Matthew-Marsicano/BEACON_PhoneModule/docs/DESIGN_NOTES.md

# BEACON Phone Module: KiCad translation and completion notes

- **Schematic source:** `C:\Users\marsi\Downloads\BeaconPhoneModule.pdf` (Altium, 9 sheets, 11/2/2026).
- **Enclosure:** `beacon_phone_magsafe_2p5mm_Latest.scad`, a MagSafe puck on the back of the phone.

Everything in the KiCad project is generated by the scripts in `scripts/`. Edit `design.py`, `parts.py` or `build_pcb.py` and regenerate; don't hand-edit the schematics or the board.

```
D:\KiCAD\bin\python.exe -I scripts\design.py      # schematics, BEACON.kicad_sym, BEACON.pretty
D:\KiCAD\bin\python.exe -I scripts\build_pcb.py   # outline, holes, footprints, RF chains, placement
D:\KiCAD\bin\python.exe -I scripts\route.py       # fanout, planes, rules, Freerouting, stitching, pours
D:\KiCAD\bin\python.exe -I scripts\finish.py      # silkscreen clean-up, labels, zone refill
D:\KiCAD\bin\python.exe -I scripts\export_fab.py  # Gerbers/drill zip, JLC BOM + CPL, PDFs, STEP
```

## Inferred specifications (no spec document was supplied)
| Item | Value |
|---|---|
| Form factor | MagSafe puck: 59.2 × 82.65 × 14.3 mm PETG, N52 ring and clocking magnet in the floor |
| Board | 55 × 78.45 × 1.6 mm, 4-layer JLC04161H-7628, r = 3 mm corners, 1.5 × 7.1 mm notch for the TX jack, 4× M2 into heat-set inserts |
| Host link | USB-C receptacle (GCT USB4105) at the bottom edge; short C-to-C cable to the phone; USB 2.0 FS; 5 V at about 0.33 A |
| TX | LMX2582 2.4 GHz CW → 3 dB pad → CC2595 (about +20 dBm) → LPF → Cinch 142-0711-821 end-launch SMA → Taoglas GW.26.0111 monopole |
| RX | Taoglas WDP.2458.25.4 25 × 25 mm ceramic patch at the board centre (pin-fed, fed from B.Cu) → BPF → QPL9547 LNA → nRF52840 |
| Control | nRF52840 (LDO mode): SPI to the synth, PA_EN, LNA shutdown, 2× INA219, LED, button, UART and SWD test pads |
| Power | 5V_BUS → 50 mΩ / INA219 0x40 → 5V0 → LT80602 (FCM, 506 kHz) → 3V3_OUT → 50 mΩ / INA219 0x41 → 3V3 |

## Changes from the Altium drawing
**Fixes (the original would not have worked):**
1. **The CC2595 RF_OUT had no DC feed.** Added 12 nH from VDD_PA, non-magnetic (LQW15AN12NJ00D).
2. **The CC2595 RBIAS resistors went to GND.** They now go through 20k to VDD_PA, per the TI EM.
3. **The LT80602 exposed pad is VIN,** so it connects to 5V0. The FB divider was 681k/220k but RFB-BOT can be at most 205k; it is now 634k/200k. FCM mode with a 0.1 µF BST cap.
4. **The 5 V INA219 measured nothing,** because the buck tapped 5V_BUS ahead of the shunt. The buck now runs from 5V0.
5. **The wearable-only MCU nets were removed:** CTRL_SPDT, Mod_Sel, PMIC_Status, Sensor_*, QSPI_CLK.
6. **The CW synth sheet is complete:**
   - TCXO, decoupling, OUTA/OUTAM.
   - Loop filter designed for a 52 MHz PFD and 7.27 mA charge pump: about 59 kHz bandwidth, 62° phase margin.
7. **Top-sheet TODOs:**
   - TX/RX antenna connections: the patch and the edge SMA, per the enclosure.
   - PA GND connected.
   - MCU and synth completed.

**Enclosure-driven changes:**
- **USB-C plug → receptacle,** with CC1 and CC2 Rd. The puck connects by cable.
- **Ferrite parts out of the magnet field** (`docs/magnetics_thermal.md`):
  - The nRF DC/DC inductors are DNP, and REG1 runs in LDO mode (firmware DCDCEN = 0).
  - The three ferrite beads became 1 Ω (PA), 10 Ω (LNA) and 0 Ω (synth) with the existing caps.
  - The buck inductor, crystal and TCXO are kept out of the clocking-bar zone.
- **Patch feed:** runs on B.Cu over a GND island on L3, then through one RF via to L1. Pi-match footprints sit at the patch.
- **SMA launch:** has an L3 GND island under it (L2 is voided in the footprint).

**Other improvements:**
- 50 mΩ shunts.
- LNA on 5V0 and off at reset.
- PA and synth off at reset.
- RX overload pi pad (DNP shunts).
- DNP ESD chokes at both antennas.
- 33 Ω series resistors on the SPI lines.
- USB pair renamed `USB_D+`/`USB_D-`.

## Supporting documents
- `enclosure_constraints.md/.json`: board outline, holes, keepouts and height limits, extracted with OpenSCAD.
- `antenna_connectors.md`, plus the reviewed footprints in `proposed_footprints/` (copied into `BEACON.pretty`).
- `magnetics_thermal.md`: field map, part sensitivities, thermal budget (about 1.6 W, board 53–55 °C) and firmware limits.
- `footprint_review.md`, `schematic_review.md`, `lmx2582_loop_filter.md`, `stackup_and_rules.md`.

## Open items before ordering
- **Patch tuning:**
  - Tune the patch match with a VNA, in the closed enclosure, on a phone. The patch is narrow (about 20–25 MHz at −10 dB), so keep the RX channels at 2430–2455 MHz.
  - Confirm the patch polarisation axis against the TX monopole.
- **Regulatory and exposure:** +20 dBm CW needs frequency hopping (FCC 15.247) and an RF-exposure evaluation at 5 mm.
- **Firmware thermal limits:** throttle TX at 60 °C, turn off at 68 °C, and default to a 25–50 % TX duty cycle.
- **Magnet field check:** measure the field over the board area with a Hall probe. If the ring band reads above 20 mT, keep all ferrites away from it.
- **JLC options:** POFV via-in-pad for the nRF52840 inner balls; ENIG finish; impedance control (0.30/0.20 mm CPWG); confirm the 0.45 mm plated slot.
- **Enclosure:** apply the USB and SMA dimension corrections (`enclosure/CHANGES.md`).
