Matthew-Marsicano/BEACON_PhoneModule/docs/layout_review/power_after.png

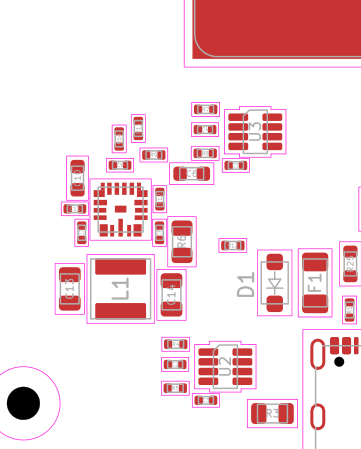
docs/layout_review/power_after.png
