Matthew-Marsicano/BEACON_PhoneModule/docs/layout_review/power_before.png

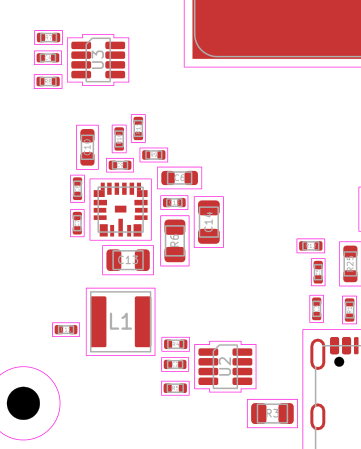
docs/layout_review/power_before.png
