Matthew-Marsicano/BEACON_PhoneModule/docs/layout_review/ref_lt80602_fig73.png

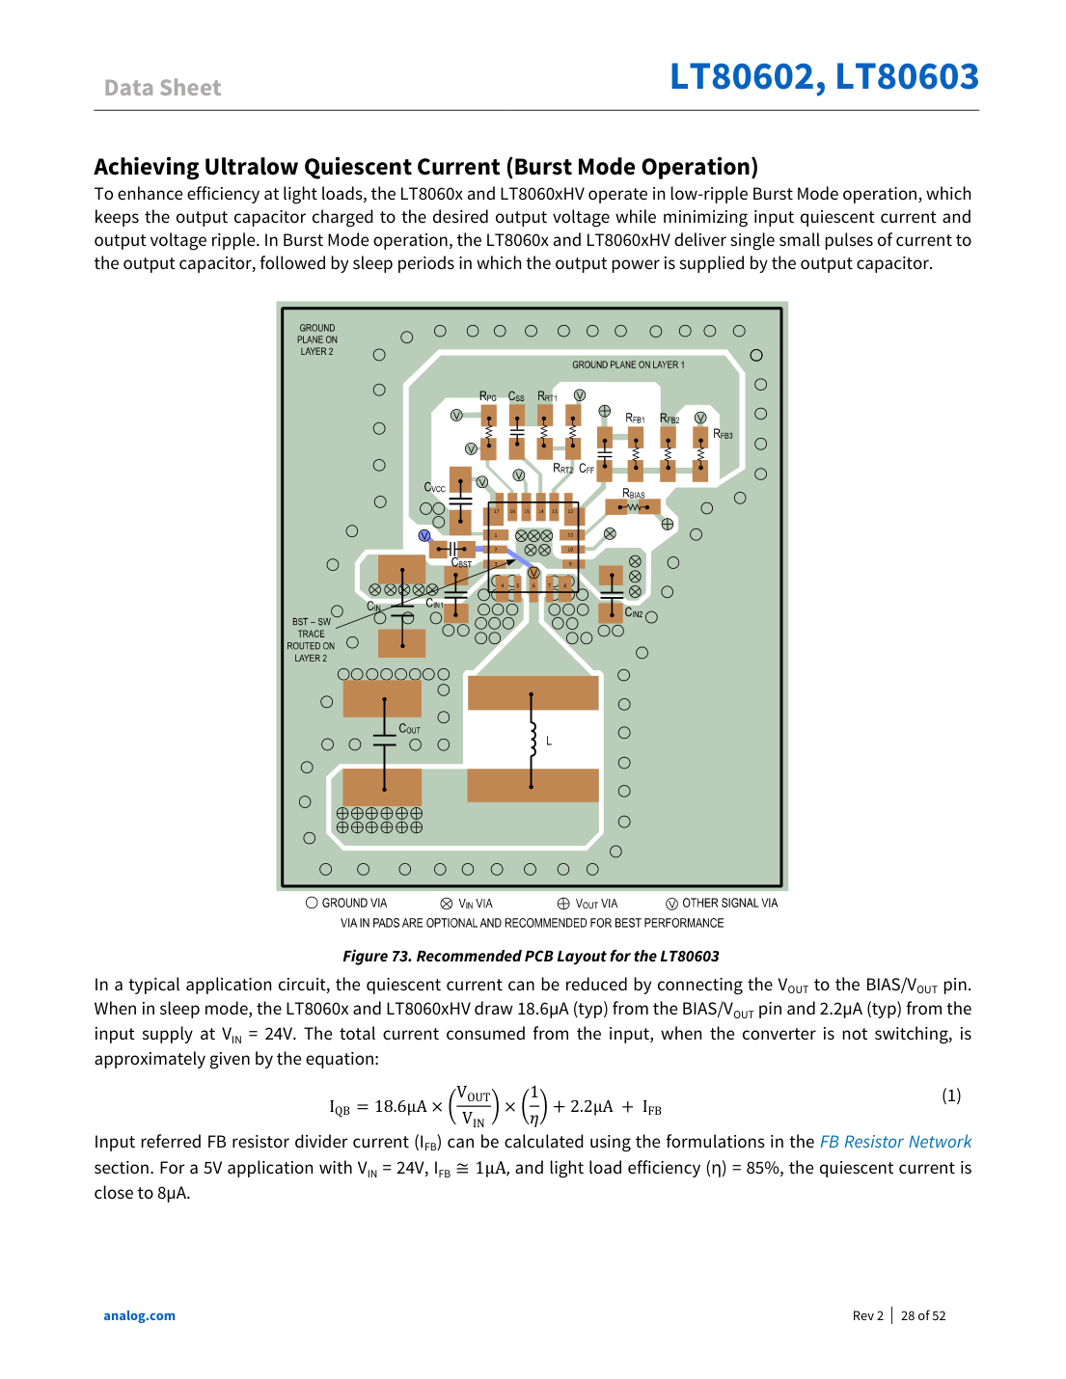
docs/layout_review/ref_lt80602_fig73.png
