Matthew-Marsicano/BEACON_PhoneModule/docs/layout_review/u4_after.png

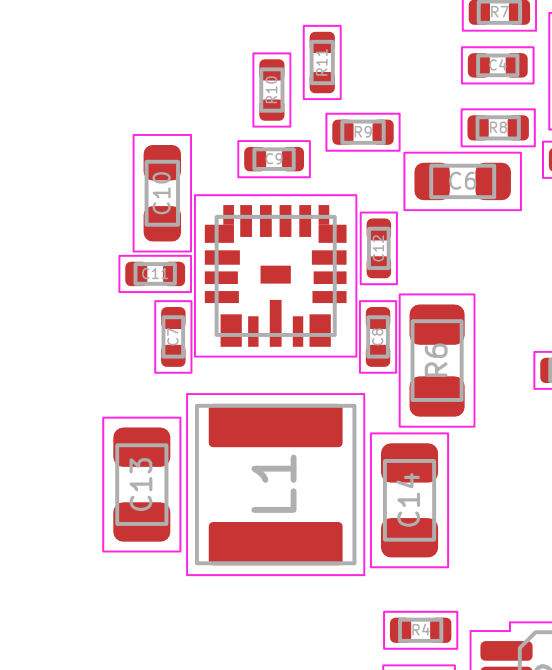
docs/layout_review/u4_after.png
