Matthew-Marsicano/BEACON_PhoneModule/docs/layout_review/u4_before.png

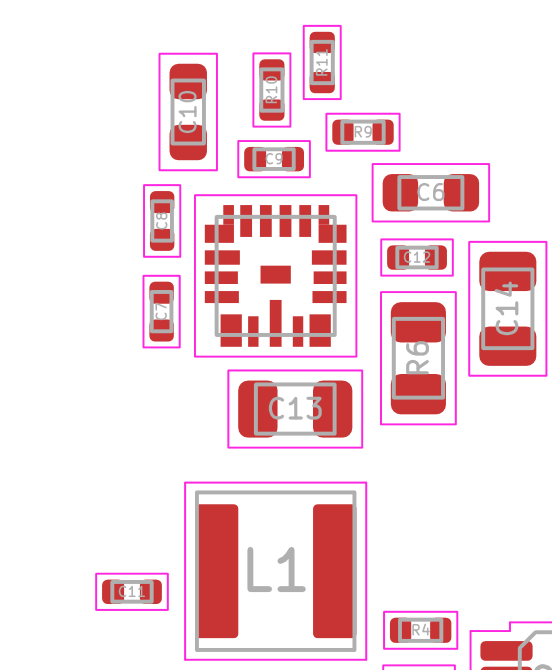
docs/layout_review/u4_before.png
