Matthew-Marsicano/BEACON_PhoneModule/docs/layout_review/u5_after.png

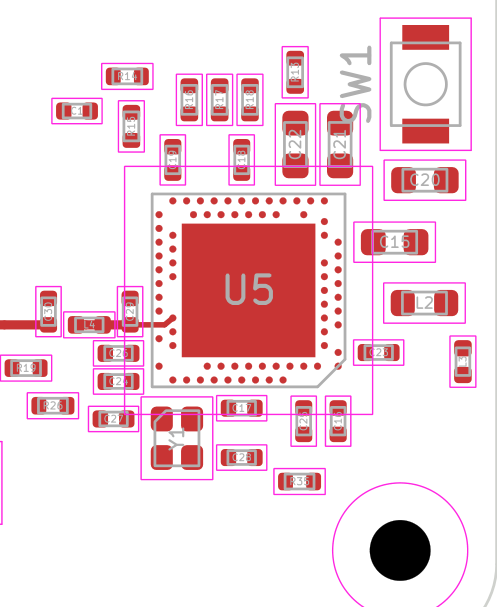
docs/layout_review/u5_after.png
