Matthew-Marsicano/BEACON_PhoneModule/docs/layout_review/u5_before.png

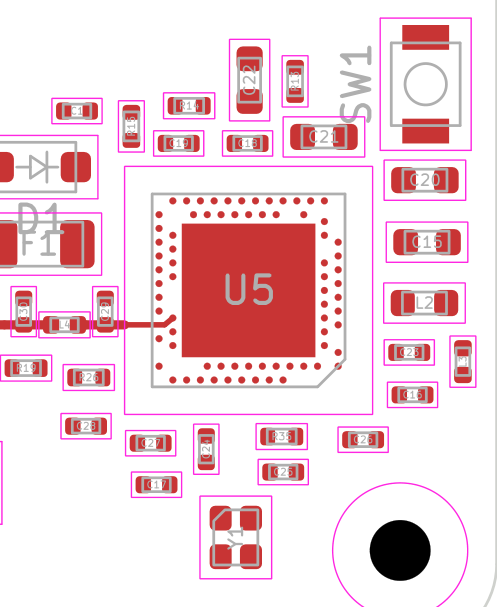
docs/layout_review/u5_before.png
