Matthew-Marsicano/BEACON_PhoneModule/docs/layout_review/u7_after.png

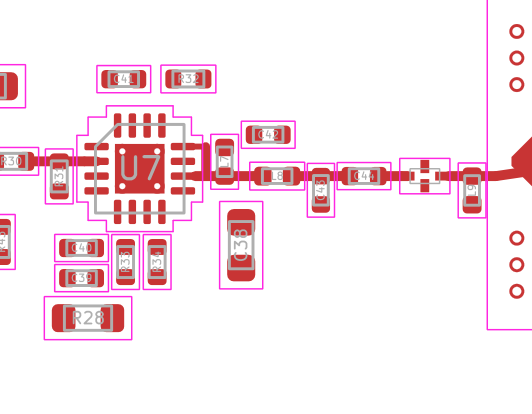
docs/layout_review/u7_after.png
