Matthew-Marsicano/BEACON_PhoneModule/docs/layout_review/u7_before.png

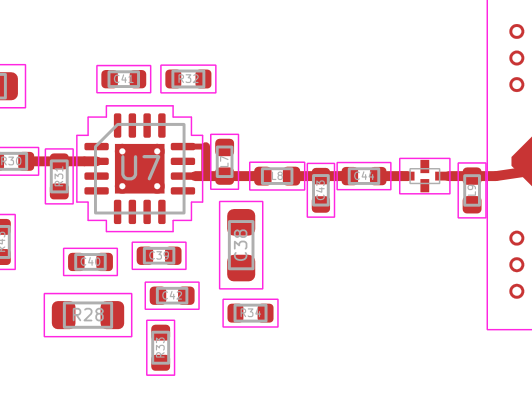
docs/layout_review/u7_before.png
