Matthew-Marsicano/BEACON_PhoneModule/docs/layout_review/u8_after.png

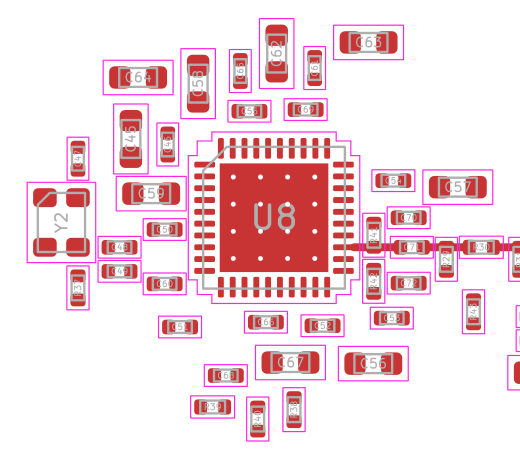
docs/layout_review/u8_after.png
