Matthew-Marsicano/BEACON_PhoneModule/docs/layout_review/u8_before.png

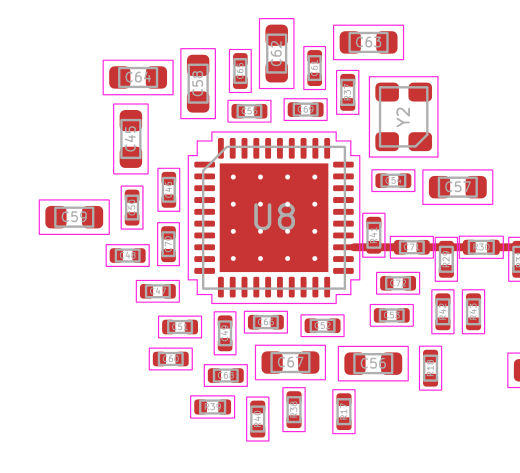
docs/layout_review/u8_before.png
