Matthew-Marsicano/BEACON_PhoneModule/docs/layout_review/usb_after.png

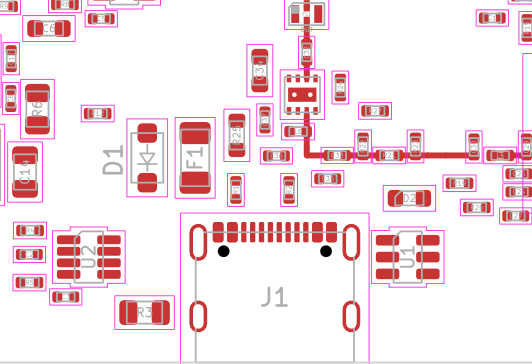
docs/layout_review/usb_after.png
