Matthew-Marsicano/BEACON_PhoneModule/docs/layout_review/usb_before.png

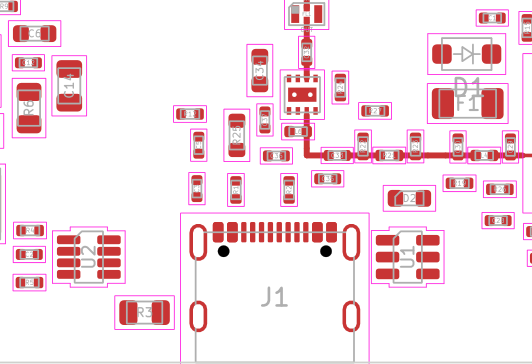
docs/layout_review/usb_before.png
