Matthew-Marsicano/BEACON_PhoneModule/enclosure/fxp70_routing_top.png

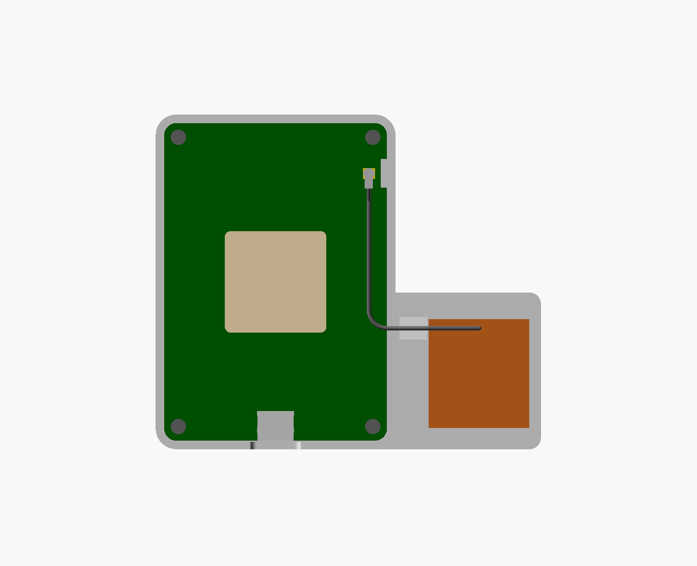
enclosure/fxp70_routing_top.png
