Matthew-Marsicano/BEACON_PhoneModule/enclosure/fxp70_section_cable.png

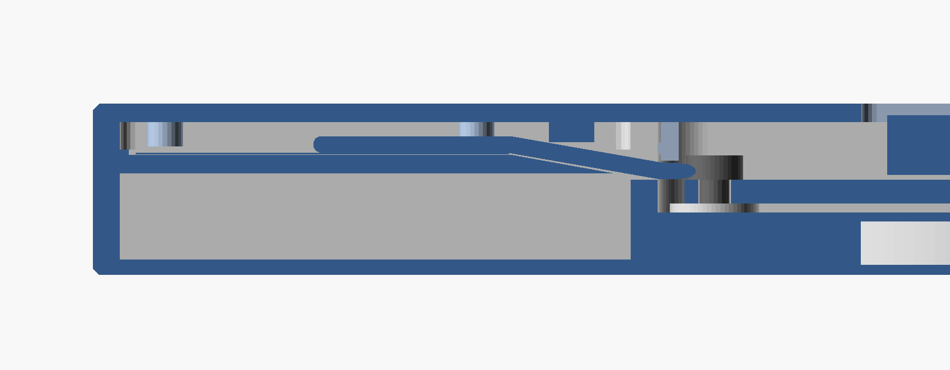
enclosure/fxp70_section_cable.png
