Matthew-Marsicano/BEACON_PhoneModule/enclosure/fxp70_section_flex.png

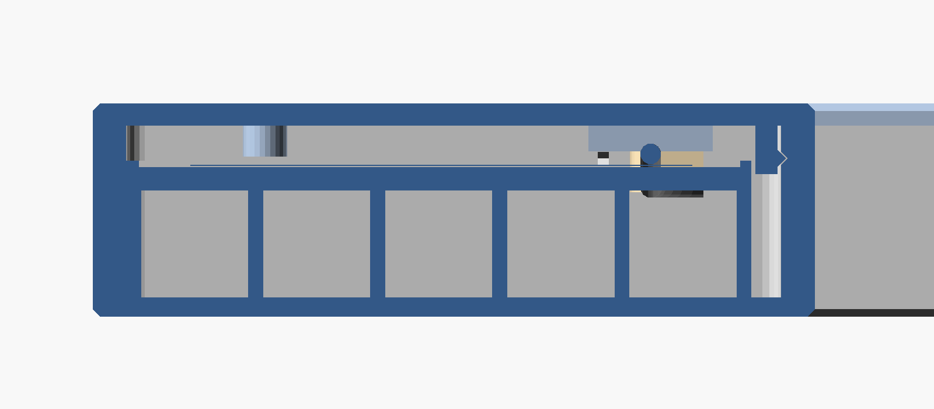
enclosure/fxp70_section_flex.png
