Matthew-Marsicano/BEACON_PhoneModule/enclosure/inlid_lid_underside.png

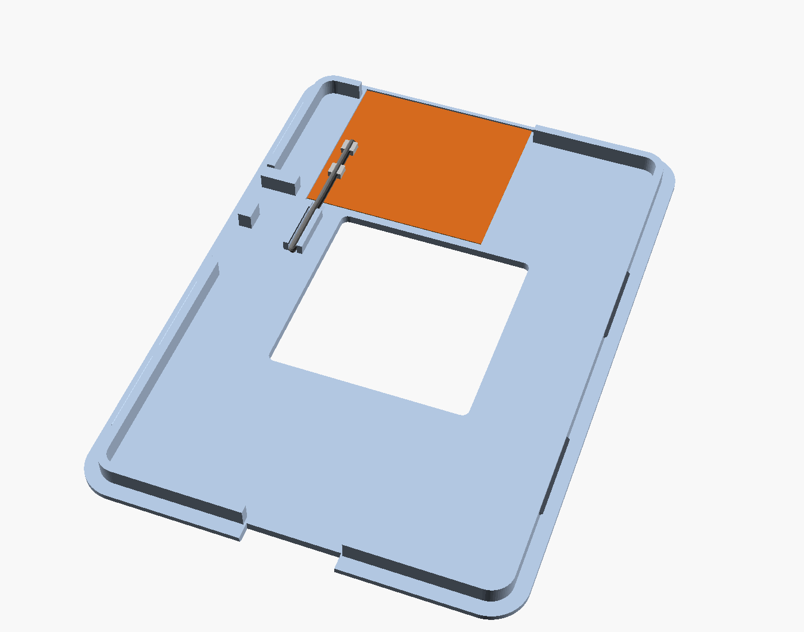
enclosure/inlid_lid_underside.png
