Matthew-Marsicano/BEACON_PhoneModule/enclosure/inlid_routing_top.png

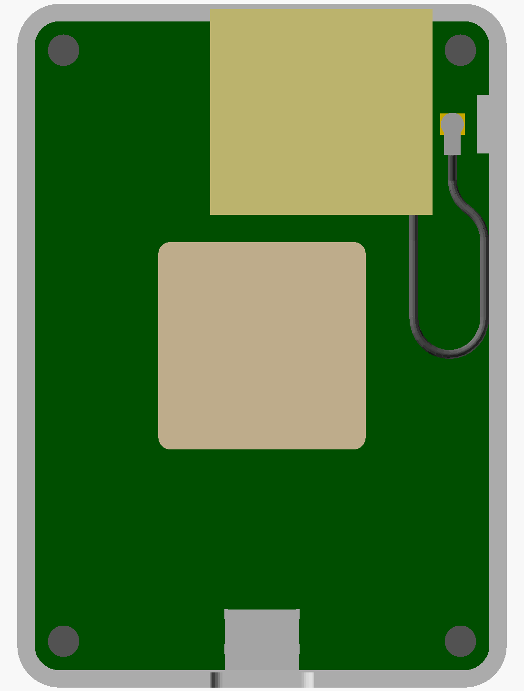
enclosure/inlid_routing_top.png
