Matthew-Marsicano/BEACON_PhoneModule/enclosure/inlid_section_exit.png

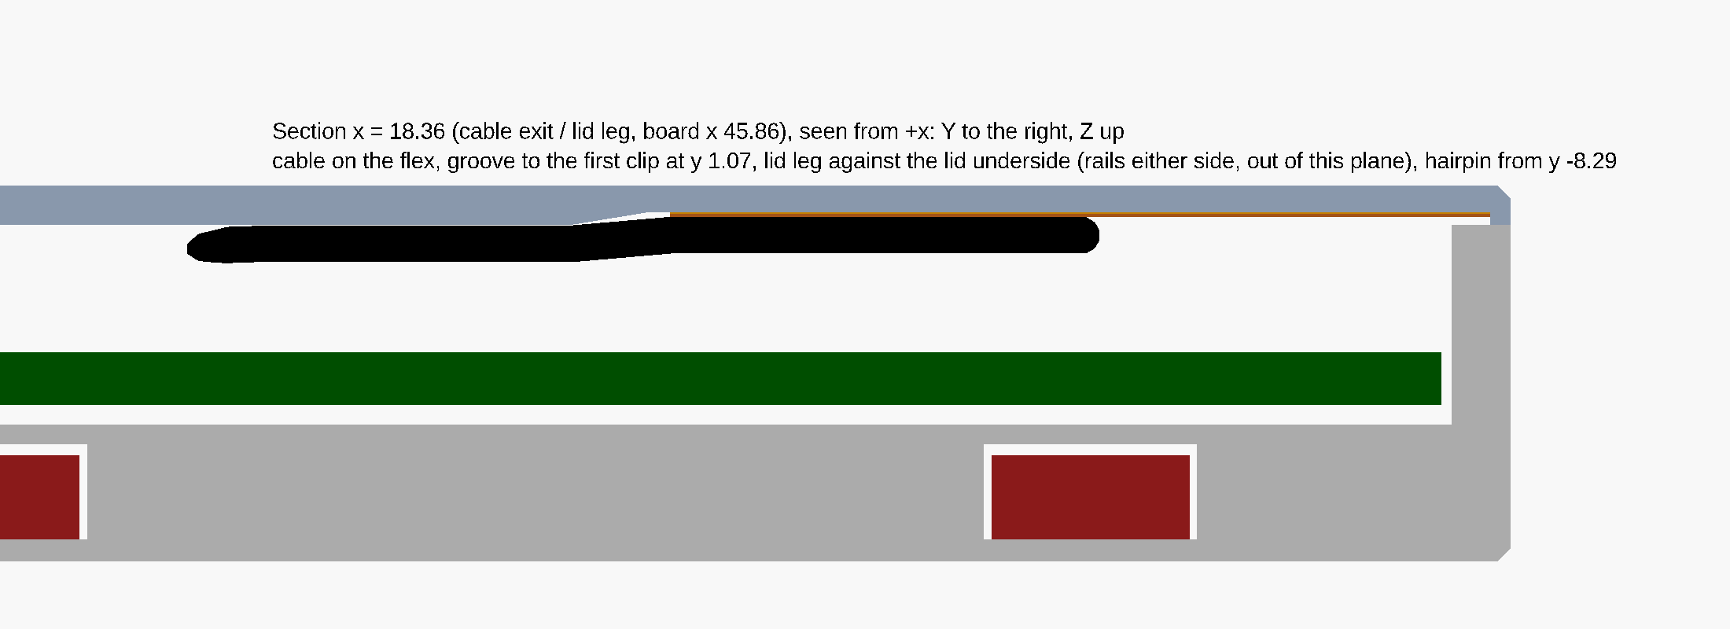
enclosure/inlid_section_exit.png
