Matthew-Marsicano/BEACON_PhoneModule/enclosure/inlid_section_flex.png

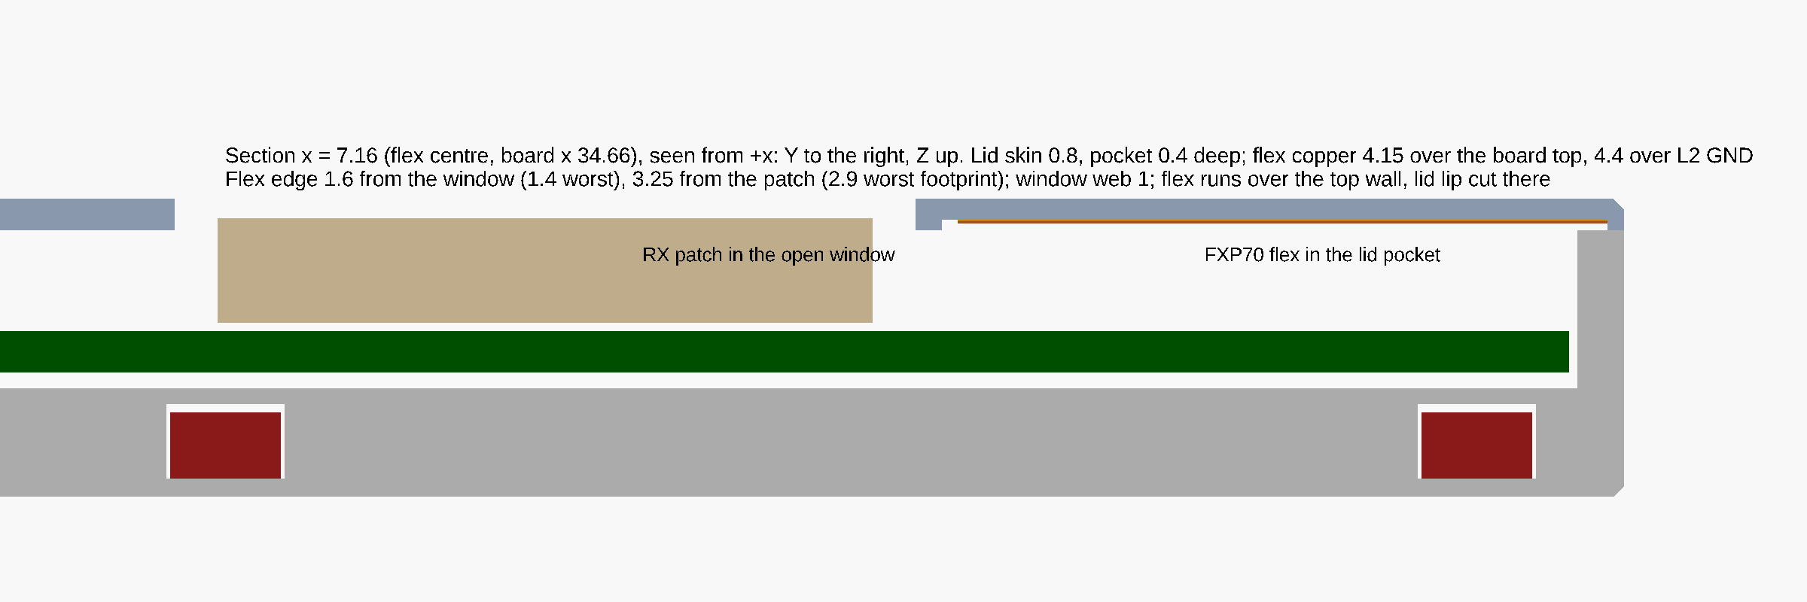
enclosure/inlid_section_flex.png
