Matthew-Marsicano/BEACON_PhoneModule/enclosure/inlid_section_hairpin.png

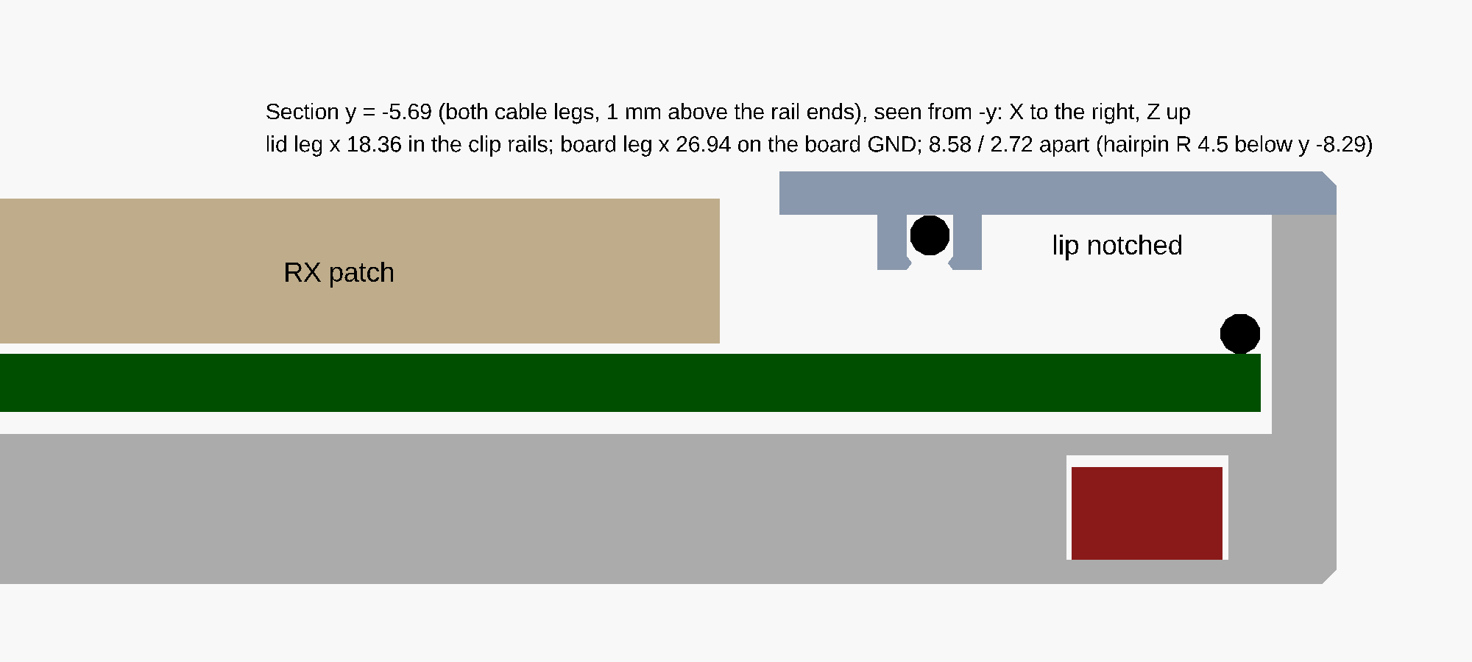
enclosure/inlid_section_hairpin.png
