Matthew-Marsicano/BEACON_PhoneModule/enclosure/lowprofile_section_patch.png

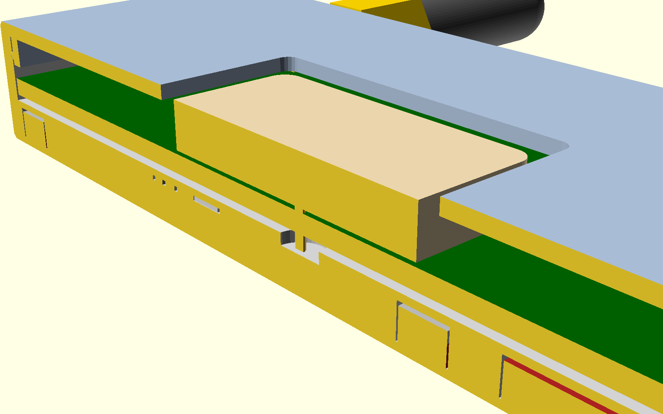
enclosure/lowprofile_section_patch.png
