Matthew-Marsicano/BEACON_PhoneModule/enclosure/lowprofile_section_sma.png

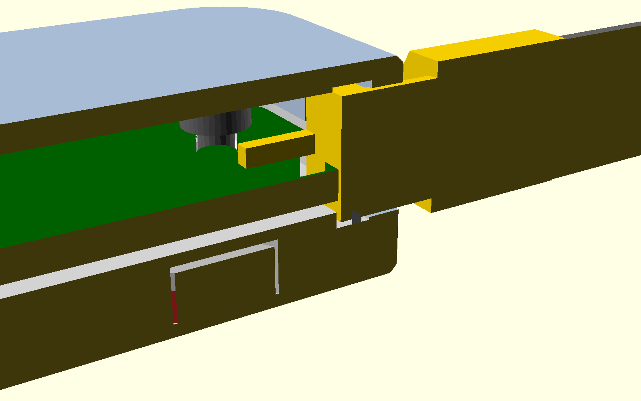
enclosure/lowprofile_section_sma.png
