Matthew-Marsicano/BEACON_PhoneModule/enclosure/lowprofile_section_sma_leg.png

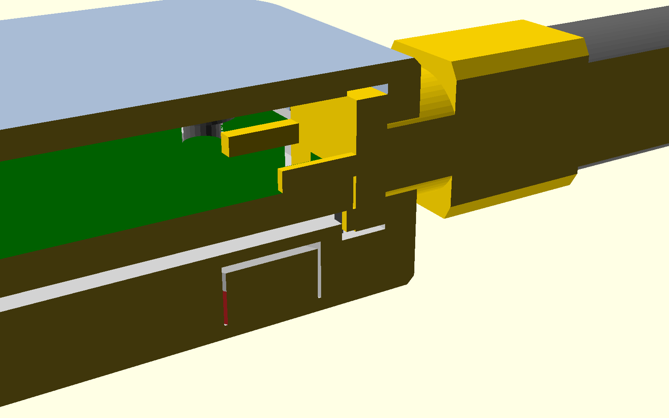
enclosure/lowprofile_section_sma_leg.png
