Matthew-Marsicano/BEACON_PhoneModule/enclosure/rev_pcb_lid_vents_on.png

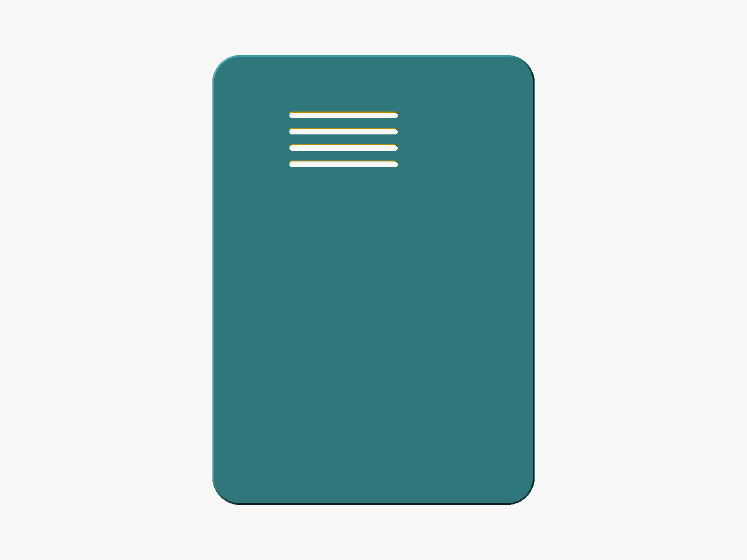
enclosure/rev_pcb_lid_vents_on.png
