Matthew-Marsicano/BEACON_PhoneModule/enclosure/rev_pcb_section.png

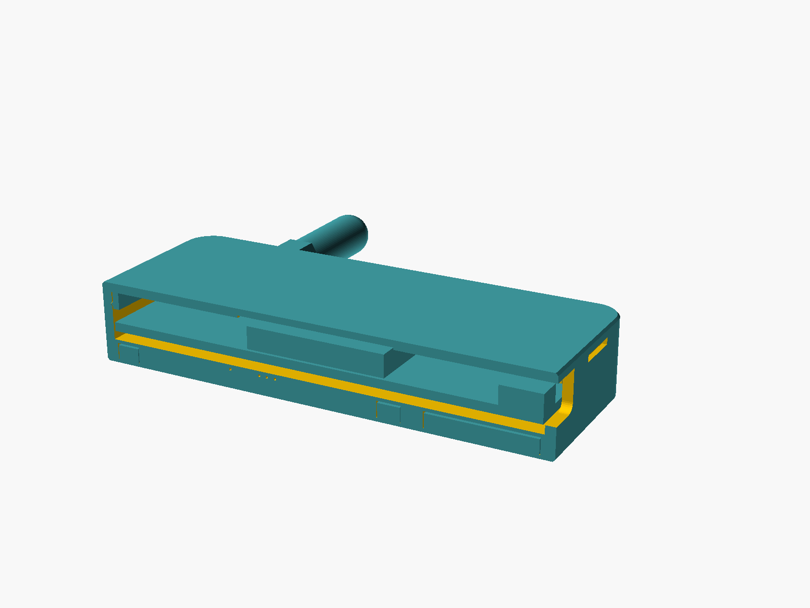
enclosure/rev_pcb_section.png
