Matthew-Marsicano/BEACON_PhoneModule/enclosure/rev_pcb_section_preview.png

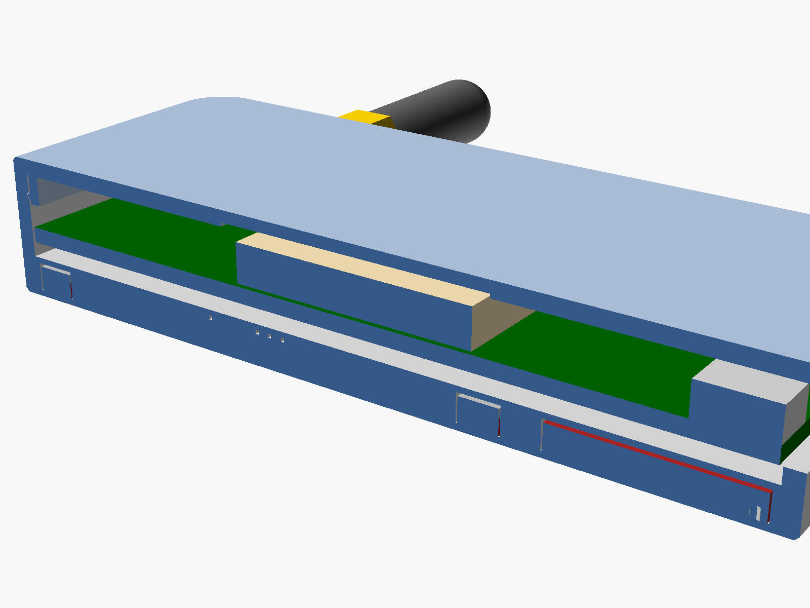
enclosure/rev_pcb_section_preview.png
