Matthew-Marsicano/BEACON_PhoneModule/enclosure/rev_pcb_tx_jack_section.png

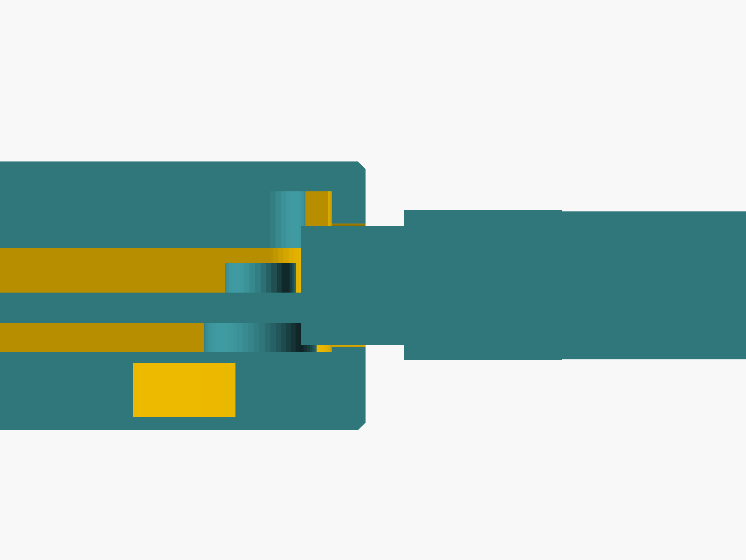
enclosure/rev_pcb_tx_jack_section.png
