Matthew-Marsicano/BEACON_PhoneModule/enclosure/round_bottom_iso.png

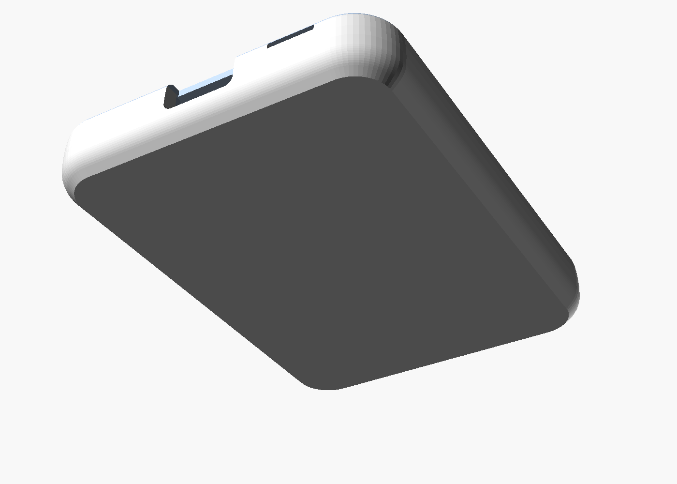
enclosure/round_bottom_iso.png
