Matthew-Marsicano/BEACON_PhoneModule/enclosure/round_closed_iso.png

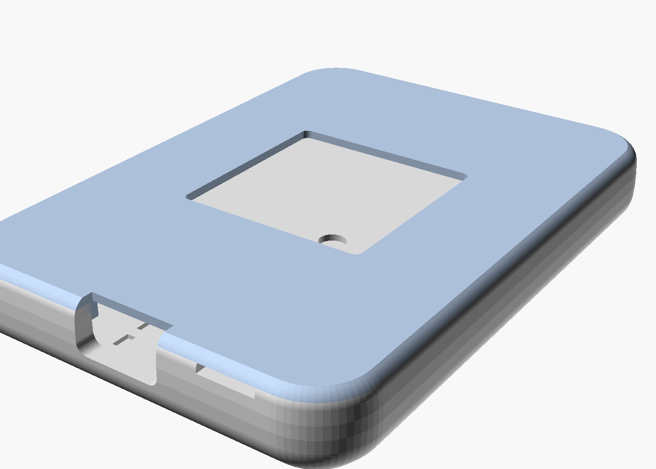
enclosure/round_closed_iso.png
