Matthew-Marsicano/BEACON_PhoneModule/enclosure/round_end.png

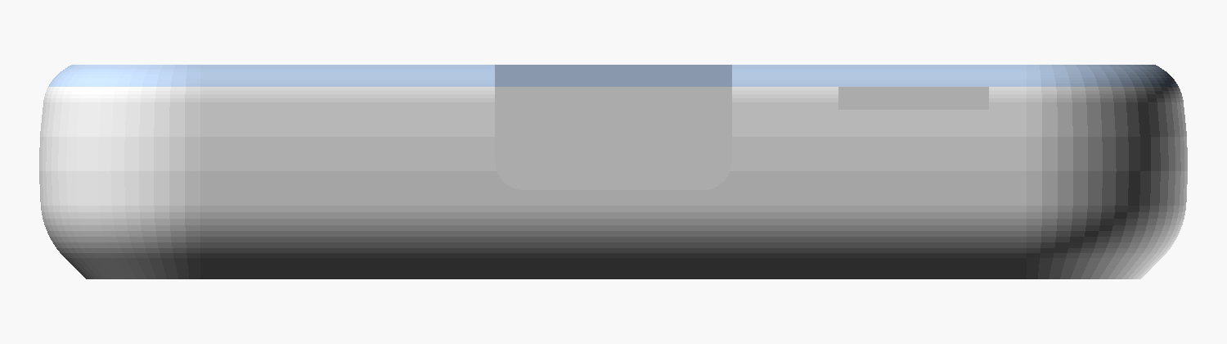
enclosure/round_end.png
