Matthew-Marsicano/BEACON_PhoneModule/enclosure/round_profile.png

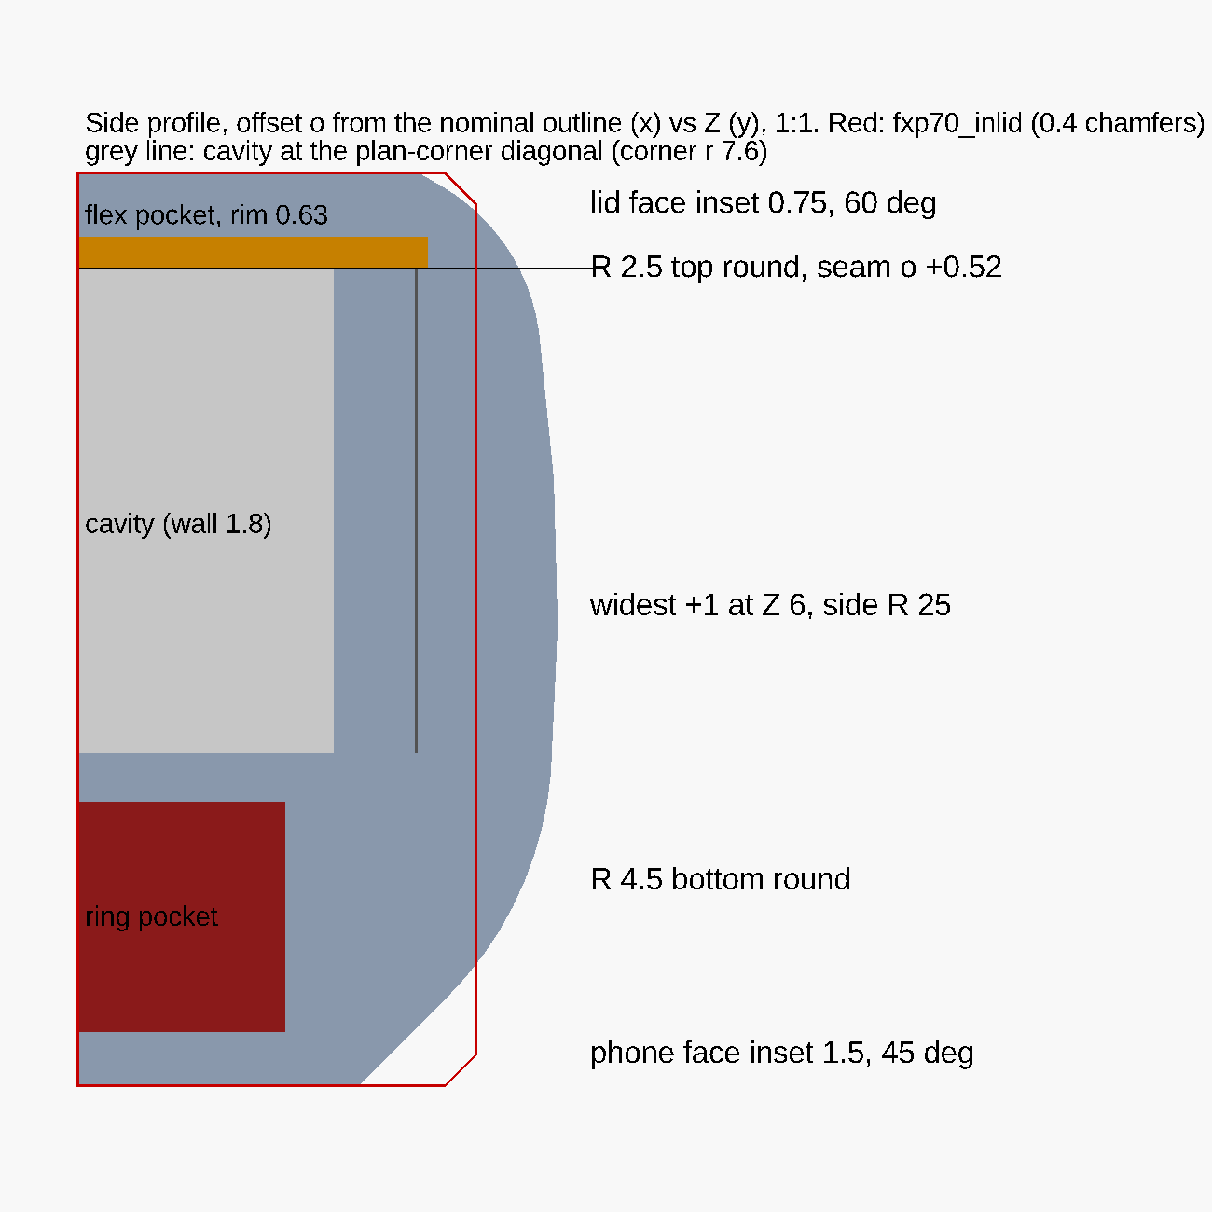
enclosure/round_profile.png
