Matthew-Marsicano/BEACON_PhoneModule/enclosure/round_section_edge.png

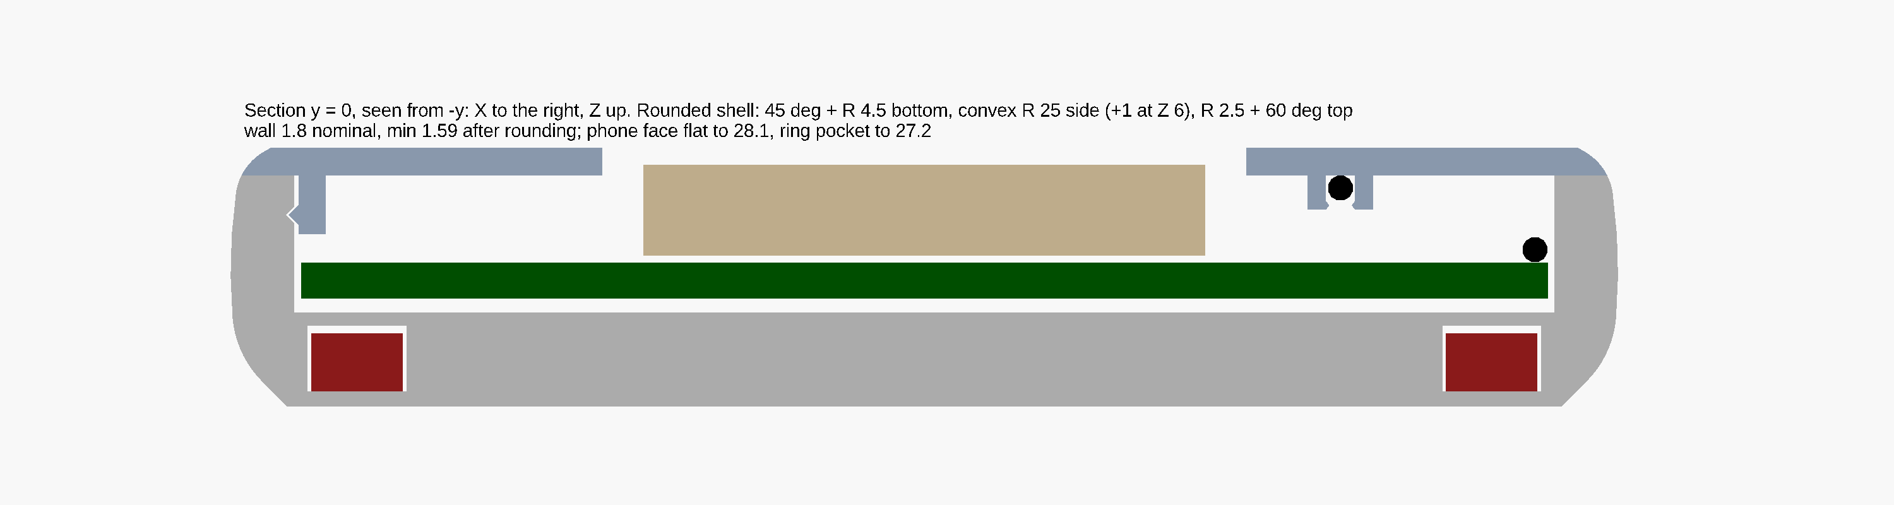
enclosure/round_section_edge.png
