Matthew-Marsicano/BEACON_PhoneModule/enclosure/round_section_flex.png

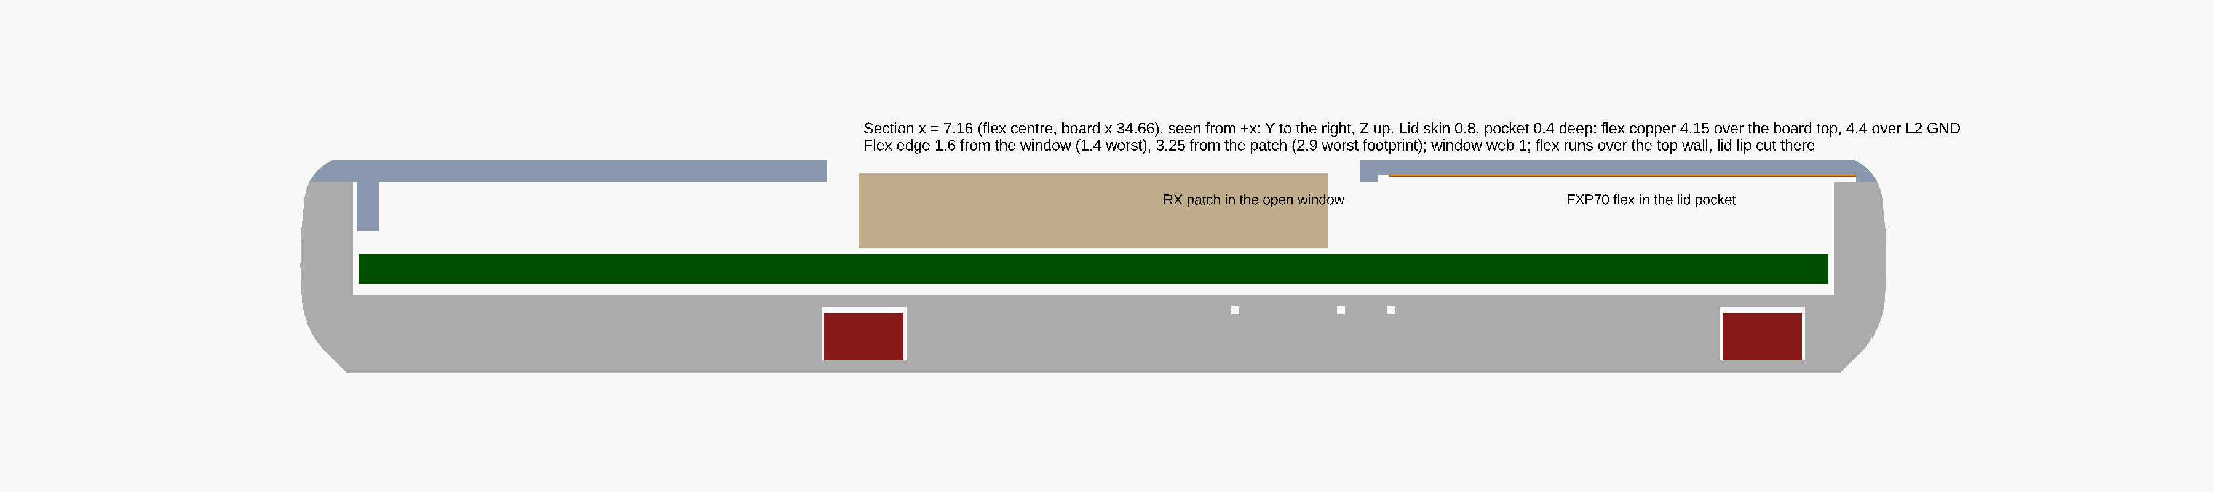
enclosure/round_section_flex.png
