Matthew-Marsicano/BEACON_PhoneModule/enclosure/round_section_flex_detail.png

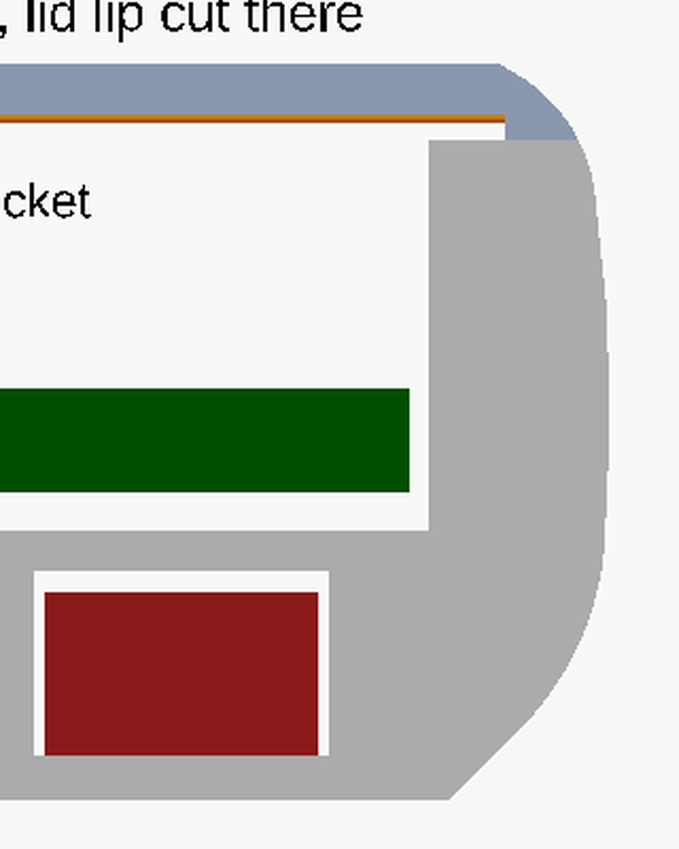
enclosure/round_section_flex_detail.png
