Matthew-Marsicano/BEACON_PhoneModule/enclosure/round_side.png

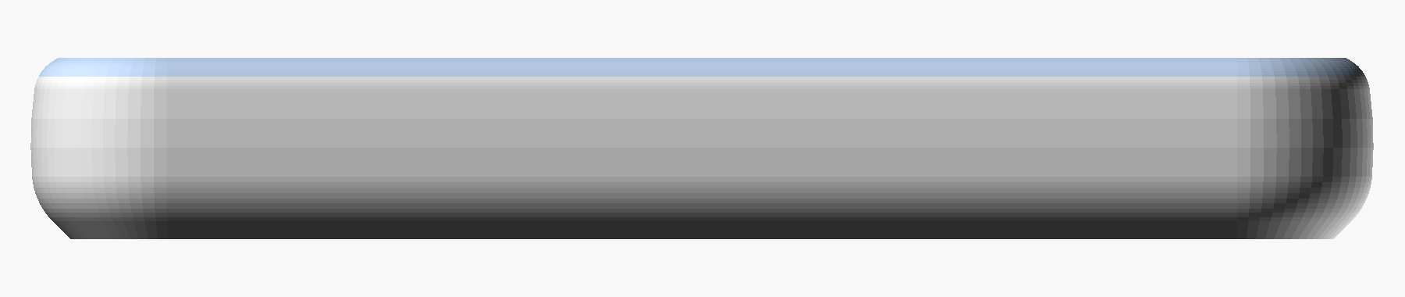
enclosure/round_side.png
