Matthew-Marsicano/BEACON_PhoneModule/fab/panel/preview_bottom.png

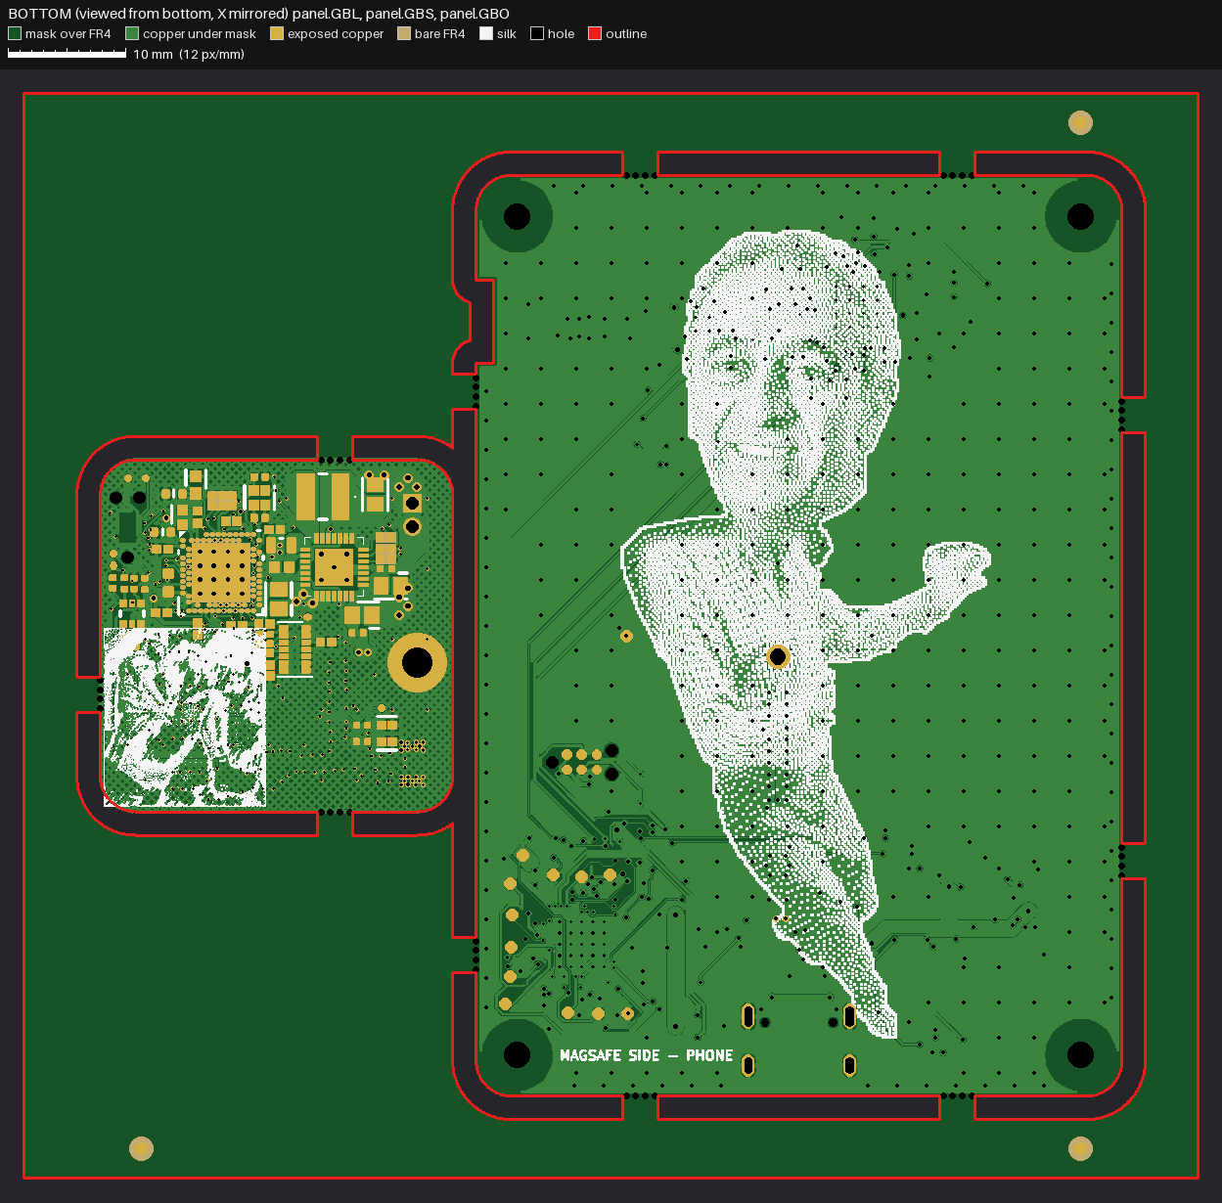
fab/panel/preview_bottom.png
