Matthew-Marsicano/BEACON_PhoneModule/fab/panel/preview_outline_drill.png

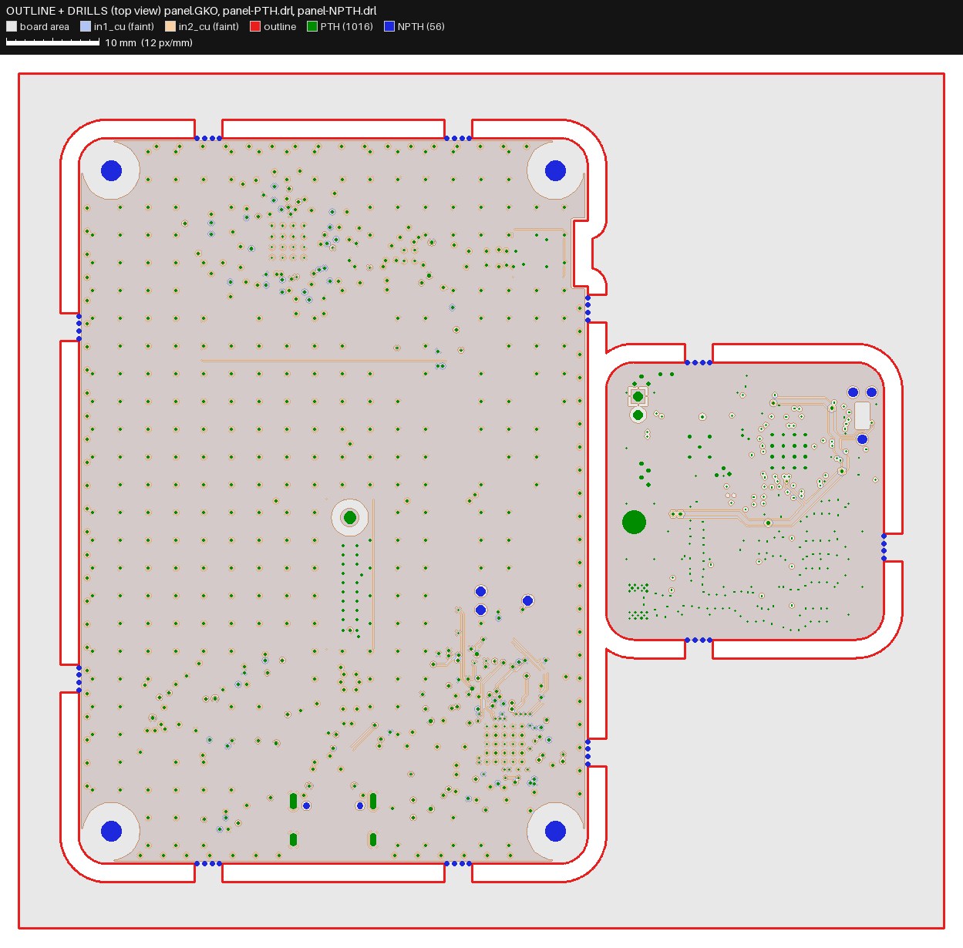
fab/panel/preview_outline_drill.png
