Matthew-Marsicano/BEACON_PhoneModule/fab/panel/preview_top.png

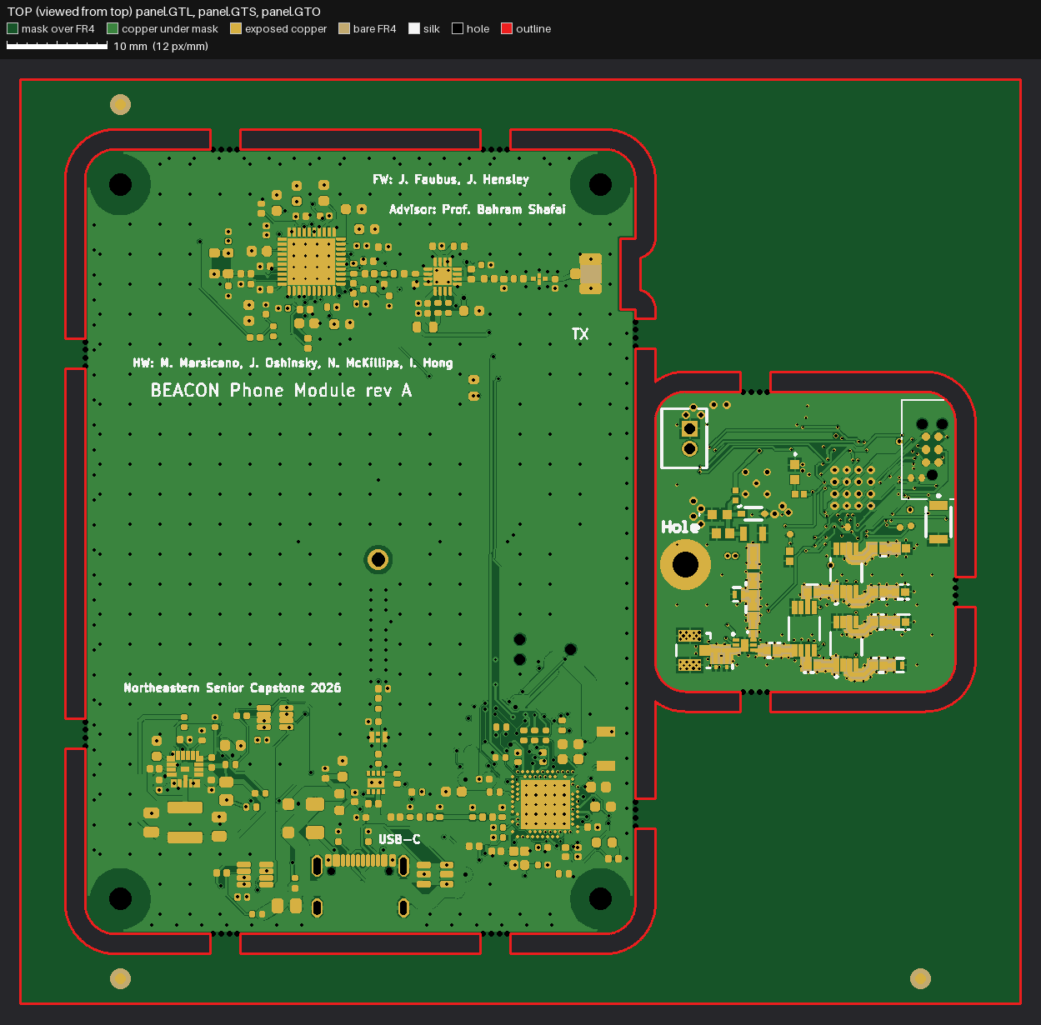
fab/panel/preview_top.png
