Matthew-Marsicano/BEACON_PhoneModule/fab/JLCPCB_ORDER.md

# BEACON Phone Module: JLCPCB order sheet

## Files to upload

Use the three files below, either from `fab/` in the repository or from `BEACON_PhoneModule_JLCPCB.zip`
(unzip it first; inside it they are numbered 1-3).

**Don't upload `BEACON_PhoneModule_JLCPCB.zip` itself as the Gerber file.** The Gerbers sit in a zip inside
it, and JLC doesn't look inside nested zips, so it reports "0 layers detected".

| Step on jlcpcb.com | File in `fab/` | Name inside the package zip |
|---|---|---|
| 1. Add Gerber file | `BEACON_PhoneModule_gerbers.zip` (upload as is, don't unzip) | `1_UPLOAD_AS_GERBER_...` |
| 2. PCB Assembly: BOM | `BEACON_PhoneModule_BOM_JLC.csv` | `2_UPLOAD_AS_BOM_...` |
| 3. PCB Assembly: CPL | `BEACON_PhoneModule_CPL_JLC.csv` | `3_UPLOAD_AS_CPL_...` |

After step 1, JLC should show **4 layers, 55 x 78.45 mm**.

## PCB options

| Option | Setting |
|---|---|
| Base material | FR-4 |
| Layers | 4 |
| Dimensions | 55 x 78.45 mm (detected from the Gerbers) |
| Thickness | 1.6 mm |
| Impedance control | Yes, stackup **JLC04161H-7628** (the 50 ohm RF CPWG is sized for it) |
| Via covering | **Epoxy filled & capped (via-in-pad, POFV): required**, the nRF52840 has vias in its pads |
| Min via hole / diameter | 0.15 mm / 0.3 mm |
| Surface finish | **ENIG** |
| Outer copper | 1 oz |
| Inner copper | 0.5 oz |
| Mark on PCB | Remove mark, or specify a location, so the order number doesn't land on the silkscreen or logo |
| Everything else | Default |

## Assembly

| Item | What to do |
|---|---|
| Type | Standard PCBA, top side, JLC-added tooling holes |
| J3 (U.FL) | The BOM has no LCSC number: search `U.FL-R-SMT-1(10)` (Hirose) and select it |
| AE1 (patch antenna) | Taoglas WDP.2458.25.4, not stocked at LCSC. Set "do not place" and solder it yourself, or supply it as a consigned part |
| Placement preview | Check pin 1 of every IC against the board marking (U4-U8, filters FL1/FL2, USB-C J1). QFN/SOT rotations are often off by 90 or 180 degrees; rotate them in the viewer if needed |

Then review the DFM report and the price, and place the order.

## Not on the board

The Taoglas FXP70.07.0053A flex antenna (TX) is ordered separately. It plugs into J3 at final assembly.

---
Generated by `scripts/jlc_bundle.py`; edit the text there, not here.
