Matthew-Marsicano/BEACON_PhoneModule/fab/panel/BEACON_Panel_BOM_JLC_wearable_only.csv

Comment | Designator | Footprint | LCSC Part # | MPN | Manufacturer | Board | Notes
1uF | C37_W,C38_W | 0402 | C52923 | CL05A105KA5NQNC | Samsung Electro-Mechanics | W
100nF | C10_W,C24_W,C26_W,C29_W,C30_W,C36_W | 0402 | C1525 | CL05B104KO5NNNC | Samsung Electro-Mechanics | W
4.7uF | C28_W | 0603 | C19666 | CL10A475KO8NNNC | Samsung Electro-Mechanics | W
22uF | C1_W | 0805 | C45783 | CL21A226MAQNNNE | Samsung Electro-Mechanics | W | The schematic part is generic (22uF 16V 0805). This one is 25V X5R.
100pF | C27_W,C33_W,C34_W | 0402 | C1546 | 0402CG101J500NT | FH | W | SUB for CL05C101JB5NNNC (C26409, extended). Same 100pF 50V C0G 5% 0402.
12pF | C22_W,C25_W | 0402 | C1547 | 0402CG120J500NT | FH | W
0.5pF | C19_W | 0402 | C76911 | GJM1555C1HR50BB01D | Murata | W | The schematic part is generic (0.5pF +/-0.1pF 0402). This is the Murata GJM high-Q C0G part, the same one the phone module uses.
Red | D3_W | LED_0603 | C2286 | KT-0603R | Hubei KENTO | W
10k | R23_W | 0402 | C25744 | 0402WGF1002TCE | UNI-ROYAL | W | SUB for Panasonic ERJ-U02F1002X (anti-sulfur). Same 10k 1% 0402, but not sulfur-resistant.
4.7k | R21_W,R22_W | 0402 | C25900 | 0402WGF4701TCE | UNI-ROYAL | W
100k | R24_W | 0402 | C25741 | 0402WGF1003TCE | UNI-ROYAL | W | The schematic part is generic (100k 1% 0402).
1.5k | R16_W | 0402 | C25867 | 0402WGF1501TCE | UNI-ROYAL | W | SUB for Vishay CRCW04021K50FKED. Same 1.5k 1% 0402.
0 | R2_W,R3_W,R10_W,R11_W,R12_W,R15_W,R17_W,R18_W | 0402 | C17168 | 0402WGF0000TCE | UNI-ROYAL | W | R1 is DNP in the Prod variant and is left out.
B3U-1000P | SW1_W | SW_B3U-1000P | C231329 | B3U-1000P | OMRON | W
nRF52840-QIAA | U5_W | AQFN-73_7x7mm | C190794 | NRF52840-QIAA-R | Nordic Semiconductor | W | The schematic lists nRF52840-QIAAF0. C190794 is the QIAA reel part. Confirm the revision.
32MHz | Y1_W | Crystal_2016 | C1985774 | ABM11W-32.0000MHZ-8-B1U-T3 | ABRACON | W
SN74AUP2G04DCKR | B1_W | TSSOP-6 | C2865392 | SN74AUP2G04DCKR | Texas Instruments | W | SWAP: was Nexperia 74AUP2G04GW-Q100H (JLC stock 0). Same AUP family, SC-70-6 land, same pinout.
GRF6011 | B2_W | DFN-6_1.5x1.5mm | C22400840 | GRF6011 | Guerrilla RF | W | FLAG: JLC stock 0 (consign-only listing). Supply it yourself (consign) or hand-solder it.
10uF | C2_W,C7_W,C8_W,C9_W | 0805 | C95841 | CL21B106KOQNNNE | Samsung Electro-Mechanics | W | Exact MPN, JLC stock 157,184. Basic alternative: C15850 (CL21A106KAYNNNE, 25V X5R).
1.5pF | C3_W | 0402 | C76900 | GJM1555C1H1R5BB01D | Murata | W
10pF | C4_W,C11_W,C12_W,C13_W,C14_W,C15_W,C16_W,C17_W | 0402 | C85873 | GJM1555C1H100GB01D | Murata | W | JLC stock 15,848.
1uF | C5_W,C21_W,C23_W | 0603 | C15849 | CL10A105KB8NNNC | Samsung Electro-Mechanics | W | C21 and C23 are generic (1uF 50V 0603). C5 is a SUB: KEMET C0603C105K4RACTU (16V X7R, C2167386) is pre-order only. This part is 50V X5R.
100pF | C6_W | 0603 | C71664 | GRM1885C1H101JA01D | Murata | W
3pF | C18_W | 0402 | C88891 | GJM1555C1H3R0BB01D | Murata | W | JLC stock 210,960.
47nF | C20_W | 0603 | C1622 | CL10B473KB8NNNC | Samsung Electro-Mechanics | W
27pF | C31_W,C32_W | 0201 | C85899 | GRM0335C1H270JA01D | Murata | W | JLC stock 85,565. 0201 package.
10uF | C35_W | 0603 | C19702 | CL10A106KP8NNNC | Samsung Electro-Mechanics | W | The schematic part is generic (10uF 10V 0603).
SMS7630-005LF | D1_W | SOT-23 | C2936884 | SMS7630-005LF | Skyworks | W | FLAG: JLC stock is only 22 ($6.32 each), so reserve it now.
MM3Z5V1ST1G | D2_W | SOD-323 | C236206 | MM3Z5V1ST1G | onsemi | W | JLC stock 42,494.
B2B-PH-K-S(LF)(SN) | J1_W | JST_PH_B2B_THT | C131337 | B2B-PH-K-S(LF)(SN) | JST | W | Through-hole part, so the order needs Standard PCBA with THT, or hand-solder it.
U.FL-R-SMT-1(80) | J3_W | U.FL | C88374 | U.FL-R-SMT-1(80) | Hirose | W | JLC stock 360,956.
6.8nH | L1_W | 0402 | C113119 | LQW15AN6N8J00D | Murata | W | JLC stock 7,118.
3.9nH | L2_W | 0402 | C98063 | LQW15AN3N9C00D | Murata | W
22uH | L3_W | Coilcraft_LPS4012 | C370621 | WPN4012H220MT | Sunlord | W | SWAP: was Coilcraft LPS4012-223MRC (not in JLC library). Same 4012 size, check land/Isat/DCR.
10uH | L4_W,L8_W | 0603 | C76798 | MLZ1608M100WT000 | TDK | W | JLC stock 101,572.
8.2nH | L5_W | 0402 | C84404 | LQW15AN8N2G00D | Murata | W
1.3nH | L6_W | 0402 | C3910751 | LQG15HS1N3B02D | Murata | W | JLC stock 8,917.
15nH | L7_W | 0402 | C86059 | LQG15HS15NJ02D | Murata | W
2.7M | R4_W,R5_W,R6_W | 0402 | C270621 | 0402WGF2704TCE | UNI-ROYAL | W | JLC stock 4,242.
8.2M | R7_W,R8_W,R9_W | 0402 | C423132 | 0402WGF8204TCE | UNI-ROYAL | W | JLC stock 2,237.
1M | R13_W,R14_W | 0402 | C26083 | 0402WGF1004TCE | UNI-ROYAL | W | The schematic part is generic (1M 1% 0402).
AEM30940 | U1_W | QFN-28_5x5mm | C22419906 | AEM30940-QFN | e-peas | W | FLAG: JLC stock 0 (pre-order). Pre-order it or consign it.
HMC190BMS8E | U2_W,U3_W,U4_W | MSOP-8 | C1558619 | HMC190BMS8E | Analog Devices | W | FLAG: JLC stock 0 (pre-order, ~$5.87 each). C208059 (HMC190BMS8ETR) is also at 0. Pre-order it or consign it.
MAXM86161EFD+T | U6_W | OLGA-14_2.9x4.3mm | C3178309 | MAXM86161EFD+T | Analog Devices (Maxim) | W | FLAG: JLC stock is only 43 ($21.90 each), so reserve it now.
