Matthew-Marsicano/BEACON_PhoneModule/fab/panel/BEACON_Panel_BOM_JLC.csv

Comment | Designator | Footprint | LCSC Part # | MPN | Manufacturer | Board | Notes
WDP.2458.25.4.B.02 | AE1_P | Taoglas_WDP.2458.25.4_Patch |  | WDP.2458.25.4.B.02 | Taoglas | P | No LCSC part. Consign it or hand-solder it.
1uF | C1_P,C16_P,C25_P,C35_P,C60_P,C61_P,C65_P,C37_W,C38_W | C_0402_1005Metric / 0402 | C52923 | CL05A105KA5NQNC | Samsung Electro-Mechanics | P+W
100nF | C2_P,C3_P,C4_P,C5_P,C7_P,C8_P,C11_P,C17_P,C18_P,C19_P,C23_P,C40_P,C41_P,C42_P,C46_P,C47_P,C48_P,C49_P,C50_P,C51_P,C52_P,C53_P,C54_P,C55_P,C10_W,C24_W,C26_W,C29_W,C30_W,C36_W | C_0402_1005Metric / 0402 | C1525 | CL05B104KO5NNNC | Samsung Electro-Mechanics | P+W
4.7uF | C6_P,C15_P,C20_P,C21_P,C22_P,C28_W | C_0603_1608Metric / 0603 | C19666 | CL10A475KO8NNNC | Samsung Electro-Mechanics | P+W
22nF | C9_P | C_0402_1005Metric | C1532 |  |  | P
2.2uF | C10_P | C_0603_1608Metric | C23630 |  |  | P
4.7pF | C12_P | C_0402_1005Metric | C1569 |  |  | P
22uF | C13_P,C14_P,C1_W | C_0805_2012Metric / 0805 | C45783 | CL21A226MAQNNNE | Samsung Electro-Mechanics | P+W | W: The schematic part is generic (22uF 16V 0805). This one is 25V X5R.
100pF | C24_P,C32_P,C33_P,C36_P,C37_P,C39_P,C70_P,C71_P,C72_P,C27_W,C33_W,C34_W | C_0402_1005Metric / 0402 | C1546 | 0402CG101J500NT | FH | P+W | W: SUB for CL05C101JB5NNNC (C26409, extended). Same 100pF 50V C0G 5% 0402.
47nF | C26_P | C_0402_1005Metric | C272875 |  |  | P
12pF | C27_P,C28_P,C22_W,C25_W | C_0402_1005Metric / 0402 | C1547 | 0402CG120J500NT | FH | P+W
0.8pF | C29_P | C_0402_1005Metric | C76915 | GJM1555C1HR80BB01D |  | P
0.5pF | C30_P,C19_W | C_0402_1005Metric / 0402 | C76911 | GJM1555C1HR50BB01D | Murata | P+W | W: The schematic part is generic (0.5pF +/-0.1pF 0402). This is the Murata GJM high-Q C0G part, the same one the phone module uses.
10uF | C34_P,C38_P,C45_P,C56_P,C57_P,C58_P,C59_P,C62_P,C63_P,C64_P | C_0603_1608Metric | C96446 |  |  | P
1.5pF | C43_P | C_0402_1005Metric | C1552 | 0402CG1R5C500NT |  | P
22pF | C44_P | C_0402_1005Metric | C1555 |  |  | P
820pF | C66_P | C_0402_1005Metric | C296004 |  |  | P
68nF | C67_P | C_0603_1608Metric | C31658 | CL10B683KB8NNNC |  | P
3.3nF | C69_P | C_0402_1005Metric | C1518207 |  |  | P
SZSMF6.0AT1G | D1_P | D_SOD-123F | C1975319 | SZSMF6.0AT1G | onsemi | P
Red | D2_P,D3_W | LED_0603_1608Metric / LED_0603 | C2286 | KT-0603R | Hubei KENTO Elec / Hubei KENTO | P+W
0.75A hold | F1_P | Fuse_1206_3216Metric | C315953 | NANOSMDC075F-2 | Littelfuse | P
DEA202450BT-1294D1-H | FL1_P | TDK_DEA202450BT-1294D1-H_2012 | C1512913 | DEA202450BT-1294D1-H | TDK | P
2450LP07C0100001T | FL2_P | Johanson_2450LP07_0402_4T | C17630068 | 2450LP07C0100001T | Johanson Technology | P
USB4105-GF-A | J1_P | USB_C_Receptacle_GCT_USB4105-xx-A_16P_TopMnt_Horizontal | C3020560 | USB4105-GF-A | GCT | P
TX antenna U.FL | J3_P | U.FL_Hirose_U.FL-R-SMT-1_Vertical |  | U.FL-R-SMT-1(10) | Hirose | P | No LCSC part. Consign it or hand-solder it.
5.6uH | L1_P | L_Abracon_ASPI-4030S | C5224561 | ASPI-4030S-5R6M-T | Abracon | P
4.7nH | L4_P | L_0402_1005Metric | C162543 | LQG15HS4N7B02D |  | P
18nH | L6_P | L_0402_1005Metric | C22398296 | 0402CS-18NXGRW |  | P
12nH | L7_P | L_0402_1005Metric | C86128 | LQW15AN12NG00D |  | P
1.2nH | L8_P | L_0402_1005Metric | C488336 | LQG15HS1N2B02D |  | P
5.1k | R1_P,R2_P | R_0402_1005Metric | C25905 |  |  | P
50m | R3_P,R6_P | R_0805_2012Metric | C2075868 | ERJ-6BWFR050V |  | P
10 | R4_P,R5_P,R7_P,R8_P | R_0402_1005Metric | C25077 |  |  | P
37.4k | R9_P | R_0402_1005Metric | C25888 |  |  | P
634k | R10_P | R_0402_1005Metric | C270588 |  |  | P
200k | R11_P | R_0402_1005Metric | C25764 |  |  | P
10k | R12_P,R23_W | R_0402_1005Metric / 0402 | C25744 | 0402WGF1002TCE | UNI-ROYAL | P+W | W: SUB for Panasonic ERJ-U02F1002X (anti-sulfur). Same 10k 1% 0402, but not sulfur-resistant.
4.7k | R13_P,R14_P,R21_W,R22_W | R_0402_1005Metric / 0402 | C25900 | 0402WGF4701TCE | UNI-ROYAL | P+W
100k | R15_P,R27_P,R35_P,R24_W | R_0402_1005Metric / 0402 | C25741 | 0402WGF1003TCE | UNI-ROYAL | P+W | W: The schematic part is generic (100k 1% 0402).
33 | R16_P,R17_P,R18_P | R_0402_1005Metric | C25105 |  |  | P
1.5k | R19_P,R16_W | R_0402_1005Metric / 0402 | C25867 | 0402WGF1501TCE | UNI-ROYAL | P+W | W: SUB for Vishay CRCW04021K50FKED. Same 1.5k 1% 0402.
0 | R20_P,R21_P,R26_P,R40_P,R2_W,R3_W,R10_W,R11_W,R12_W,R15_W,R17_W,R18_W | R_0402_1005Metric / 0402 | C17168 | 0402WGF0000TCE | UNI-ROYAL | P+W | W: R1 is DNP in the Prod variant and is left out.
3.3k | R24_P | R_0402_1005Metric | C25890 |  |  | P
10 | R25_P | R_0603_1608Metric | C22859 |  |  | P
1 | R28_P | R_0603_1608Metric | C22936 |  |  | P
300 | R29_P,R31_P | R_0402_1005Metric | C25102 |  |  | P
17.8 | R30_P | R_0402_1005Metric | C245886 |  |  | P
4.7 | R32_P | R_0402_1005Metric | C25121 |  |  | P
20k | R33_P,R34_P | R_0402_1005Metric | C25765 |  |  | P
0 | R36_P | R_0603_1608Metric | C21189 |  |  | P
150 | R38_P | R_0402_1005Metric | C25082 |  |  | P
22 | R39_P | R_0402_1005Metric | C25092 |  |  | P
49.9 | R41_P,R42_P,R43_P | R_0402_1005Metric | C25120 |  |  | P
B3U-1000P | SW1_P,SW1_W | SW_SPST_B3U-1000P / SW_B3U-1000P | C231329 | B3U-1000P | Omron / OMRON | P+W
USBLC6-2SC6 | U1_P | SOT-23-6 | C7519 | USBLC6-2SC6 | STMicroelectronics | P
INA219BIDCNR | U2_P,U3_P | SOT-23-8 | C962069 | INA219BIDCNR | Texas Instruments | P
LT80602AFO+ | U4_P | ADI_FC2QFN-17-1EP_3x3mm_LT80602 | C54448890 | LT80602AFO+ | Analog Devices | P
nRF52840-QIAA | U5_P,U5_W | Nordic_AQFN-73-1EP_7x7mm_P0.5mm / AQFN-73_7x7mm | C190794 | NRF52840-QIAA-R | Nordic Semiconductor | P+W | W: The schematic lists nRF52840-QIAAF0. C190794 is the QIAA reel part. Confirm the revision.
QPL9547TR7 | U6_P | Qorvo_QPL9547_DFN-8-1EP_2x2mm_P0.5mm | C5367093 | QPL9547TR7 | Qorvo | P
CC2595RGTR | U7_P | VQFN-16-1EP_3x3mm_P0.5mm_EP1.68x1.68mm_ThermalVias | C2654449 | CC2595RGTR | Texas Instruments | P
LMX2582RHAR | U8_P | Texas_RHA_VQFN-40-1EP_6x6mm_P0.5mm_EP4.6x4.6mm_ThermalVias | C2864397 | LMX2582RHAR | Texas Instruments | P
32MHz | Y1_P,Y1_W | Crystal_SMD_2016-4Pin_2.0x1.6mm / Crystal_2016 | C1985774 | ABM11W-32.0000MHZ-8-B1U-T3 | Abracon / ABRACON | P+W
26MHz | Y2_P | Oscillator_SMD_SeikoEpson_TG2520SMN-xxx-xxxxxx-4Pin_2.5x2.0mm | C7527389 | X1G0054210204 | Seiko Epson | P
SN74AUP2G04DCKR | B1_W | TSSOP-6 | C2865392 | SN74AUP2G04DCKR | Texas Instruments | W | SWAP: was Nexperia 74AUP2G04GW-Q100H (JLC stock 0). Same AUP family, SC-70-6 land, same pinout.
GRF6011 | B2_W | DFN-6_1.5x1.5mm | C22400840 | GRF6011 | Guerrilla RF | W | FLAG: JLC stock 0 (consign-only listing). Supply it yourself (consign) or hand-solder it.
10uF | C2_W,C7_W,C8_W,C9_W | 0805 | C95841 | CL21B106KOQNNNE | Samsung Electro-Mechanics | W | Exact MPN, JLC stock 157,184. Basic alternative: C15850 (CL21A106KAYNNNE, 25V X5R).
1.5pF | C3_W | 0402 | C76900 | GJM1555C1H1R5BB01D | Murata | W
10pF | C4_W,C11_W,C12_W,C13_W,C14_W,C15_W,C16_W,C17_W | 0402 | C85873 | GJM1555C1H100GB01D | Murata | W | JLC stock 15,848.
1uF | C5_W,C21_W,C23_W | 0603 | C15849 | CL10A105KB8NNNC | Samsung Electro-Mechanics | W | C21 and C23 are generic (1uF 50V 0603). C5 is a SUB: KEMET C0603C105K4RACTU (16V X7R, C2167386) is pre-order only. This part is 50V X5R.
100pF | C6_W | 0603 | C71664 | GRM1885C1H101JA01D | Murata | W
3pF | C18_W | 0402 | C88891 | GJM1555C1H3R0BB01D | Murata | W | JLC stock 210,960.
47nF | C20_W | 0603 | C1622 | CL10B473KB8NNNC | Samsung Electro-Mechanics | W
27pF | C31_W,C32_W | 0201 | C85899 | GRM0335C1H270JA01D | Murata | W | JLC stock 85,565. 0201 package.
10uF | C35_W | 0603 | C19702 | CL10A106KP8NNNC | Samsung Electro-Mechanics | W | The schematic part is generic (10uF 10V 0603).
SMS7630-005LF | D1_W | SOT-23 | C2936884 | SMS7630-005LF | Skyworks | W | FLAG: JLC stock is only 22 ($6.32 each), so reserve it now.
MM3Z5V1ST1G | D2_W | SOD-323 | C236206 | MM3Z5V1ST1G | onsemi | W | JLC stock 42,494.
B2B-PH-K-S(LF)(SN) | J1_W | JST_PH_B2B_THT | C131337 | B2B-PH-K-S(LF)(SN) | JST | W | Through-hole part, so the order needs Standard PCBA with THT, or hand-solder it.
U.FL-R-SMT-1(80) | J3_W | U.FL | C88374 | U.FL-R-SMT-1(80) | Hirose | W | JLC stock 360,956.
6.8nH | L1_W | 0402 | C113119 | LQW15AN6N8J00D | Murata | W | JLC stock 7,118.
3.9nH | L2_W | 0402 | C98063 | LQW15AN3N9C00D | Murata | W
22uH | L3_W | Coilcraft_LPS4012 | C370621 | WPN4012H220MT | Sunlord | W | SWAP: was Coilcraft LPS4012-223MRC (not in JLC library). Same 4012 size, check land/Isat/DCR.
10uH | L4_W,L8_W | 0603 | C76798 | MLZ1608M100WT000 | TDK | W | JLC stock 101,572.
8.2nH | L5_W | 0402 | C84404 | LQW15AN8N2G00D | Murata | W
1.3nH | L6_W | 0402 | C3910751 | LQG15HS1N3B02D | Murata | W | JLC stock 8,917.
15nH | L7_W | 0402 | C86059 | LQG15HS15NJ02D | Murata | W
2.7M | R4_W,R5_W,R6_W | 0402 | C270621 | 0402WGF2704TCE | UNI-ROYAL | W | JLC stock 4,242.
8.2M | R7_W,R8_W,R9_W | 0402 | C423132 | 0402WGF8204TCE | UNI-ROYAL | W | JLC stock 2,237.
1M | R13_W,R14_W | 0402 | C26083 | 0402WGF1004TCE | UNI-ROYAL | W | The schematic part is generic (1M 1% 0402).
AEM30940 | U1_W | QFN-28_5x5mm | C22419906 | AEM30940-QFN | e-peas | W | FLAG: JLC stock 0 (pre-order). Pre-order it or consign it.
HMC190BMS8E | U2_W,U3_W,U4_W | MSOP-8 | C1558619 | HMC190BMS8E | Analog Devices | W | FLAG: JLC stock 0 (pre-order, ~$5.87 each). C208059 (HMC190BMS8ETR) is also at 0. Pre-order it or consign it.
MAXM86161EFD+T | U6_W | OLGA-14_2.9x4.3mm | C3178309 | MAXM86161EFD+T | Analog Devices (Maxim) | W | FLAG: JLC stock is only 43 ($21.90 each), so reserve it now.
