Matthew-Marsicano/BEACON_PhoneModule/enclosure/inlid_assembly.stl

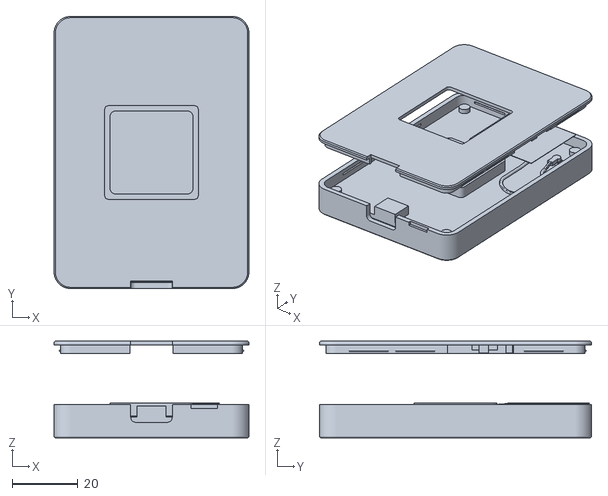
[picture p40: CAD file, 2026-11-03]
enclosure/inlid_assembly.stl
59.2 x 82.7 x 29.4
