Matthew-Marsicano/BEACON_PhoneModule/enclosure/rev_pcb_assembly.stl

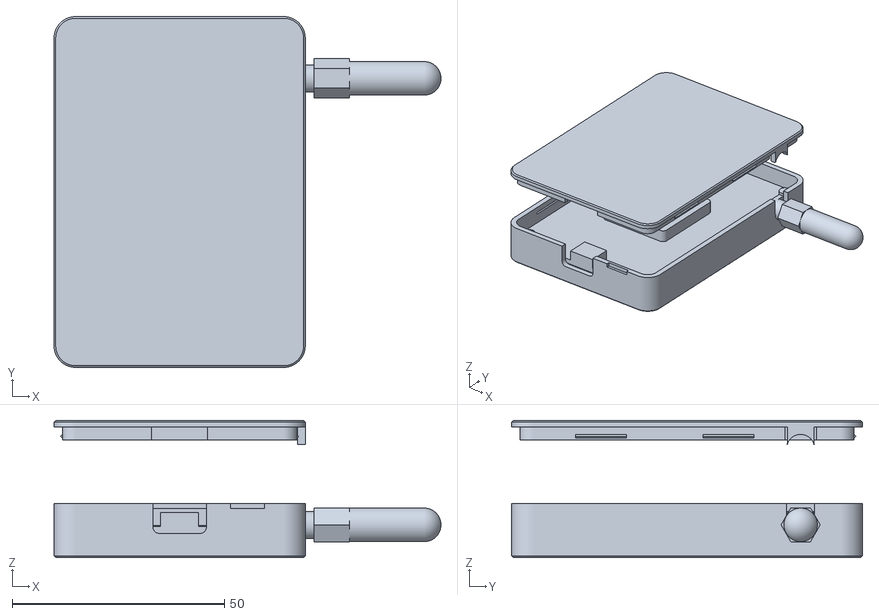
[picture p41: CAD file, 2026-11-03]
enclosure/rev_pcb_assembly.stl
91.2 x 82.7 x 32.3
