Matthew-Marsicano/BEACON_PhoneModule/enclosure/round_assembly.stl

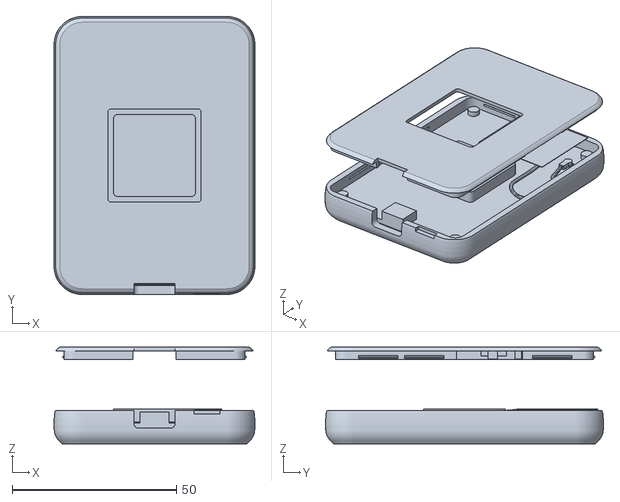
[picture p42: CAD file, 2026-11-03]
enclosure/round_assembly.stl
61.2 x 84.6 x 29.4
