Matthew-Marsicano/BEACON_PhoneModule/enclosure/lowprofile_assembly.stl

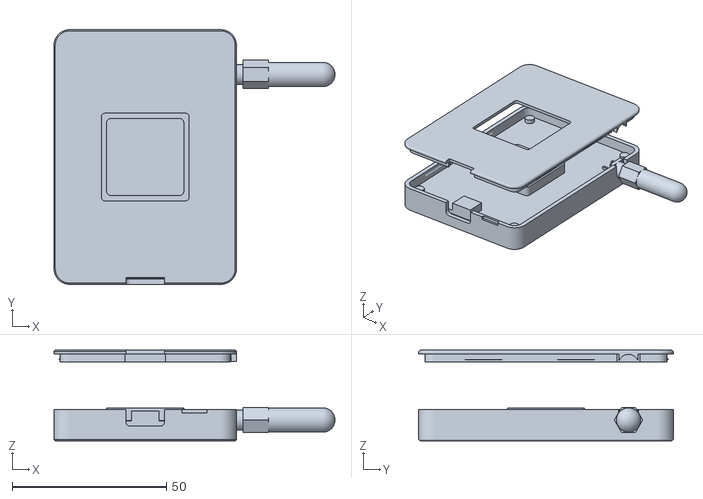
[picture p43: CAD file, 2026-11-03]
enclosure/lowprofile_assembly.stl
91.2 x 82.7 x 29.4
