Matthew-Marsicano/BEACON_PhoneModule/enclosure/fxp70_assembly.stl

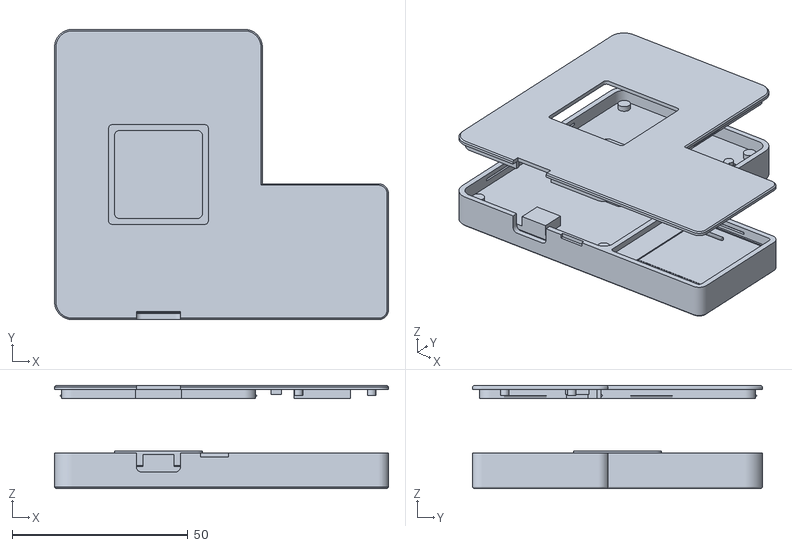
[picture p44: CAD file, 2026-11-03]
enclosure/fxp70_assembly.stl
95.1 x 82.7 x 29.4
