Matthew-Marsicano/BEACON_PhoneModule/enclosure/round_pcb_outline.dxf

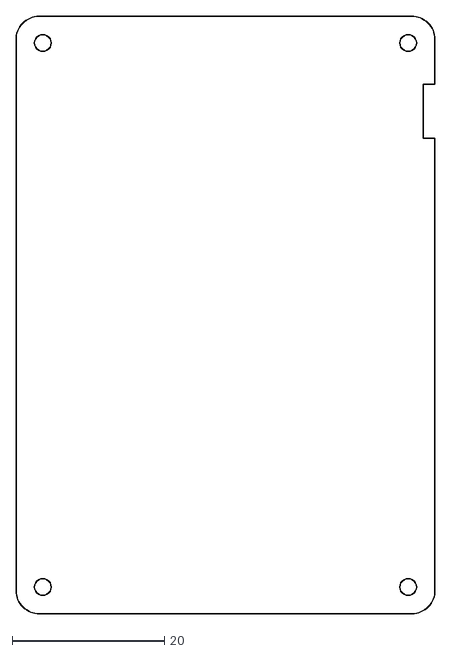
[picture p45: CAD file, 2026-11-03]
enclosure/round_pcb_outline.dxf
55.0 x 78.5
