Matthew-Marsicano/BEACON_PhoneModule/fab/BEACON_PhoneModule.step

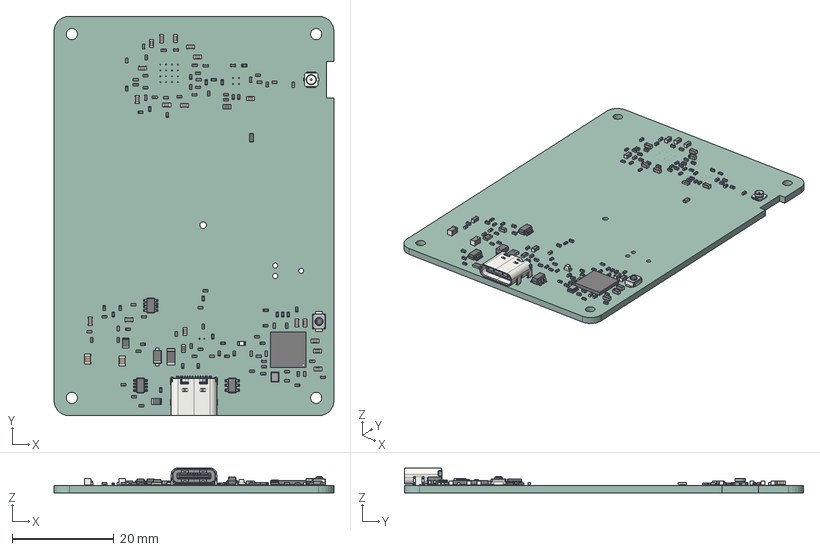
[picture p46: CAD file, 2026-11-03]
fab/BEACON_PhoneModule.step
55.0 x 78.5 x 4.91 mm
R_0805_2012Metric x 2
L_0402_1005Metric x 7
L_0603_1608Metric
C_0402_1005Metric x 53
SOT-23-8 x 2
C_0603_1608Metric x 17
R_0402_1005Metric x 38
LED_0603_1608Metric
U.FL_Hirose_U.FL-R-SMT-1_Vertical
R_0603_1608Metric x 3
D_SOD_123F
Nordic_AQFN-73-1EP_7x7mm_P0.5mm
SW_SPST_B3U-1000P
Fuse_1206_3216Metric
USB_C_Receptacle_16P_TopMnt_Horizontal_GCT_USB4105-xx-A
SOT-23-6
C_0805_2012Metric x 2
Crystal_SMD_2016-4Pin_2.0x1.6mm
BEACON_PhoneModule_PCB
