Matthew-Marsicano/BEACON_PhoneModule/enclosure/round_print_plate.stl

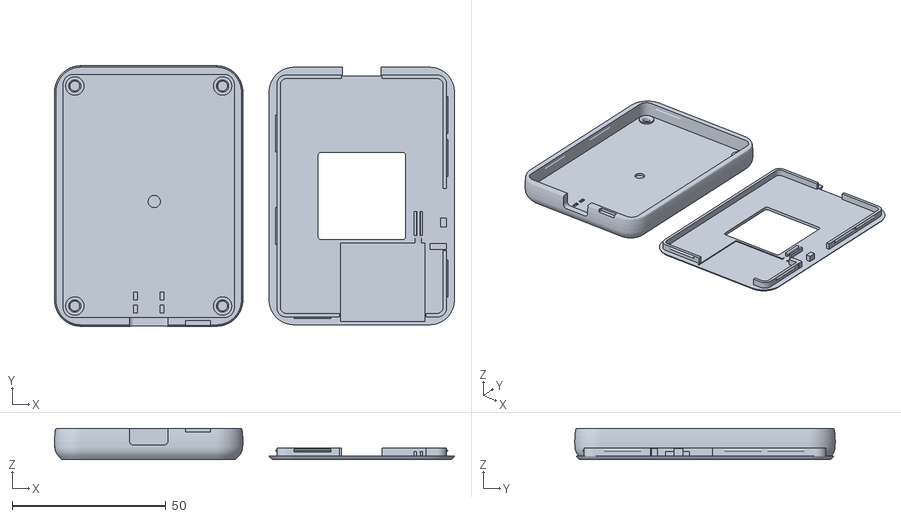
[picture p47: CAD file, 2026-11-03]
enclosure/round_print_plate.stl
129.9 x 84.6 x 10.2
