Matthew-Marsicano/BEACON_PhoneModule/enclosure/rev_pcb_print_plate.stl

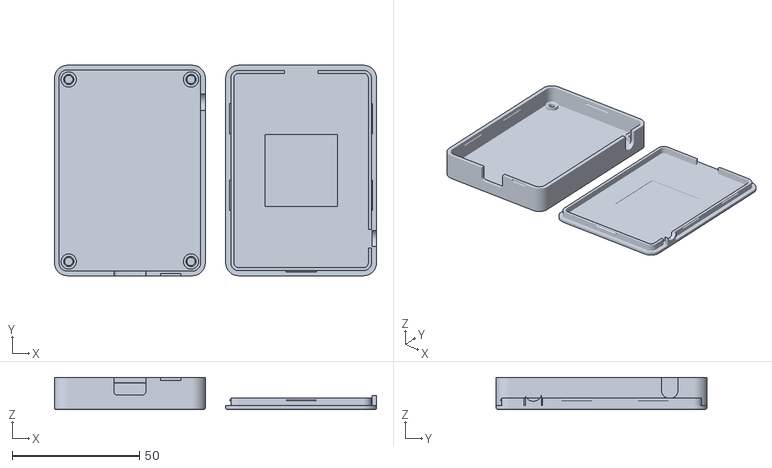
[picture p48: CAD file, 2026-11-03]
enclosure/rev_pcb_print_plate.stl
126.4 x 82.7 x 12.7
