Matthew-Marsicano/BEACON_PhoneModule/enclosure/fxp70_print_plate.stl

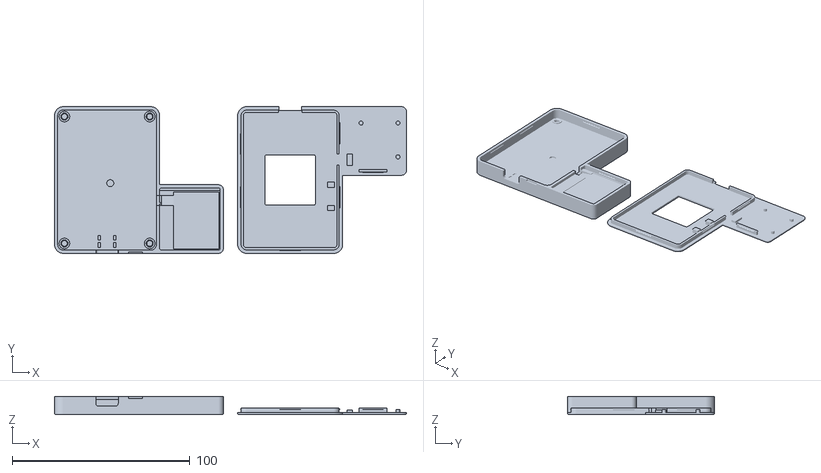
[picture p49: CAD file, 2026-11-03]
enclosure/fxp70_print_plate.stl
198.2 x 82.7 x 10.2
