Matthew-Marsicano/BEACON_PhoneModule/enclosure/inlid_print_plate.stl

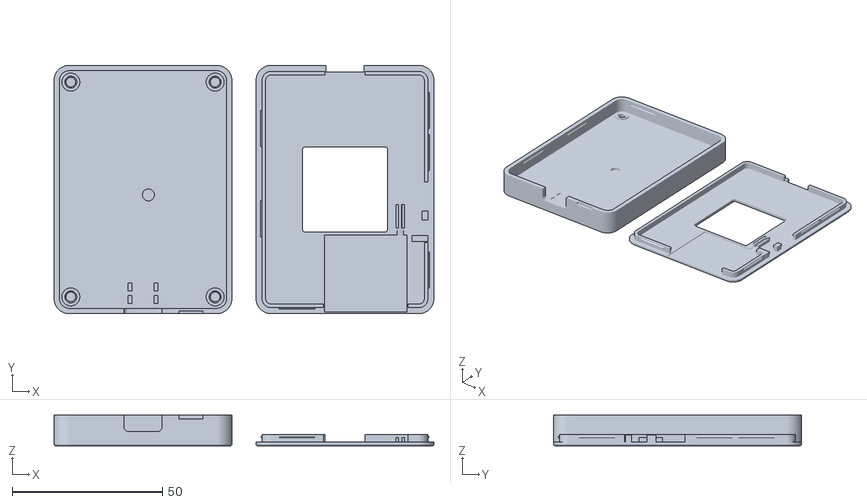
[picture p50: CAD file, 2026-11-03]
enclosure/inlid_print_plate.stl
126.4 x 82.7 x 10.2
