Matthew-Marsicano/BEACON_PhoneModule/enclosure/beacon_phone_magsafe_fxp70_inlid.scad

// =====================================================================
//  BEACON phone module - MagSafe enclosure with RX patch + TX flex antenna
//  VARIANT: 2.5 mm ring
//  REVISION: fxp70_inlid - derived from beacon_phone_magsafe_lowprofile_fxp70.scad
//    Same board and TX hardware as fxp70 (J3 Hirose U.FL-R-SMT-1 at board
//    (50.525, 66.0) feeding a Taoglas FXP70.07.0053A flex), but with NO side
//    bay: the outside is the plain low-profile 59.2 x 82.65 x 11.41 again.
//    The flex is stuck (3M 467) into a pocket in the LID UNDERSIDE, in the
//    top band (board y ~54-78, over the TX chain / synth), and radiates out
//    through lid_skin (0.8) of PETG. fxp_mount = "bay" still rebuilds the
//    fxp70 side-bay variant (regression check). Board outline (TX notch
//    included), holes, USB-C, patch, ring, clocking magnet, skin, pause and
//    Z stack are unchanged; pcb_outline exports the same DXF.
//    See FXP70_INLID.md (this revision), FXP70.md and LOWPROFILE.md.
//  Ring:    totalElement 54 x 46 x 2.5 mm N52 ring assembly with alignment magnet (listed 54.1 OD x 46 ID x 2.55 mm)
//  Defaults give 59.2 x 82.65 x 11.41 mm outside (same as lowprofile).
//
//  Z STACK (defaults, same as lowprofile / fxp70)
//   skin 0.68, magnets to 3.23, pause 3.56, floor top 4.16
//   board bottom 4.76 (pcb_gap 0.6, set by the USB-C overmold opening)
//   board top 6.36, lid underside 10.21 (top_clear 3.85 = USB4105 3.31 + 0.5),
//   lid 1.2, top 11.41. Flex pocket ceiling 10.61 (lid_skin 0.8 left), flex
//   (nominal) 10.47-10.55, i.e. about 4.15 above the board-top GND pour and
//   4.4 above the solid L2 GND.
//
//  Antennas
//   RX: Taoglas WDP.2458.25.4.B.02 patch on the board top, open lid window
//       (28.4 sq at the board centre), unchanged.
//   TX: FXP70 flex in the lid, 26.9 along X x 24.9 along Y, between the
//       patch window (1.6 nominal lid web) and the top edge of the box
//       (it runs over the top wall; the lid lip is cut there). Its cable
//       exit edge faces the window; viewed from outside the lid the cable
//       is at the +X end, so the flex is pushed to X <= 20.6 and the cable
//       drops into the free strip right of the patch (board x > 41).
//       Cable route (53 +/-2, no loops): along the lid underside in clip
//       rails toward -Y, one tilted 180 deg hairpin (R 4.5) down to the
//       board ground at the board's right edge, back +Y on the board under
//       lid keepers, an S-jog (R 4.5) to the plug axis and into J3 from -Y.
//       The hairpin floats and takes up the cable length tolerance.
//
//  Parts
//   base : as lowprofile (no bay, no wall slot). Snap grooves follow the
//          moved beads.
//   lid  : flat plate, patch window, USB-C notch, lip + beads. New: flex
//          pocket (lid underside), cable groove at the flex exit, clip
//          rails, board-leg keepers, lid lip cut over the pocket (top wall)
//          and notched over the hairpin / board leg (right wall). Beads:
//          right wall y -38 / -24 / 15, left -32 / -2, top x -16.
//
//  Coordinates (assembled): origin = ring centre on the phone-contact
//  face. +Y toward the top of the phone, -Y toward the bottom (USB-C,
//  clocking magnet), +X to the right seen from the back of the phone
//  (camera bump top-left). +Z away from the phone. Board coordinates
//  (pcb_holes, patch_pos, tx_pos, ufl_pos, DXF export) start at the
//  board's lower-left corner seen from the component side, USB-C edge at
//  the bottom (KiCad: board x = X - 100, board y = 78.45 - (Y - 100)).
//
//  Print: part = "print_plate", no supports. Base prints phone face down,
//  lid prints outer face down (the pocket, rails and keepers then face up).
//  Match first_layer_h / layer_h to your slicer; lid_skin should be a whole
//  number of lid layers (0.8 = 0.2 + 5 x 0.12). PETG, not PLA/ABS/ASA;
//  drop the bed to about 60 C at the pause. No metal- or carbon-filled
//  filament, no carbon-black or pigment-heavy colours near the antennas.
//  Print the LID in light-coloured PETG (white/natural).
//
//  Assembly
//   1.-5. Magnets, inserts, board and screws: as fxp70 (no SMA, no leg cut).
//   6.  Lid, upside down: clean the pocket (IPA). Peel the FXP70 liner and
//       lay the flex adhesive side DOWN into the pocket (cable side up),
//       cable at the pocket's +X / window corner, and push it into the +X
//       and outer (+Y, top-wall) corner of the pocket. Press 10 s. Press the
//       cable into the clip rails.
//   7.  Mate the plug on J3 (straight down, cable toward -Y, i.e. toward
//       USB-C). Lay the S-jog and the board leg along the board's right
//       edge. Lower the lid straight down: the slack forms the hairpin
//       beside the patch window. Check the board leg sits under the lid
//       keepers, then press the lid on until the beads click.
//       To open: lift the lid straight up no more than ~13 mm, then unplug
//       J3 before taking the lid away (flex and cable stay in the lid).
//
//  The console ECHO lists outside size, board outline, hole positions,
//  antenna and cable geometry and clearances, and screw length.
//  part = "pcb_outline" renders the board shape, notch included, for DXF.
// =====================================================================

/* [Render] */
part    = "print_plate"; // [print_plate, base, lid, lid_under, assembly, routing, section, section_patch, section_ant, section_hairpin, section_ant_x, sec2d_ant, sec2d_exit, sec2d_hairpin, sec2d_ant_x, section_cable, section_flex, section_sma, pcb_outline]
                         //   section: x >= 0 half; section_patch: x >= feed pin
                         //   (through patch + pin pocket); routing: base,
                         //   board and antennas without the lid.
                         //   lid mode: lid_under = lid seen from below with the
                         //   flex and the lid-held cable; section_ant: keep
                         //   x <= cable exit + sec_off (pocket, flex, groove,
                         //   rails, window web, top wall); section_hairpin: keep
                         //   y >= hairpin centre + sec_off (both legs);
                         //   section_ant_x: keep y <= flex centre + sec_off.
                         //   sec2d_*: flat colour-coded cross-section drawings
                         //   (CGAL, ~2 min; use -D label=false off the ring
                         //   centre): ant = x through the flex centre, exit =
                         //   x through the cable exit, hairpin = y through the
                         //   hairpin legs, ant_x = y through the flex centre.
                         //   bay mode: section_cable: keep y <= cable centreline
                         //   + sec_off; section_flex: keep x <= flex centre +
                         //   sec_off. section_sma (legacy, use_sma): jack axis
explode = 18;            // lid lift in the assembly view, mm
sec_off = 0;             // section cut offset, mm
sec_render = false;      // sections: CGAL-render the base and lid cuts so their cut
                         //   faces keep their colours in a preview (slower)

/* [Layer stack - match your slicer profile] */
first_layer_h = 0.20;
layer_h       = 0.12;    // Bambu 0.12mm Fine
skin_layers   = 5;       // printed layers between the magnets and the phone (0.68 mm)

/* [MagSafe ring] */
ring_od = 54.1;
ring_id = 46.0;
ring_t  = 2.55;

/* [Clocking (alignment) magnet] */
use_clock = true;
clock_w   = 6.0;         // Apple reference size from the guide; measure yours
clock_l   = 19.3;
clock_t   = 2.55;  // pocket depth covers the thicker of ring and bar
clock_top = 31.2;        // ring centre to the bar's top edge

/* [Magnet fit] */
mag_clr    = 0.15;       // radial clearance on ring OD, ring ID and bar sides
mag_clr_z  = 0.25;       // min headroom over the magnets at the pause height
cap_layers = 5;          // layers printed over the magnets after the pause (0.60 mm)
mag_margin = 0.6;        // floor between a pocket and the cavity wall

/* [PCB] */
pcb_w       = 0;         // X size; 0 = auto, largest board the cavity allows
pcb_l       = 0;         // Y size; 0 = auto
pcb_t       = 1.6;
pcb_r       = 3.0;       // board corner radius
pcb_x_off   = 0;         // board centre offset in X
pcb_clr     = 0.3;       // board edge to cavity wall
pcb_gap     = 0.6;       // general space under the board (rev_pcb 1.5). Only flat
                         //   pads are under the board; taller bottom-side items
                         //   get floor pockets below. 0.6 is the minimum the USB-C
                         //   overmold opening allows (usb_z0 >= z_floor + 0.5).
                         //   (legacy use_sma with sma_leg_cut = false: 1.3)
top_parts_h = 3.35;      // tallest general top-side part (GCT USB4105-GF-A 3.31;
                         //   L1 ASPI-4030S 3.0, SW1 B3U 2.5, U.FL mated 2.5).
                         //   The patch is handled by the window.
edge_parts_h = 1.1;      // tallest part within 1.1 mm of the board edge (under the
                         //   lid lip; L3 0402 at board x 53.8 today)
hole_inset  = 3.5;       // auto hole pattern: hole centre to board edges
pcb_hole_d  = 2.2;       // board hole, used by the DXF export
pcb_holes   = [];        // [] = 4 corner holes; else [[x, y], ...] in board coords

/* [Floor pockets (bottom-side parts that hang below pcb_gap)] */
pocket_wall   = 0.6;     // min plastic between a floor pocket that goes below the
                         //   pause height and a magnet pocket
pin_pocket    = true;    // pocket under the patch feed pin (inside the ring island)
patch_pin_off = [1.8, -1.8]; // feed pin from the patch centre, board coords
                         //   (AE1 pad 1 at board (29.3, 37.425))
pin_pocket_d  = 4.0;     // pin pad 2.0 + solder + placement tolerance
sma_pocket    = true;    // (legacy use_sma) pocket under the SMA flange and lower legs
sma_leg_below = 1.07;    // Cinch lower legs: thickness below the board bottom
sma_leg_l     = 3.81;    // legs run 0.150 in behind the flange back face
sma_leg_y     = [2.365, 3.175]; // leg inner/outer edge from the jack axis
sma_leg_cut   = true;    // the lower leg that lies over the ring magnet is cut
                         //   to sma_leg_stub before soldering (assembly 4a).
                         //   false: it rides over the cap; set pcb_gap = 1.3
sma_leg_stub  = 0.5;     // what is left of a cut leg behind the flange
sma_pocket_clr = 0.25;   // pocket clearance around the flange and legs (XY and Z)
usb_stake_pocket = true; // pockets under the USB4105 THT shell stakes
usb_stakes    = [[-4.32, 2.60], [4.32, 2.60], [-4.32, 6.78], [4.32, 6.78]];
                         //   [x from usb_x, y behind the board edge] (J1 SH pads)
usb_stake_below = 1.0;   // assumed stake + solder below the board (not in docs/;
                         //   measure, clip flush if longer)
usb_stake_pkt = [1.3, 2.6]; // pocket size per stake (pad 1.0 x 2.1 + margin)

/* [Fasteners] */
fastener      = "insert"; // [insert, selftap]
insert_d      = 3.2;     // hole for an M2 x 3 heat-set insert (OD ~3.6). Not
                         //   limiting here: needs board bottom >= 4.4, has 4.76
insert_len    = 3.0;
selftap_d     = 1.7;     // pilot for an M2 thread-forming screw
floor_web     = 1.0;     // plastic kept under any hole, above the phone face
standoff_d    = 6.0;
screw_head_d  = 3.8;     // M2 pan / cheese head, for clearance checks + preview
screw_head_h  = 1.6;

/* [USB-C: GCT USB4105-GF-A, drawing rev B4] */
usb_x        = 0;        // receptacle centre in X (board x 27.5; KiCad J1 origin 3.675 inside the edge)
usb_z_on_pcb = 1.73;     // receptacle centreline above the board top (GCT; was 1.63)
usb_open_w   = 12.6;     // sized for the cable overmold (spec max 12.35 x 6.5)
usb_open_h   = 6.7;
usb_open_r   = 1.5;
usb_body     = [8.94, 7.35, 3.31]; // receptacle W x L x H (GCT; was 8.94 x 7.3 x 3.26)
usb_overhang = 0;        // receptacle front past the board edge, preview only
usb_open_top = true;     // opening runs up through the lid (notch), so the 6.7 mm
                         //   overmold opening does not set the lid height. false:
                         //   the lid bridges it (rev_pcb), top_clear >= 5.08

/* [Shell] */
wall_t       = 1.8;
lid_t        = 1.2;      // rev_pcb 1.6. Flat plate, >= 1.0 (PETG, assert)
lid_local_min = 0.8;     // min lid left over a local underside recess (SMA)
lip_h        = 2.6;      // lid lip depth into the base (carries the snap beads).
                         //   2.2 min for the groove-to-wall-top assert; 2.6 keeps
                         //   top_clear - lip_h = 1.25 for edge_parts_h + 0.1
lip_t        = 1.2;
lip_clr      = 0.2;
seam_gap     = 0;        // lid plate sits on the wall tops
edge_chamfer = 0.4;
label        = true;     // deboss MAGNETS DOWN / STEEL UP inside the ring

/* [Snap fit] */
snap_p      = 0.45;      // bead protrusion from the lip face (45 deg flanks);
                         //   interference = snap_p - lip_clr. Raise for a
                         //   firmer click, lower if it is hard to open.
snap_len    = 12;        // length of each bead / groove
snap_clr    = 0.1;       // extra groove depth over the bead
snap_side_y = [-32, -2]; // bead centres on the left wall (ring-centre y)
snap_right_y = [-38, -24, 15]; // bead centres on the right wall (lowprofile: -32, -2;
                         //   fxp70 bay: -38, -2). Lid mode: the lip is notched
                         //   over the cable hairpin / board leg (y ~-14.4 to 5.1)
snap_bay    = true;      // (bay mode) one bead on the antenna bay's inner top wall
snap_top_x  = [-16];     // bead centres on the top wall (ring-centre x; lowprofile
                         //   and bay: 0). Lid mode: the top lip is cut over the
                         //   flex pocket (x ~-7.2 to 20.9)
snap_bot_x  = [];        // bottom wall beads (USB-C sits mid-wall)
pry_notch   = true;      // lever notch in the bottom wall's outer top edge
pry_x       = 16;        // its centre (ring-centre x)
pry_w       = 8;

/* [RX patch: Taoglas WDP.2458.25.4.B.02] */
use_patch    = true;
patch_pos    = [];       // [] = board centre; else [x, y] in board coords
patch_sz     = 25.1;     // square, +/-0.3
patch_tol    = 0.3;
patch_h      = 4.1;      // 4.0 +/-0.1
patch_tape   = 0.3;      // adhesive under the patch, nominal
patch_tape_max = 0.5;    // datasheet maximum, used for worst-case air / recess
patch_pin    = 2.8;      // feed pin length, 2.4 +/-0.4, checked against the floor
                         //   (pin pocket); protrudes <= 1.2 below the board
patch_window = true;     // open window in the lid over the patch (default).
                         //   ESD: the patch's top electrode is DC-connected to
                         //   the feed pin; a 50-100 um polyimide/PET label on the
                         //   patch top protects it with little detuning.
                         //   false = flat lid with a thin radome (total 12.26)
patch_recess_min = 0.3;  // window: worst-case patch top below the lid's outer face
patch_margin = 1.5;      // window / radome margin around the patch (>= 1.0 for a
                         //   window, since the patch stands up into it)
patch_gap    = 0.7;      // radome only: air over the patch at the nominal stack
                         //   (rev_pcb 1.0); 0.5 at patch_tape_max
patch_cover  = 0.8;      // radome only: lid left over the patch (rev_pcb 1.2)
patch_air_min = 0.5;     // radome only: min air at patch_tape_max

/* [TX antenna: Taoglas FXP70.07.0053A flex on a Hirose U.FL-R-SMT-1 (J3)] */
// Sources: Taoglas FXP70.07.0053A datasheet SPE-12-8-013 rev G (2024-09-30),
// mechanical drawing p.9; Taoglas APN-11-8-004 rev C "Flexible PCB Antenna
// with Cable"; KiCad J3 at (150.525, 112.45), rot 0.
use_fxp      = true;
fxp_mount    = "lid";    // [lid, bay] lid: flex in a lid-underside pocket, no side
                         //   extension (this revision). bay: the fxp70 side bay
                         //   (95.1 wide; set snap_right_y = [-38, -2], snap_top_x = [0])
ufl_pos      = [50.525, 66.0]; // J3 mating centre, board coords
ufl_mated_h  = 2.5;      // receptacle + plug, max (Hirose U.FL / I-PEX MHF I with
                         //   1.13 cable: 2.5 max, 2.4 nominal)
ufl_lid_clr  = 0.5;      // min air over the mated plug
ufl_plug_w   = 3.0;      // FXP70 detail A: plug 3.0 wide, 2.1 thick, 5.2 +/-0.5 long
ufl_crimp    = 3.7;      // mating centre to the end of the crimp (5.2 - ~1.5)
ufl_cable_z  = 1.9;      // cable centre above the board top where it leaves the plug
cable_d      = 1.13;     // mini-coax OD
cable_bend_r = 4.5;      // design bend radius (4 x OD). No figure in the Taoglas,
                         //   Hirose or I-PEX documents found; 1.13 FEP micro-coax
                         //   is usually rated for a static bend of about 3 x OD
cable_bend_min = 3.4;    // 3 x OD, assert floor
cable_lead   = 3.0;      // straight cable behind the crimp before the first bend
cable_len    = 53;       // drawing: 53 +/-2 from the flex's braid pad to the plug
cable_tol    = 2;
fxp_cable_pad = 5.25;    // braid pad to the flex edge (scaled from the drawing)
cable_rx_min = 5;        // min cable to RX patch footprint (APN: cables not near
                         //   the other antenna)
fxp_sz       = [24.9, 26.9]; // flex in the bay, X x Y. The 26.9 edge carries the
                         //   cable exit and faces the board (-X)
fxp_tol      = 0.2;      // +/- on each flex dimension
fxp_t        = 0.24;     // flex thickness, worst case (datasheet: 0.08 in the
                         //   table, 0.2 on the cover, "polymer 0.24t" in the BOM)
fxp_t_nom    = 0.08;
fxp_adh      = 0.06;     // 3M 467MP transfer adhesive, 0.058
fxp_c_off    = 2.25;     // cable centre from the flex corner along the exit edge
fxp_c_off_tol = 0.3;
fxp_on_flex  = 12.5;     // cable lying on the flex top, exit edge to centre pad
fxp_solder_h = 1.7;      // max solder joint height above the flex (drawing note 1)
fxp_lid_air  = 0.2;      // min air between the worst solder joint and the lid
fxp_clr      = 0.25;     // pocket clearance per side
fxp_slide    = 2;        // pocket is this much longer at each Y end, so the
                         //   flex is placed where the 53 +/-2 cable reaches
ant_gnd_gap  = 10;       // flex pocket inner edge to the board's right edge.
                         //   Taoglas APN-11-8-004: >= 4 from metal, 20 best.
                         //   Each mm adds 1 mm to the outside width
ant_gnd_min  = 4;
ant_rx_min   = 20;       // min RX patch footprint to flex pocket (edge to edge)
shelf_t      = 1.6;      // PETG plate under the flex (Taoglas tunes on 2 mm ABS)
shelf_rim    = 0.6;      // shelf left round the pocket
shelf_rib_w  = 0.8;      // ribs under the shelf, along X
shelf_rib_pitch = 7;
bay_r        = 1.0;      // bay inner corner radius
fxp_holddown = true;     // lid pins over the flex corners (keep it flat if the
                         //   adhesive lets go; also carry the lid wing)
holddown_d   = 2.4;
holddown_gap = 0.2;      // pin end above the shelf top
keeper_y     = [4, -9];  // lid-side cable keepers over the board run (ring-centre y)
keeper_sz    = [4, 3];   // keeper footprint, X x Y
keeper_clr   = 0.3;      // keeper end above the cable top
phone_w      = [71.6, 77.8]; // phone widths for the overhang echo (ring centred)

/* [TX antenna in the lid (fxp_mount = "lid")] */
// The flex lies flat in the top band, 26.9 along X x 24.9 along Y (fxp_sz
// swapped), cable exit edge toward the patch window. Seen from outside the
// lid (adhesive side), the cable is at the +X end of that edge (datasheet
// "Bottom" view), so the cable exit sets the flex's +X edge.
lid_skin     = 0.8;      // PETG left over the flex (0.2 + 5 x 0.12 lid layers)
lid_skin_min = 0.6;
win_web      = 1.0;      // lid between the patch window and the pocket (full 1.2)
win_web_min  = 0.8;
pk_rim_min   = 0.5;      // lid left between the pocket and the outer edge
lid_fxp_clr  = 0.2;      // pocket clearance per side; the flex is pushed into the
                         //   pocket's +X / +Y corner at assembly
top_band_h   = 1.1;      // tallest part under the flex except J3 (KiCad: only
                         //   0402/0603 passives, VQFN-40 U8 / VQFN-16 U7 <= 1.0,
                         //   TG2520 Y2 0.8 in board y > 53)
lid_rx_min   = 2.5;      // min flex to RX patch footprint, edge to edge (this
                         //   layout cannot give more than ~3.1, see FXP70_INLID.md)
leg_wall_clr = 0.3;      // board-leg cable edge to the cavity wall
clip_off     = 3.0;      // flex edge to the first clip: the free cable takes up
                         //   the +/-0.4 exit position tolerance there (S-bend
                         //   radius ~4.7 >= cable_bend_r 4.5, asserted)
groove_clr   = 0.1;      // cable groove at the flex exit, extra per side
rail_t       = 0.8;      // clip rails on the lid underside, either side of the cable
rail_clr     = 0.08;     // cable to rail, per side
clip_p       = 0.15;     // clip ridge at the rail tips (snap the cable in)
rail_end_m   = 0.5;      // rails end this far above the hairpin (shortest cable)
lk_len       = 3.0;      // lid keepers over the board leg / S-jog, length along Y
lk_w         = 2.6;      // keeper width (X) over the board leg
lip_cut_m    = 0.3;      // lid lip cut past the pocket / notch, each end
strip_y      = [21.8, 63.0]; // board y range of the part-free strip right of the
                         //   patch: top side, board x >= strip_x0 (KiCad
                         //   courtyards: R14 to y 21.17, AE1 to x 40.75, C38 to
                         //   x 40.11, J3 from y 63.5, C43 from y 64.11)
strip_x0     = 41.0;
fxp_freq     = 2.45;     // GHz, for the image-theory estimate in the ECHO

/* [Legacy TX: Taoglas GW.26.0111 on a Cinch 142-0711-821 end-launch SMA(F) jack] */
use_sma      = false;    // true (with use_fxp = false and snap_right_y = [-32, -2])
                         //   rebuilds the lowprofile SMA geometry: wall U-slot, lid
                         //   tongue, flange recess, flange/leg pockets, leg cut
board_notch  = true;     // the routed board keeps its 1.5 x 7.1 notch at the old
                         //   jack (DXF unchanged); independent of use_sma
tx_side     = "right";   // [right, left, top, bottom] board notch / legacy jack edge
tx_pos      = 66;        // notch / jack centre along that board edge, board coords
                         //   (y for right/left, x for top/bottom)
sma_axis_z  = 0.4;       // barrel axis above the board top. Cinch 142-0711-821:
                         //   ~0.4 (0.38-0.55, derived from the drawing, not
                         //   dimensioned; was 0.7). Measure the first jack.
sma_thread  = 6.35;      // 1/4"-36 UNS barrel
sma_clr     = 0.25;      // diametral clearance on the barrel (was 0.5): 0.125
                         //   radial; gives ~27 % more flange bearing on the
                         //   wall + tongue (6.6 vs 5.2 mm2). Go back to 0.4-0.5
                         //   if the measured axis sits above ~0.5.
sma_body    = [6.35, 1.65, 6.35];  // flange: 0.250 in sq x 0.065 in (was 6.5 x 1.6 x 6.5)
sma_barrel  = 7.87;      // barrel out from the flange front face (was 7.0)
sma_lid_clr = 0.5;       // lid underside over the flange top (+3.575); a local
                         //   recess provides it where top_clear is lower
tongue_clr  = 0.15;      // lid tongue side clearance in the slot
// Board notch, pinned to the KiCad Edge.Cuts (1.5 deep x 7.1 wide, board
// y 62.45-69.55). 0 = auto from sma_body (original formula: depth
// sma_body[1] + 0.2 - tx_gap, width sma_body[0] + 0.6), which for the Cinch
// flange would give 1.55 x 6.95 and no longer match the routed board.
tx_notch_d  = 1.5;
tx_notch_w  = 7.1;

/* [Lid vents (optional)] */
vent_slots  = false;     // through-slots in the lid plate; default off
vent_c      = [22, 65];  // slot-group centre, board coords (over U8 LMX2582
                         //   at board (22.6, 67.25), clear of the patch radome
                         //   and >= vent_keep from the TX jack / U.FL and cable)
vent_n      = 4;         // number of slots
vent_len    = 20;        // slot length (along X)
vent_w      = 1.2;       // slot width
vent_pitch  = 3.0;       // slot centre spacing (along Y)
vent_keep   = 10;        // min distance from the TX jack body (radome: 3 mm)

/* [Hidden] */
screw_lengths = [3, 4, 5, 6, 8, 10];  // stock M2 pan-head lengths
$fa = 2;
$fs = 0.3;
eps = 0.01;

// ---------------------------------------------------------------------
// Derived values
// ---------------------------------------------------------------------
function snap_up(z) = z <= first_layer_h ? first_layer_h
    : first_layer_h + ceil((z - first_layer_h) / layer_h - 1e-6) * layer_h;
function snap_dn(z) = first_layer_h + floor((z - first_layer_h) / layer_h + 1e-6) * layer_h;
function r2(x) = round(x * 100) / 100;
function rect_dist(p, a, b) =
    norm([max(a[0] - p[0], 0, p[0] - b[0]), max(a[1] - p[1], 0, p[1] - b[1])]);
function rects_hit(a0, a1, b0, b1, m) = a0[0] < b1[0] + m && b0[0] < a1[0] + m
                                     && a0[1] < b1[1] + m && b0[1] < a1[1] + m;
// side s: 0 top, 1 right, 2 bottom, 3 left. side_pt/side_ang give a local
// frame on the inner wall face: x along the wall, y = 0 at the face, +y out.
// side 4: inner face of the antenna bay's top wall (faces -Y, like side 0).
function side_pt(s, p) = s == 0 ? [p, cav_y1] : s == 1 ? [cav_x, p]
                       : s == 2 ? [p, cav_y0] : s == 3 ? [-cav_x, p] : [p, bay_cy1];
function side_ang(s)   = [0, -90, 180, 90, 0][s];
function side_run(s)   = s == 4 ? [bay_cx0 + bay_r, bay_cx1 - bay_r]
                       : (s == 0 || s == 2) ? [-cav_x + cav_r, cav_x - cav_r]
                                            : [cav_y0 + cav_r, cav_y1 - cav_r];
// local wall frame -> enclosure coords (axis-aligned rectangles stay so)
function rotv(a, v)       = [v[0] * cos(a) - v[1] * sin(a), v[0] * sin(a) + v[1] * cos(a)];
function loc2glob(s, p, v) = side_pt(s, p) + rotv(side_ang(s), v);
function grect(s, p, r)   = let(u = loc2glob(s, p, r[0]), w = loc2glob(s, p, r[1]))
    [[min(u[0], w[0]), min(u[1], w[1])], [max(u[0], w[0]), max(u[1], w[1])]];
function rect_far(p, a, b) =
    norm([max(abs(p[0] - a[0]), abs(p[0] - b[0])), max(abs(p[1] - a[1]), abs(p[1] - b[1]))]);
function rr_dist(a0, a1, b0, b1) =
    norm([max(b0[0] - a1[0], 0, a0[0] - b1[0]), max(b0[1] - a1[1], 0, a0[1] - b1[1])]);
// true if rectangle r keeps m of plastic to the ring pocket (outside it or
// inside the island)
function off_ring(r, m) = rect_dist([0, 0], r[0], r[1]) >= ring_ro + m - 1e-6
                       || rect_far([0, 0], r[0], r[1]) <= ring_ri - m + 1e-6;
// SMA lower leg i (-1 / +1 across the axis), length l behind the flange, grown by c
function leg_loc(i, l, c) = [[i > 0 ? sma_leg_y[0] - c : -sma_leg_y[1] - c, -tx_jt - l - c],
                             [i > 0 ? sma_leg_y[1] + c : -sma_leg_y[0] + c, -tx_jt]];

// layer stack and magnet pockets
skin_t  = first_layer_h + (skin_layers - 1) * layer_h;
mag_t   = max(ring_t, use_clock ? clock_t : 0);
z_pause = snap_up(skin_t + mag_t + mag_clr_z);   // pocket tops: pause here
z_floor = z_pause + cap_layers * layer_h;          // sealed floor top
pause_layer = 1 + round((z_pause - first_layer_h) / layer_h);   // last layer before the pause
ring_ro = ring_od / 2 + mag_clr;
ring_ri = ring_id / 2 - mag_clr;
clk_x0  = -clock_w / 2 - mag_clr;
clk_x1  =  clock_w / 2 + mag_clr;
clk_y1  = -clock_top + mag_clr;                  // end nearest the ring
clk_y0  = -clock_top - clock_l - mag_clr;

// cavity: set by the magnets, grown if the board needs more room
env_x  = ring_ro + mag_margin;
env_y1 = ring_ro + mag_margin;
env_y0 = (use_clock ? clk_y0 : -ring_ro) - mag_margin;
cav_y0 = env_y0;
pcb_y0 = cav_y0 + pcb_clr;                       // USB-C edge at the bottom wall
pcb_W  = pcb_w > 0 ? pcb_w : 2 * (env_x - pcb_clr);
pcb_L  = pcb_l > 0 ? pcb_l : (env_y1 - pcb_clr) - pcb_y0;
pcb_x0 = pcb_x_off - pcb_W / 2;
cav_x  = max(env_x, abs(pcb_x_off) + pcb_W / 2 + pcb_clr);
cav_y1 = max(env_y1, pcb_y0 + pcb_L + pcb_clr);
cav_r  = max(pcb_r + pcb_clr, 1.0);
out_x  = cav_x + wall_t;
out_y0 = cav_y0 - wall_t;
out_y1 = cav_y1 + wall_t;
out_r  = cav_r + wall_t;

// mounting holes: board coords -> enclosure coords
holes_pcb = len(pcb_holes) > 0 ? pcb_holes
    : [[hole_inset, hole_inset], [pcb_W - hole_inset, hole_inset],
       [hole_inset, pcb_L - hole_inset], [pcb_W - hole_inset, pcb_L - hole_inset]];
holes = [for (h = holes_pcb) [pcb_x0 + h[0], pcb_y0 + h[1]]];

// Z stack (inserts need insert_len + 0.4 of hole plus floor_web under it)
hole_d     = fastener == "insert" ? insert_d : selftap_d;
z_pcb_bot  = snap_up(fastener == "insert"
                 ? max(z_floor + pcb_gap, insert_len + 0.4 + floor_web)
                 : z_floor + pcb_gap);
z_hole_bot = fastener == "insert" ? z_pcb_bot - (insert_len + 0.4) : floor_web;
z_pcb_top  = z_pcb_bot + pcb_t;
usb_zc     = z_pcb_top + usb_z_on_pcb;
usb_z0     = usb_zc - usb_open_h / 2;
// antennas: board coords -> enclosure coords
patch_c    = len(patch_pos) > 0 ? patch_pos : [pcb_W / 2, pcb_L / 2];
patch_xy   = [pcb_x0 + patch_c[0], pcb_y0 + patch_c[1]];
patch_fp   = patch_sz + patch_tol;               // worst-case footprint
radome_w   = patch_fp + 2 * patch_margin;
patch_stack = patch_tape + patch_h;
tx_s       = tx_side == "top" ? 0 : tx_side == "right" ? 1 : tx_side == "bottom" ? 2 : 3;
tx_along   = (tx_s == 1 || tx_s == 3) ? pcb_y0 + tx_pos : pcb_x0 + tx_pos;
tx_gap     = tx_s == 0 ? cav_y1 - (pcb_y0 + pcb_L) : tx_s == 1 ? cav_x - (pcb_x0 + pcb_W)
           : tx_s == 2 ? pcb_y0 - cav_y0 : pcb_x0 + cav_x;   // board edge to wall
tx_jw      = sma_body[0] / 2;
tx_jt      = sma_body[1];
tx_notch   = tx_notch_d > 0 ? tx_notch_d : tx_jt + 0.2 - tx_gap;   // jack body cut into the board edge
tx_nw      = tx_notch_w > 0 ? tx_notch_w / 2 : tx_jw + 0.3;        // notch half-width
sma_z      = z_pcb_top + sma_axis_z;
sma_hole   = sma_thread + sma_clr;
jack_a     = tx_s == 0 ? [tx_along - tx_jw, cav_y1 - tx_jt] : tx_s == 1 ? [cav_x - tx_jt, tx_along - tx_jw]
           : tx_s == 2 ? [tx_along - tx_jw, cav_y0]         : [-cav_x, tx_along - tx_jw];
jack_b     = tx_s == 0 ? [tx_along + tx_jw, cav_y1]         : tx_s == 1 ? [cav_x, tx_along + tx_jw]
           : tx_s == 2 ? [tx_along + tx_jw, cav_y0 + tx_jt] : [-cav_x + tx_jt, tx_along + tx_jw];
sma_top    = sma_axis_z + sma_body[2] / 2;       // flange top above the board top
patch_top_max = patch_h + patch_tape_max;        // worst-case patch top above the board
// lid underside above the board top. Each term only where it still applies:
//  general parts + 0.5; USB overmold opening if the lid bridges it; patch:
//  window -> patch top patch_recess_min below the outer face, radome ->
//  patch_gap of air under the recessed radome; SMA flange via a local recess
//  that leaves lid_local_min (legacy); mated U.FL + ufl_lid_clr.
top_clear  = max(top_parts_h + 0.5,
                 use_fxp ? ufl_mated_h + ufl_lid_clr : 0,
                 usb_open_top ? 0 : usb_zc + usb_open_h / 2 - z_pcb_top,
                 !use_patch ? 0 : patch_window ? patch_top_max + patch_recess_min - lid_t
                                               : patch_stack + patch_gap - (lid_t - patch_cover),
                 use_sma ? sma_top + sma_lid_clr - (lid_t - lid_local_min) : 0);
z_seam     = z_pcb_top + top_clear;              // lid underside
z_wall     = z_seam - seam_gap;                  // base wall top
z_top      = z_seam + lid_t;
sma_recess = use_sma ? max(0, sma_top + sma_lid_clr - top_clear) : 0;   // lid underside recess over the flange
lip_band   = lip_clr + lip_t - pcb_clr;          // lid lip overlap onto the board edge

// floor pockets
pin_xy      = patch_xy + patch_pin_off;
pin_below   = patch_pin - pcb_t;                 // conservative protrusion (ignores the tape)
z_pin_floor = use_patch && pin_pocket ? min(z_floor, snap_dn(z_pcb_bot - pin_below - 0.3)) : z_floor;
flange_loc  = [[-tx_jw - sma_pocket_clr, -tx_jt - sma_pocket_clr], [tx_jw + sma_pocket_clr, 0]];
leg_ok      = [for (i = [-1, 1]) off_ring(grect(tx_s, tx_along, leg_loc(i, sma_leg_l, sma_pocket_clr)), pocket_wall)];
leg_cut     = [for (k = [0, 1]) use_sma && !leg_ok[k] && sma_leg_cut];
leg_len     = [for (k = [0, 1]) leg_cut[k] ? sma_leg_stub : sma_leg_l];
leg_pkt     = [for (k = [0, 1]) use_sma && sma_pocket && (leg_ok[k] || leg_cut[k])];
z_sma_floor = use_sma && sma_pocket
    ? min(z_floor, snap_dn(min(sma_z - sma_body[2] / 2, z_pcb_bot - sma_leg_below) - sma_pocket_clr))
    : z_floor;
stake_xy    = [for (s = usb_stakes) [usb_x + s[0], pcb_y0 - usb_overhang + s[1]]];
z_usb_floor = usb_stake_pocket ? min(z_floor, max(z_pause, snap_dn(z_pcb_bot - usb_stake_below - 0.2)))
                               : z_floor;

// PCB screws: longest stock length (under the head) through the board
// whose tip stops 0.3 mm above the bottom of the insert / pilot hole
tip_z       = z_hole_bot + 0.3;
fits        = [for (l = screw_lengths) if (l <= z_pcb_top - tip_z) l];
screw_L     = len(fits) > 0 ? max(fits) : 0;
engage      = screw_L - pcb_t;                   // thread below the board

// snap fit: beads on the lid lip, grooves in the base walls
snap_z  = z_seam - lip_h + 0.4 + snap_p;         // bead centre height
snap_gd = snap_p - lip_clr + snap_clr;           // groove depth into the wall

// ---- TX: FXP70 flex antenna, U.FL (J3) and cable ----
fxp_bay   = use_fxp && fxp_mount == "bay";          // fxp70 side bay
fxp_lid   = use_fxp && fxp_mount == "lid";          // this revision: flex in the lid
ufl_xy    = [pcb_x0 + ufl_pos[0], pcb_y0 + ufl_pos[1]];
pcb_xr    = pcb_x0 + pcb_W;                        // board right edge
lip_in    = cav_x - lip_clr - lip_t;               // inner face of the lid lip, right wall
x_run     = ufl_xy[0];                             // cable run over the board (plug axis)
y_crimp   = ufl_xy[1] - ufl_crimp;                 // cable leaves the crimp heading -Y
z_plug_c  = z_pcb_top + ufl_cable_z;
z_lie     = z_pcb_top + cable_d / 2;               // cable centre lying on the board
// flex pocket on the shelf
pk_d      = layer_h * ceil((fxp_t + fxp_adh) / layer_h - 1e-6);   // whole layers
z_shelf   = snap_dn(z_seam - fxp_lid_air - fxp_solder_h - (fxp_t + fxp_adh - pk_d));
z_pk      = z_shelf - pk_d;                        // pocket floor
z_flex_nom = z_pk + fxp_adh + fxp_t_nom;           // flex top, nominal
z_flex_max = z_pk + fxp_adh + fxp_t;               // flex top, worst case
z_cab_flex = z_flex_nom + cable_d / 2;
pk_x0     = pcb_xr + ant_gnd_gap;                  // pocket inner edge
fx0       = pk_x0 + fxp_clr;                       // flex cable-exit edge, nominal
pk_x1     = pk_x0 + fxp_sz[0] + fxp_tol + 2 * fxp_clr;
// cable path: crimp -> end of the straight lead (now on the board) -> start
// of the bend -> end of the bend (heading +X) -> flex edge. Only the run
// along -Y depends on the exit height y_c; solve it for the nominal free
// length. The pocket lets the flex move fxp_slide either way in Y.
cable_free = cable_len - fxp_cable_pad;
cab_p0    = [x_run, y_crimp, z_plug_c];
cab_p1    = [x_run, y_crimp - cable_lead, z_lie];
cab_l01   = norm(cab_p1 - cab_p0);
cab_arc   = PI * cable_bend_r / 2;
cab_x3    = x_run + cable_bend_r;                  // end of the bend
cab_l34   = norm([fx0 - cab_x3, z_cab_flex - z_lie]);
y_c       = y_crimp - cable_lead - cable_bend_r + cab_l01 + cab_arc + cab_l34 - cable_free;
y_c_lo    = y_c - fxp_slide;                       // cable_len + tol: flex lower
y_c_hi    = y_c + fxp_slide;                       // cable_len - tol: flex higher
cab_run   = y_crimp - cable_lead - cable_bend_r - y_c_hi;   // shortest straight run along -Y
function cab_pts(yc) = concat([cab_p0, cab_p1],
    [for (i = [0 : 8]) let(a = 90 * i / 8)
        [x_run + cable_bend_r * (1 - cos(a)), yc + cable_bend_r * (1 - sin(a)), z_lie]],
    [[fx0, yc, z_cab_flex], [fx0 + fxp_on_flex, yc, z_cab_flex]]);
function pl_len(p, n) = n < 1 ? 0 : norm(p[n] - p[n - 1]) + pl_len(p, n - 1);
cab_len_chk = pl_len(cab_pts(y_c), len(cab_pts(y_c)) - 2);  // crimp to flex edge (chorded arc)
function z_cab_bot(x) = z_pcb_top + max(0, min(1, (x - cab_x3) / (fx0 - cab_x3))) * (z_flex_nom - z_pcb_top);
slot_hw   = cable_d / 2 + 0.25;                    // cable slot / trough half-width at one position
slot_y0   = y_c_lo - slot_hw;
slot_y1   = y_c_hi + slot_hw;
slot_c    = (slot_y0 + slot_y1) / 2;
// pocket in Y: the cable sits fxp_c_off below the flex's top (+Y) edge
pk_y1     = y_c_hi + fxp_c_off + fxp_c_off_tol + fxp_clr;
pk_y0     = y_c_lo - (fxp_sz[1] + fxp_tol - fxp_c_off + fxp_c_off_tol) - fxp_clr;
// antenna bay: shares the main right wall; bottom wall flush with the main one
bay_lip_w = lip_clr + lip_t + 0.2;                 // room for the lid lip on the bay's top wall
bay_cx0   = out_x;
bay_cx1   = pk_x1 + shelf_rim;
bay_cy0   = cav_y0;
shelf_y1  = pk_y1 + shelf_rim;
bay_cy1   = shelf_y1 + (snap_bay ? bay_lip_w : 0);
bay_ox1   = bay_cx1 + wall_t;
bay_oy1   = bay_cy1 + wall_t;
z_bay_floor = snap_up(floor_web);
bay_snap_x = (bay_cx0 + bay_cx1) / 2;
out_x1    = fxp_bay ? bay_ox1 : out_x;             // outside right edge
// flex area covered for every slide position and tolerance
flex_sure = [[pk_x1 - (fxp_sz[0] - fxp_tol), y_c_hi + fxp_c_off + fxp_c_off_tol - (fxp_sz[1] - fxp_tol)],
             [pk_x0 + fxp_sz[0] - fxp_tol, y_c_lo + fxp_c_off - fxp_c_off_tol]];
hd_in     = holddown_d / 2 + 0.3;
hd_pts    = [[flex_sure[1][0] - hd_in, flex_sure[0][1] + hd_in], [flex_sure[1][0] - hd_in, flex_sure[1][1] - hd_in],
             [flex_sure[0][0] + hd_in, flex_sure[0][1] + hd_in]];
// lid-side cable keepers: [x0, y0, x1, y1, end height]
trough_xm = (bay_cx0 + pk_x0) / 2;
keepers   = concat([for (y = keeper_y) [x_run - keeper_sz[0] / 2, y - keeper_sz[1] / 2,
                                        x_run + keeper_sz[0] / 2, y + keeper_sz[1] / 2,
                                        z_pcb_top + cable_d + keeper_clr]],
                   [[trough_xm - 1.5, slot_y0 - 0.5, trough_xm + 1.5, slot_y1 + 0.5,
                     z_cab_bot(trough_xm) + cable_d + keeper_clr]]);
// distances reported and checked
patch_a   = patch_xy - [patch_fp, patch_fp] / 2;
patch_b   = patch_xy + [patch_fp, patch_fp] / 2;
fxp_rx_d  = rr_dist(patch_a, patch_b, [pk_x0, pk_y0], [pk_x1, pk_y1]);
fxp_c     = [(pk_x0 + pk_x1) / 2, (pk_y0 + pk_y1) / 2];
cab_rx_d  = x_run - cable_d / 2 - patch_b[0];

// ---- TX in the lid (fxp_mount = "lid") ----
// Flex 26.9 (X) x 24.9 (Y), adhesive up against the pocket ceiling, cable side
// down. Its exit edge faces the patch window; the cable leaves it toward -Y at
// fxp_c_off from the flex's +X edge. The flex is pushed into the pocket's +X /
// +Y corner, so the cable X follows the pocket and the flex keeps the most
// distance from the window that the pocket allows.
// Cable: on the flex -> groove -> lid leg in clip rails (-Y, against the lid
// underside) -> tilted 180 deg hairpin of radius hp_r (lid level, inner, to
// board level, outer) -> board leg (+Y, lying on the board at its right edge)
// -> S-jog (two hp_r arcs) to the plug axis -> straight lead into the crimp
// (plug cable toward -Y, as fxp70). The hairpin floats: it takes up the
// 53 +/-2 cable tolerance by moving +/-1 in Y.
fl_x      = fxp_sz[1];                             // 26.9, carries the cable exit
fl_y      = fxp_sz[0];                             // 24.9
win_y1    = patch_xy[1] + radome_w / 2;            // patch window edge toward the top band
win_x1    = patch_xy[0] + radome_w / 2;            // window edge toward the right wall
z_lpk     = z_top - lid_skin;                      // pocket ceiling
lpk_d     = z_lpk - z_seam;                        // pocket depth into the lid underside
z_fl_lo_nom = z_lpk - fxp_adh - fxp_t_nom;         // flex cable-side face, nominal (highest)
z_fl_lo_max = z_lpk - fxp_adh - fxp_t;             // worst (thickest) flex: lowest face
z_fl_mid  = z_lpk - fxp_adh - fxp_t_nom / 2;       // copper, nominal
z_cab_on  = z_fl_lo_nom - cable_d / 2;             // cable centre lying on the flex
z_ll      = z_seam - cable_d / 2;                  // lid leg: cable against the lid underside
z_bl      = z_lie;                                 // board leg: cable lying on the board
hp_r      = cable_bend_r;
hp_dz     = z_ll - z_bl;
hp_s      = sqrt(max(0, 4 * hp_r * hp_r - hp_dz * hp_dz));   // hairpin leg spacing in X
x_bl      = min(cav_x - leg_wall_clr, pcb_xr) - cable_d / 2; // board leg, on the board's right edge
x_ll      = x_bl - hp_s;                           // lid leg = cable exit X
x_ex_tol  = fxp_c_off_tol + 0.1;                   // exit X tolerance (offset + pushing)
lpk_x1    = x_ll + fxp_c_off;                      // pocket +X edge = flex +X edge
lpk_x0    = lpk_x1 - (fl_x + fxp_tol + 2 * lid_fxp_clr);
lpk_y0    = win_y1 + win_web;
lpk_y1    = lpk_y0 + fl_y + fxp_tol + 2 * lid_fxp_clr;
fl_y0     = lpk_y1 - fl_y;                         // flex exit edge, nominal flex
fl_y0_lo  = lpk_y1 - (fl_y + fxp_tol);             // largest flex (closest to the window)
fl_y0_hi  = lpk_y1 - (fl_y - fxp_tol);
fl_c      = [lpk_x1 - fl_x / 2, lpk_y1 - fl_y / 2];  // flex centre, nominal
y_clip0   = fl_y0 - clip_off;                      // first clip (fixed in the lid)
// S-jog from the board leg (x_bl) to the plug axis (x_run), then the lead
jog_h     = x_bl - x_run;
jog_th    = acos(max(-1, min(1, 1 - jog_h / (2 * hp_r))));   // degrees
jog_run   = 2 * hp_r * sin(jog_th);
jog_arc   = 2 * hp_r * jog_th * PI / 180;
y_j1      = y_crimp - cable_lead;                  // end of the jog = start of the lead
y_j0      = y_j1 - jog_run;                        // start of the jog = end of the board leg
lead_l    = norm([0, cable_lead, z_plug_c - z_bl]);
// free length L from the flex edge yf to the crimp:
//   drop to the first clip + lid leg + pi hp_r + board leg + jog + lead
function y_hp(L, yf) = (norm([0, yf - y_clip0, z_cab_on - z_ll]) + y_clip0 + PI * hp_r
                        + y_j0 + jog_arc + lead_l - L) / 2;
y_u       = y_hp(cable_free, fl_y0);               // hairpin ends (both legs), nominal
y_u_lo    = y_hp(cable_free + cable_tol, fl_y0_lo); // longest cable: hairpin lowest
y_u_hi    = y_hp(cable_free - cable_tol, fl_y0_hi); // shortest cable: hairpin highest
// hairpin: a 3D semicircle of radius hp_r from the board leg (ph 0) to the lid leg (ph 180)
function hp_pt(yu, ph) = [(x_ll + x_bl) / 2 + hp_s / 2 * cos(ph), yu - hp_r * sin(ph),
                          (z_ll + z_bl) / 2 + (z_bl - z_ll) / 2 * cos(ph)];
function lcab_pts(yu) = concat(
    [[x_ll, fl_y0 + fxp_on_flex, z_cab_on], [x_ll, fl_y0, z_cab_on], [x_ll, y_clip0, z_ll]],
    [for (i = [0 : 16]) hp_pt(yu, 180 - 180 * i / 16)],
    [for (i = [0 : 8]) let(a = jog_th * i / 8) [x_bl - hp_r * (1 - cos(a)), y_j0 + hp_r * sin(a), z_bl]],
    [for (i = [1 : 8]) let(b = jog_th * (8 - i) / 8) [x_run + hp_r * (1 - cos(b)), y_j1 - hp_r * sin(b), z_bl]],
    [[x_run, y_crimp, z_plug_c]]);
lcab      = lcab_pts(y_u);
lcab_chk  = pl_len(lcab, len(lcab) - 1) - norm(lcab[1] - lcab[0]);   // flex edge to crimp
// lid features
rail_lo   = y_u_hi + rail_end_m;                   // rails end above the highest hairpin
rail_hw   = cable_d / 2 + rail_clr;                // half gap between the rails
z_cab_bot_ll = z_ll - cable_d / 2;
z_rail_bot = z_cab_bot_ll - 0.4;                   // rails reach 0.4 below the cable
groove_hw = cable_d / 2 + x_ex_tol + groove_clr;
top_cut   = [lpk_x0 - lip_cut_m, lpk_x1 + lip_cut_m];    // top-wall lid lip removed
notch_need = x_bl + cable_d / 2 > lip_in - 0.3;
// lid keepers [x0, y0, x1, y1, end height]: board leg straight, S-jog midpoint
lk_bl_y   = (y_u_hi + y_j0) / 2;
jm        = [(x_bl + x_run) / 2, y_j0 + jog_run / 2];      // jog midpoint (inflection)
lk_len_j  = 2.0;                                           // jog keeper length (Y)
jm_dx     = lk_len_j / 2 * tan(jog_th);                    // cable X change over the keeper
notch_y   = [y_u_lo - hp_r - lip_cut_m, jm[1] + lk_len_j / 2 + lip_cut_m];   // right-wall lip notch
lkeepers  = [[x_bl - lk_w / 2, lk_bl_y - lk_len / 2, min(x_bl + lk_w / 2, cav_x - lip_clr), lk_bl_y + lk_len / 2,
              z_pcb_top + cable_d + keeper_clr],
             [jm[0] - jm_dx - lk_w / 2, jm[1] - lk_len_j / 2, min(jm[0] + jm_dx + lk_w / 2, cav_x - lip_clr), jm[1] + lk_len_j / 2,
              z_pcb_top + cable_d + keeper_clr]];
// distances reported and checked
l_gnd     = z_fl_mid - z_pcb_top;                  // flex copper over the board-top GND pour
l_gnd2    = l_gnd + 0.035 + 0.2104;                // ... over the solid L2 GND (stackup)
l_rx      = fl_y0_lo - patch_b[1];                 // flex to patch footprint, worst (largest flex)
l_rx_nom  = fl_y0 - (patch_xy[1] + patch_sz / 2);  // nominal flex to nominal patch
l_win     = fl_y0_lo - win_y1;                     // flex to the window edge, worst
// lid leg to the patch footprint: the free cable from the flex edge (x_ll +/-
// x_ex_tol) to the first clip (x_ll), then the rails and the hairpin (x >= x_ll)
l_cab_rx  = min([for (t = [0 : 0.1 : 1]) rect_dist([x_ll - x_ex_tol * (1 - t), fl_y0 - t * (fl_y0 - y_clip0)],
                                                   patch_a, patch_b) - cable_d / 2]);
l_ufl_xy  = ufl_xy[0] - ufl_plug_w / 2 - lpk_x1;   // flex +X edge to the plug body, in plane
l_ufl_z   = z_fl_lo_nom - (z_pcb_top + ufl_mated_h);
l_ufl     = norm([max(0, l_ufl_xy), max(0, l_ufl_z)]);
fl_route  = [[x_ll - x_ex_tol - cable_d / 2 - 0.3, y_u_lo - hp_r - cable_d / 2 - 0.3],
             [x_bl + cable_d / 2 + 0.3, y_crimp]];   // hairpin + board leg + jog + lead
// image theory: horizontal current at height h over a ground plane; radiated
// power (radiation resistance) relative to free space for the same current
function img_ratio(h) = let(x = 2 * (2 * PI * fxp_freq / 299.792458) * h, d = 180 / PI)
    2 * (1 - 1.5 * (sin(x * d) / x + cos(x * d) / (x * x) - sin(x * d) / (x * x * x)));
// true if point p lies inside the outer outline shrunk by m
function in_outer(p, m) = let(cx = min(max(p[0], -out_x + out_r), out_x - out_r),
                              cy = min(max(p[1], out_y0 + out_r), out_y1 - out_r))
    abs(p[0]) <= out_x - m && p[1] >= out_y0 + m && p[1] <= out_y1 - m
    && norm([p[0] - cx, p[1] - cy]) <= out_r - m + 1e-6;
// snap beads (after the bay, which carries one)
snaps   = concat([for (y = snap_right_y) [1, y]], [for (y = snap_side_y) [3, y]],
                 [for (x = snap_top_x) [0, x]], [for (x = snap_bot_x) [2, x]],
                 fxp_bay && snap_bay ? [[4, bay_snap_x]] : []);

// optional lid vents: board coords -> enclosure coords
vent_xy = [pcb_x0 + vent_c[0], pcb_y0 + vent_c[1]];
vent_ys = [for (i = [0 : max(vent_n, 1) - 1]) vent_xy[1] + (i - (vent_n - 1) / 2) * vent_pitch];
vent_a  = [vent_xy[0] - vent_len / 2, vent_xy[1] - ((vent_n - 1) * vent_pitch + vent_w) / 2];
vent_b  = [vent_xy[0] + vent_len / 2, vent_xy[1] + ((vent_n - 1) * vent_pitch + vent_w) / 2];

// ---------------------------------------------------------------------
// Design checks
// ---------------------------------------------------------------------
assert(skin_t >= 0.5 - 1e-6 && skin_t <= 0.8 + 1e-6,
    str("Skin over the magnets is ", r2(skin_t),
        " mm; totalElement's 3D-print band is 0.5-0.8 mm. Change skin_layers."));
assert(pcb_W > 0 && pcb_L > 0, "PCB size must be positive");
assert(z_pause - skin_t - mag_t >= 0.1 - 1e-6,
    "Magnets would stand above the pause layer; raise mag_clr_z");
assert(cap_layers >= 2, "Use at least 2 cap layers over the magnets (the first one is a bridge)");
assert(screw_L > 0, "No stock screw length fits; extend screw_lengths");
assert(engage >= 1.5, "Less than 1.5 mm of PCB screw thread below the board");
assert(z_pcb_top + screw_head_h + 0.3 <= z_seam - lip_h || screw_head_h + 0.3 <= top_clear,
    "PCB screw heads hit the lid");
assert(snap_p > lip_clr, "snap_p must exceed lip_clr or the beads never engage");
assert(snap_z + snap_gd + 1.0 <= z_wall, "Snap grooves too close to the wall top; increase lip_h");
assert(snap_gd <= wall_t - 1.0, "Snap grooves leave less than 1 mm of wall");
for (s = snaps) {
    assert(s[1] - snap_len / 2 - 0.5 >= side_run(s[0])[0] && s[1] + snap_len / 2 + 0.5 <= side_run(s[0])[1],
        str("Snap bead ", s, " runs onto a corner radius"));
    assert(!use_sma || s[0] != tx_s || abs(s[1] - tx_along) >= snap_len / 2 + max(tx_jw, sma_hole / 2) + 1,
        str("Snap bead ", s, " runs into the TX slot"));
    assert(s[0] != 2 || abs(s[1] - usb_x) >= snap_len / 2 + usb_open_w / 2 + 1,
        str("Snap bead ", s, " runs into the USB-C opening"));
    assert(!pry_notch || s[0] != 2 || abs(s[1] - pry_x) >= snap_len / 2 + pry_w / 2 + 1,
        str("Snap bead ", s, " runs into the pry notch"));
}
assert(!pry_notch || (abs(pry_x - usb_x) >= usb_open_w / 2 + pry_w / 2 + 1
                   && pry_x - pry_w / 2 >= side_run(2)[0] && pry_x + pry_w / 2 <= side_run(2)[1]
                   && (!use_sma || tx_s != 2 || abs(pry_x - tx_along) >= pry_w / 2 + sma_hole / 2 + 1)),
    "Pry notch overlaps the USB-C opening, TX slot or a corner; move pry_x");
assert(z_hole_bot >= floor_web - 1e-6, "Fastener hole too close to the phone face");
assert(norm([cav_x - cav_r, cav_y1 - cav_r]) >= ring_ro,
    "Cavity corner radius cuts into the ring pocket; reduce pcb_r");
assert(!use_clock || clk_y0 - 0.4 >= cav_y0, "Clocking-magnet pocket runs into the bottom wall");
assert(usb_z0 >= z_floor + 0.5, "USB-C opening runs into the floor");
assert(abs(usb_x) + usb_open_w / 2 <= cav_x - cav_r, "USB-C opening runs into a corner");
assert(z_seam - lip_h >= z_pcb_top + 0.5, "Lid lip reaches the PCB");
for (i = [0 : len(holes) - 1]) {
    assert(norm(holes[i]) - standoff_d / 2 >= ring_ro + 0.5
           || norm(holes[i]) + standoff_d / 2 <= ring_ri - 0.5,
        str("Standoff for board hole ", holes_pcb[i], " lands on the ring pocket. Keep hole centres more than ",
            r2(ring_ro + 0.5 + standoff_d / 2), " mm or less than ", r2(ring_ri - 0.5 - standoff_d / 2),
            " mm from the ring centre, which is at board ", [r2(-pcb_x0), r2(-pcb_y0)]));
    assert(!use_clock
           || rect_dist(holes[i], [clk_x0, clk_y0], [clk_x1, clk_y1]) >= standoff_d / 2 + 0.5,
        str("Standoff for board hole ", holes_pcb[i], " lands on the clocking-magnet pocket"));
    assert(rect_dist(holes[i],
                     [usb_x - max(usb_open_w, usb_body[0]) / 2, cav_y0 - wall_t],
                     [usb_x + max(usb_open_w, usb_body[0]) / 2, pcb_y0 - usb_overhang + usb_body[1]])
           >= max(standoff_d, screw_head_d) / 2 + 0.3,
        str("Standoff for board hole ", holes_pcb[i], " collides with the USB-C receptacle or opening"));
    assert(holes_pcb[i][0] >= pcb_hole_d / 2 + 0.5 && holes_pcb[i][0] <= pcb_W - pcb_hole_d / 2 - 0.5
           && holes_pcb[i][1] >= pcb_hole_d / 2 + 0.5 && holes_pcb[i][1] <= pcb_L - pcb_hole_d / 2 - 0.5,
        str("Board hole ", holes_pcb[i], " is off the board"));
    assert(!use_patch || rect_dist(holes[i], patch_xy - [radome_w, radome_w] / 2,
                                   patch_xy + [radome_w, radome_w] / 2) >= screw_head_d / 2 + 0.3,
        str("Board hole ", holes_pcb[i], " lands on the RX patch radome; move patch_pos"));
    assert(!use_sma || rect_dist(holes[i], jack_a, jack_b) >= max(standoff_d, screw_head_d) / 2 + 0.3,
        str("Board hole ", holes_pcb[i], " collides with the TX jack; move tx_pos"));
}
assert(!use_patch || (patch_c[0] - patch_fp / 2 >= 1 && patch_c[0] + patch_fp / 2 <= pcb_W - 1
                   && patch_c[1] - patch_fp / 2 >= 1 && patch_c[1] + patch_fp / 2 <= pcb_L - 1),
    "RX patch footprint runs off the board; move patch_pos");
// (rev_pcb checked z_floor; here the floor under the pin is the pin pocket's)
assert(!use_patch || z_pcb_bot - z_pin_floor >= patch_pin - pcb_t + 0.3 - 1e-6,
    "RX patch feed pin and solder reach the floor; enable pin_pocket, raise pcb_gap or trim the pin");
assert(patch_cover > 0 && patch_cover <= lid_t, "patch_cover must be in (0, lid_t]");
assert(!use_sma || (tx_along - max(tx_jw, sma_hole / 2) - 0.5 >= side_run(tx_s)[0]
                && tx_along + max(tx_jw, sma_hole / 2) + 0.5 <= side_run(tx_s)[1]),
    "TX jack runs onto a corner radius; move tx_pos");
assert(!use_sma || (tx_gap >= -1e-6 && tx_notch > 0),
    "Board edge on the TX side must sit within the jack body thickness of the wall");
assert(!use_sma || (tx_notch + tx_gap >= tx_jt + 0.1 - 1e-6 && tx_nw >= tx_jw + 0.2 - 1e-6),
    str("Board notch ", r2(tx_notch), " x ", r2(2 * tx_nw), " mm is too small for the ",
        sma_body[0], " x ", tx_jt, " mm jack flange; enlarge tx_notch_d / tx_notch_w"));
// the slot, its lower arc and the tongue's arc are all concentric with the
// barrel at sma_hole, so the radial clearance is (sma_hole - sma_thread) / 2
assert(!use_sma || sma_hole - sma_thread >= 0.2 - 1e-6,
    "SMA slot/tongue leave under 0.1 mm radial on the 1/4-36 barrel; raise sma_clr");
assert(!vent_slots || (vent_n >= 1 && vent_pitch > vent_w + 0.8),
    "Vent slots need vent_n >= 1 and at least 0.8 mm of lid between slots");
assert(!vent_slots || (vent_a[0] >= -cav_x + lip_clr + lip_t + 1 && vent_b[0] <= cav_x - lip_clr - lip_t - 1
                    && vent_a[1] >= cav_y0 + lip_clr + lip_t + 1 && vent_b[1] <= cav_y1 - lip_clr - lip_t - 1),
    "Vent slots run onto the lid lip; move vent_c or shorten them");
assert(!vent_slots || !use_patch || !rects_hit(vent_a, vent_b, patch_xy - [radome_w, radome_w] / 2,
                                               patch_xy + [radome_w, radome_w] / 2, 3),
    "Vent slots within 3 mm of the RX patch radome; move vent_c");
assert(!vent_slots || !use_sma || !rects_hit(vent_a, vent_b, jack_a, jack_b, vent_keep),
    str("Vent slots within ", vent_keep, " mm of the TX jack; move vent_c"));
// (rev_pcb checked z_floor; here the floor under the jack is the SMA pocket's)
assert(!use_sma || sma_z - sma_body[2] / 2 >= z_sma_floor + 0.2 - 1e-6,
    "TX jack body hits the floor; enable sma_pocket, raise pcb_gap or sma_axis_z");
assert(!use_sma || sma_z - sma_hole / 2 >= skin_t + 0.6, "TX jack hole reaches the skin");
assert(!use_sma || sma_barrel - wall_t >= 4.0,
    "Too little SMA thread outside the wall for the antenna to seat; use a longer-barrel jack");
assert(!use_sma || tx_s != 2 || abs(tx_along - usb_x) >= max(tx_jw, sma_hole / 2) + usb_open_w / 2 + 1,
    "TX jack and USB-C opening overlap on the bottom wall");
assert(!(use_sma && use_patch) || !rects_hit(patch_xy - [patch_fp, patch_fp] / 2,
                                           patch_xy + [patch_fp, patch_fp] / 2, jack_a, jack_b, 1),
    "RX patch runs into the TX jack");

// ---- low-profile checks ----
assert(lid_t >= 1.0 - 1e-6, "lid_t below 1.0 mm: too thin for a PETG snap lid");
assert(pcb_gap >= 0.3 - 1e-6, "pcb_gap below 0.3 mm (flat pads, board bow, cap pillowing)");
assert(z_seam - lip_h - z_pcb_top >= edge_parts_h + 0.1 - 1e-6,
    str("Only ", r2(z_seam - lip_h - z_pcb_top), " mm under the lid lip for ", edge_parts_h,
        " mm edge parts; reduce lip_h (>= 2.2) or raise top_clear"));
for (i = [0 : len(holes) - 1]) let(h = holes_pcb[i])
    assert(min(h[0], h[1], pcb_W - h[0], pcb_L - h[1]) - screw_head_d / 2 >= lip_band + 0.3 - 1e-6
           || z_pcb_top + screw_head_h + 0.3 <= z_seam - lip_h,
        str("Screw head at board hole ", h, " runs under the lid lip"));
assert(sma_recess <= lid_t - lid_local_min + 1e-6,
    str("SMA lid recess leaves under ", lid_local_min, " mm of lid"));
assert(!use_patch || patch_tape <= patch_tape_max + 1e-6, "patch_tape above patch_tape_max");
assert(!use_patch || !patch_window
       || (patch_margin >= 1.0 - 1e-6 && z_top - (z_pcb_top + patch_top_max) >= patch_recess_min - 1e-6),
    "Patch window: keep patch_margin >= 1.0 and the worst-case patch top patch_recess_min below the lid face");
assert(!use_patch || patch_window
       || z_top - patch_cover - (z_pcb_top + patch_top_max) >= patch_air_min - 1e-6,
    str("Radome: under ", patch_air_min, " mm of air over the patch at patch_tape_max; raise patch_gap"));
assert(usb_open_top || usb_z0 + usb_open_h <= z_seam + 1e-6,
    "USB-C overmold opening is taller than the base wall; set usb_open_top or raise top_clear");
// patch feed pin pocket
assert(!use_patch || !pin_pocket
       || norm(pin_xy) + pin_pocket_d / 2 <= ring_ri - pocket_wall
       || norm(pin_xy) - pin_pocket_d / 2 >= ring_ro + pocket_wall,
    "Feed pin pocket runs into the ring pocket");
assert(!use_patch || !pin_pocket || !use_clock
       || rect_dist(pin_xy, [clk_x0, clk_y0], [clk_x1, clk_y1]) >= pin_pocket_d / 2 + pocket_wall,
    "Feed pin pocket runs into the clocking-magnet pocket");
assert(!use_patch || !pin_pocket || !label || abs(pin_xy[1]) - pin_pocket_d / 2 >= 5,
    "Feed pin pocket runs into the MAGNETS DOWN / STEEL UP label");
assert(z_pin_floor >= floor_web - 1e-6 && z_sma_floor >= floor_web - 1e-6 && z_usb_floor >= floor_web - 1e-6,
    "A floor pocket comes within floor_web of the phone face");
// SMA flange / leg pocket
assert(!use_sma || !sma_pocket || off_ring(grect(tx_s, tx_along, flange_loc), pocket_wall),
    "SMA flange pocket runs into the ring pocket");
for (k = [0, 1]) {
    assert(!leg_pkt[k] || off_ring(grect(tx_s, tx_along, leg_loc(2 * k - 1, leg_len[k], sma_pocket_clr)), pocket_wall),
        str("SMA leg ", k, " pocket (", r2(leg_len[k]), " mm leg) runs into the ring pocket; shorten sma_leg_stub"));
    assert(!use_sma || !leg_pkt[k] || z_pcb_bot - sma_leg_below - z_sma_floor >= 0.2 - 1e-6,
        str("SMA lower leg ", k, " hits its pocket floor"));
    assert(!use_sma || leg_pkt[k] || z_pcb_bot - sma_leg_below - z_floor >= 0.2 - 1e-6,
        str("SMA lower leg ", k, " lies over the ring and hits the cap: set sma_leg_cut = true (cut it) or pcb_gap = 1.3"));
}
// USB-C shell stakes
for (p = stake_xy) {
    assert(z_pcb_bot - usb_stake_below - z_usb_floor >= 0.2 - 1e-6,
        "USB-C shell stakes reach the floor; clip them or enable usb_stake_pocket");
    assert(!usb_stake_pocket || !use_clock
           || rr_dist(p - usb_stake_pkt / 2, p + usb_stake_pkt / 2, [clk_x0, clk_y0], [clk_x1, clk_y1])
              >= (z_usb_floor >= z_pause - 1e-6 ? 0.5 : pocket_wall) - 1e-6,
        "USB-C stake pocket too close to the clocking-magnet pocket");
    assert(!usb_stake_pocket || !use_clock
           || min([for (x = [clk_x0, clk_x1], y = [clk_y0, clk_y1])
                   rect_dist([x, y], p - usb_stake_pkt / 2, p + usb_stake_pkt / 2)]) >= 0.4 + 0.5,
        "USB-C stake pocket too close to a clocking-pocket corner relief");
    assert(!usb_stake_pocket || off_ring([p - usb_stake_pkt / 2, p + usb_stake_pkt / 2], pocket_wall),
        "USB-C stake pocket runs into the ring pocket");
}

// ---- FXP70 checks ----
assert(!(use_fxp && use_sma), "use_fxp and use_sma both on: the board has one TX output (J3)");
if (use_fxp) {
    // U.FL
    assert(ufl_pos[0] - ufl_plug_w / 2 >= 0.5 && ufl_pos[0] + ufl_plug_w / 2 <= pcb_W - 0.5
           && ufl_pos[1] - ufl_crimp >= 0.5 && ufl_pos[1] + ufl_plug_w / 2 <= pcb_L - 0.5,
        "U.FL plug runs off the board; check ufl_pos");
    assert(z_pcb_top + ufl_mated_h + ufl_lid_clr <= z_seam + 1e-6,
        str("Mated U.FL (", ufl_mated_h, " max) leaves under ", ufl_lid_clr, " mm to the lid"));
    assert(ufl_xy[0] + ufl_plug_w / 2 <= lip_in - 0.3 || z_pcb_top + ufl_mated_h + 0.3 <= z_seam - lip_h,
        "U.FL plug runs under the lid lip");
    assert(cable_bend_r >= cable_bend_min - 1e-6, str("Cable bend radius below ", cable_bend_min, " mm"));
    assert(fxp_mount == "lid" || fxp_mount == "bay", "fxp_mount must be \"lid\" or \"bay\"");
}
if (fxp_bay) {
    assert(!vent_slots || !rects_hit(vent_a, vent_b, [x_run - ufl_plug_w / 2, y_c_lo],
                                     [bay_ox1, ufl_xy[1] + ufl_plug_w / 2], vent_keep),
        str("Vent slots within ", vent_keep, " mm of the U.FL / TX cable; move vent_c"));
    // cable
    assert(cable_bend_r >= cable_bend_min - 1e-6, str("Cable bend radius below ", cable_bend_min, " mm"));
    assert(cable_lead >= 2 - 1e-6 && cab_run >= 0, str("Cable path too short for the ", cable_len,
        " mm cable: no straight run left before the bend (", r2(cab_run), "); raise ant_gnd_gap or cable_bend_r"));
    assert(fxp_slide >= cable_tol - 1e-6, "fxp_slide must cover the cable length tolerance");
    assert(abs(cab_len_chk - cable_free) <= 0.15, str("Cable path ", r2(cab_len_chk), " != free length ", cable_free));
    assert(cab_x3 <= cav_x - 0.2, "Cable bend runs into the right wall; the cable must cross it square");
    assert(x_run + cable_d / 2 + 0.3 <= lip_in, "Cable run over the board lies under the lid lip");
    // where the bend enters the lip band (x > lip_in - 0.3) the lip notch must cover it
    assert(sqrt(max(0, pow(cable_bend_r, 2) - pow(cab_x3 - (lip_in - 0.3), 2))) >= cable_bend_r - (slot_hw - cable_d / 2 + 0.3) - 1e-6
           || cab_x3 <= lip_in - 0.3,
        "Cable bend enters the lid lip band outside the lip notch; reduce cable_bend_r");
    assert(cab_rx_d >= cable_rx_min - 1e-6,
        str("TX cable only ", r2(cab_rx_d), " mm from the RX patch (min ", cable_rx_min, ")"));
    for (i = [0 : len(holes) - 1]) let(h = holes[i])
        assert(rect_dist(h, [x_run, y_c_lo], [cav_x, y_crimp]) >= screw_head_d / 2 + cable_d / 2 + 0.3
               || (rect_dist(h, [x_run, y_c_lo + cable_bend_r], [x_run, y_crimp]) >= screw_head_d / 2 + cable_d / 2 + 0.3
                   && rect_dist(h, [x_run, y_c_lo], [cav_x, y_c_hi + cable_bend_r]) >= screw_head_d / 2 + cable_d / 2 + 0.3),
            str("TX cable runs over the screw head at board hole ", holes_pcb[i]));
    for (s = snaps) if (s[0] == 1)
        assert(abs(s[1] - slot_c) >= snap_len / 2 + (slot_y1 - slot_y0) / 2 + 1,
            str("Right-wall snap bead at y ", s[1], " runs into the cable slot; edit snap_right_y"));
    assert(slot_y0 - 0.5 >= side_run(1)[0] && slot_y1 + 0.5 <= side_run(1)[1], "Cable slot runs onto a corner radius");
    assert(slot_y0 >= bay_cy0 + bay_r + 0.5 && slot_y1 <= shelf_y1 - 0.5, "Cable slot misses the antenna bay");
    for (k = keepers) {
        assert(k[4] < z_seam - 0.5, "Cable keeper shorter than 0.5 mm");
        assert(!use_patch || k[0] >= patch_xy[0] + radome_w / 2 + 1, "Cable keeper runs into the patch window");
        assert(k[2] <= lip_in - 0.3 || k[0] >= cav_x, "Cable keeper runs into the lid lip");
    }
    for (y = keeper_y)
        assert(y - keeper_sz[1] / 2 >= y_c_hi + cable_bend_r && y + keeper_sz[1] / 2 <= y_crimp - cable_lead,
            str("Cable keeper at y ", y, " is off the straight run"));
    // flex and its pocket
    assert(pk_x0 - pcb_xr >= ant_gnd_min - 1e-6,
        str("Flex pocket only ", r2(pk_x0 - pcb_xr), " mm from the board ground (Taoglas min ", ant_gnd_min, ")"));
    assert(pk_x0 >= out_x + 1, "Flex pocket must sit in the bay, outside the main wall");
    assert(fxp_rx_d >= ant_rx_min - 1e-6,
        str("Flex pocket only ", r2(fxp_rx_d), " mm from the RX patch (min ", ant_rx_min, ")"));
    assert(rect_dist([0, 0], [pk_x0, pk_y0], [pk_x1, pk_y1]) >= ring_od / 2 + 4,
        "Flex within 4 mm of the ring magnet");
    assert(pk_d >= fxp_t + fxp_adh - 1e-6 && pk_d <= fxp_t + fxp_adh + layer_h + 1e-6,
        "Flex pocket depth must hold flex + adhesive (within one layer)");
    assert(z_seam - (z_flex_max + fxp_solder_h) >= fxp_lid_air - 1e-6,
        "Worst-case flex solder joint hits the lid; lower z_shelf");
    assert(shelf_t - pk_d >= 0.8 - 1e-6, "Shelf under the flex pocket thinner than 0.8 mm");
    assert(z_shelf - shelf_t - z_bay_floor >= 1.0, "No room for the shelf ribs");
    assert(z_bay_floor >= floor_web - 1e-6, "Bay floor thinner than floor_web");
    assert(pk_y0 - bay_cy0 >= max(0.4, 0.3 * bay_r) - 1e-6 && bay_cx1 - pk_x1 >= max(0.4, 0.3 * bay_r) - 1e-6,
        str("Flex pocket leaves under 0.4 mm of shelf to the bay wall (", r2(pk_y0 - bay_cy0), ")"));
    assert(bay_oy1 <= out_y1 - out_r && bay_cy0 >= cav_y0 - 1e-6,
        "Antenna bay must stay within the main body's length");
    assert(z_cab_bot(bay_cx0) >= z_pcb_top - 1e-6, "Cable dips below the wall slot floor");
    assert(!fxp_holddown || z_shelf + holddown_gap - z_flex_max >= 0.1 - 1e-6,
        "Hold-down pins press on the worst-case flex");
    for (p = hd_pts)
        assert(!fxp_holddown || (p[0] - holddown_d / 2 >= flex_sure[0][0] && p[0] + holddown_d / 2 <= flex_sure[1][0]
                                && p[1] - holddown_d / 2 >= flex_sure[0][1] && p[1] + holddown_d / 2 <= flex_sure[1][1]
                                && (p[0] - holddown_d / 2 >= fx0 + fxp_on_flex + 1 || abs(p[1] - y_c) >= fxp_slide + holddown_d / 2 + cable_d)),
            str("Hold-down pin at ", p, " is off the flex or on its cable"));
}
// ---- FXP70 in the lid ----
if (fxp_lid) {
    // pocket and lid
    assert(lid_skin >= lid_skin_min - 1e-6, str("lid_skin over the flex below ", lid_skin_min, " mm"));
    assert(lpk_d >= fxp_t + fxp_adh + 0.05 - 1e-6,
        str("Flex pocket ", r2(lpk_d), " deep: worst-case flex + adhesive (", fxp_t + fxp_adh,
            ") must sit inside it; reduce lid_skin"));
    assert(z_fl_lo_max >= z_seam + 0.05 - 1e-6, "Worst-case flex hangs below the lid underside (wall top would press it)");
    assert(!use_patch || lpk_y0 - win_y1 >= win_web_min - 1e-6,
        str("Only ", r2(lpk_y0 - win_y1), " mm of lid between the patch window and the flex pocket (min ", win_web_min, ")"));
    assert(!use_patch || !rects_hit([lpk_x0, lpk_y0], [lpk_x1, lpk_y1], patch_xy - [radome_w, radome_w] / 2,
                                    patch_xy + [radome_w, radome_w] / 2, win_web_min - 1e-6),
        "Flex pocket covers or touches the patch window");
    for (p = [[lpk_x0, lpk_y0], [lpk_x1, lpk_y0], [lpk_x0, lpk_y1], [lpk_x1, lpk_y1]])
        assert(in_outer(p, pk_rim_min), str("Flex pocket corner ", [r2(p[0]), r2(p[1])],
            " leaves under ", pk_rim_min, " mm to the outer edge"));
    assert(!usb_open_top || lpk_y0 > cav_y0 + 1, "Flex pocket runs into the USB-C lid notch");
    assert(!use_patch || l_rx >= lid_rx_min - 1e-6,
        str("Flex only ", r2(l_rx), " mm from the RX patch footprint (min lid_rx_min ", lid_rx_min, ")"));
    assert(l_gnd >= ant_gnd_min - 1e-6,
        str("Flex only ", r2(l_gnd), " mm above the board GND (Taoglas min ", ant_gnd_min, " from metal)"));
    assert(z_fl_lo_max - fxp_solder_h - (z_pcb_top + top_band_h) >= 0.3 - 1e-6,
        "Worst flex solder joint comes within 0.3 mm of the top_band_h parts under the flex");
    // flex-borne cable and solder joints clear of the mated plug (XY or Z)
    assert(ufl_xy[0] - ufl_plug_w / 2 - (x_ll + x_ex_tol + 1.25) >= 0.3
           || z_fl_lo_max - fxp_solder_h - (z_pcb_top + ufl_mated_h) >= 0.3,
        "Flex solder joints / cable on the flex run onto the mated U.FL plug");
    assert(lpk_x1 + 0.3 <= ufl_xy[0] - ufl_plug_w / 2 || l_ufl_z >= ufl_lid_clr - 1e-6,
        "Flex pocket lies over the mated U.FL with under ufl_lid_clr of air");
    // lid lip and beads
    for (s = snaps) {
        assert(s[0] != 0 || s[1] + snap_len / 2 + 1 <= top_cut[0] || s[1] - snap_len / 2 - 1 >= top_cut[1],
            str("Top-wall snap bead at x ", s[1], " is in the lid-lip cut over the flex pocket (x ",
                r2(top_cut[0]), " to ", r2(top_cut[1]), "); edit snap_top_x"));
        assert(s[0] != 1 || !notch_need || s[1] + snap_len / 2 + 1 <= notch_y[0] || s[1] - snap_len / 2 - 1 >= notch_y[1],
            str("Right-wall snap bead at y ", s[1], " is in the lid-lip notch over the cable (y ",
                r2(notch_y[0]), " to ", r2(notch_y[1]), "); edit snap_right_y"));
    }
    assert(len([for (s = snaps) if (s[0] == 0) 1]) >= 1 && len([for (s = snaps) if (s[0] == 1) 1]) >= 2,
        "Keep at least one top-wall and two right-wall snap beads");
    // cable route
    assert(hp_dz < 2 * hp_r - 0.5, "Hairpin legs are further apart in Z than the bend diameter");
    assert(l_cab_rx >= cable_rx_min - 1e-6,
        str("Lid-leg cable only ", r2(l_cab_rx), " mm from the RX patch (min ", cable_rx_min, ")"));
    assert(!use_patch || x_ll - x_ex_tol - rail_hw - rail_t >= win_x1 + 1.0 - 1e-6,
        "Clip rails come within 1 mm of the patch window");
    assert(x_bl + cable_d / 2 <= pcb_xr + 1e-6 && x_bl + cable_d / 2 <= cav_x - leg_wall_clr + 1e-6,
        "Board leg is off the board or against the wall");
    assert(jog_h > 0 && jog_h <= 2 * hp_r - 1e-6, "S-jog offset must be in (0, 2 hp_r]");
    assert(cable_lead >= 2 - 1e-6, "Straight lead behind the crimp under 2 mm");
    assert(clip_off >= 3 - 1e-6 && y_clip0 <= lpk_y0 - 0.5, "First clip within 3 mm of the flex edge or inside the pocket");
    assert(pow(clip_off, 2) / (4 * norm([x_ex_tol, z_cab_on - z_ll])) >= cable_bend_r - 1e-6,
        str("Free cable between the flex and the first clip bends tighter than ", cable_bend_r,
            " to take up the exit tolerance; raise clip_off"));
    assert(y_clip0 - rail_lo >= 3 - 1e-6,
        str("Clip rails only ", r2(y_clip0 - rail_lo), " mm long: cable too short for the hairpin (raise clip_off?)"));
    assert(y_j0 - y_u_hi >= lk_len + 1 - 1e-6,
        str("Board leg straight only ", r2(y_j0 - y_u_hi), " mm at the shortest cable"));
    assert(lkeepers[0][1] >= y_u_hi + 0.3 && lkeepers[0][3] <= y_j0 - 0.3, "Board-leg keeper is off the straight");
    for (k = lkeepers) {
        assert(k[4] < z_seam - 0.5, "Cable keeper shorter than 0.5 mm");
        assert(k[2] <= cav_x - 0.1, "Cable keeper runs into the right wall");
        assert(!use_patch || k[0] >= win_x1 + 1, "Cable keeper runs into the patch window");
        assert(k[2] <= lip_in - 0.3 || (notch_need && k[1] >= notch_y[0] && k[3] <= notch_y[1]),
            "Cable keeper runs into the lid lip");
    }
    assert(abs(lcab_chk - cable_free) <= 0.15, str("Cable path ", r2(lcab_chk), " != free length ", cable_free));
    assert(y_u_lo - hp_r - cable_d / 2 >= pcb_y0 + strip_y[0] + 0.3
           && fl_route[0][0] >= pcb_x0 + strip_x0 && y_crimp <= pcb_y0 + strip_y[1],
        str("Cable hairpin / board leg leave the part-free strip (board x >= ", strip_x0, ", y ", strip_y, ")"));
    assert(!notch_need || (notch_y[0] >= side_run(1)[0] && notch_y[1] <= side_run(1)[1]),
        "Right-wall lip notch runs onto a corner radius");
    assert(!notch_need || notch_y[1] <= y_j0 + jog_run && notch_y[0] <= y_u_lo - hp_r,
        "Right-wall lip notch does not cover the board leg / hairpin");
    for (i = [0 : len(holes) - 1])
        assert(rect_dist(holes[i], fl_route[0], fl_route[1]) >= screw_head_d / 2 + 0.3,
            str("TX cable runs over the screw head at board hole ", holes_pcb[i]));
    assert(!vent_slots || !rects_hit(vent_a, vent_b, [lpk_x0, lpk_y0], [lpk_x1, lpk_y1], 1),
        "Vent slots cut into the lid flex pocket; move vent_c (the default [22, 65] lies under the flex)");
    assert(!vent_slots || !rects_hit(vent_a, vent_b, fl_route[0], [x_bl, ufl_xy[1] + ufl_plug_w / 2], vent_keep),
        str("Vent slots within ", vent_keep, " mm of the U.FL / TX cable; move vent_c"));
}
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
