Matthew-Marsicano/BEACON_PhoneModule/(list of files, cad)

Other CAD files:
enclosure/lowprofile_print_plate.stl
enclosure/beacon_phone_magsafe_lowprofile.scad
enclosure/beacon_phone_magsafe_lowprofile_fxp70.scad
enclosure/beacon_phone_magsafe_round.scad
