Matthew-Marsicano/BEACON_PhoneModule/enclosure/fxp70_assembly.png

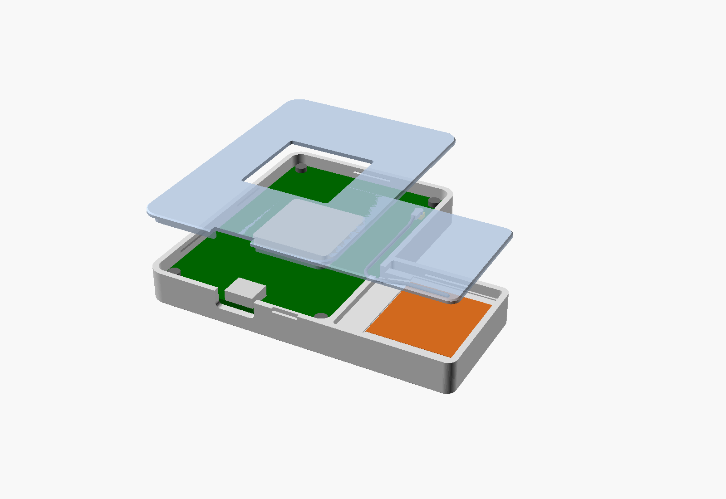
enclosure/fxp70_assembly.png
