Matthew-Marsicano/BEACON_PhoneModule/enclosure/fxp70_lid_print.png

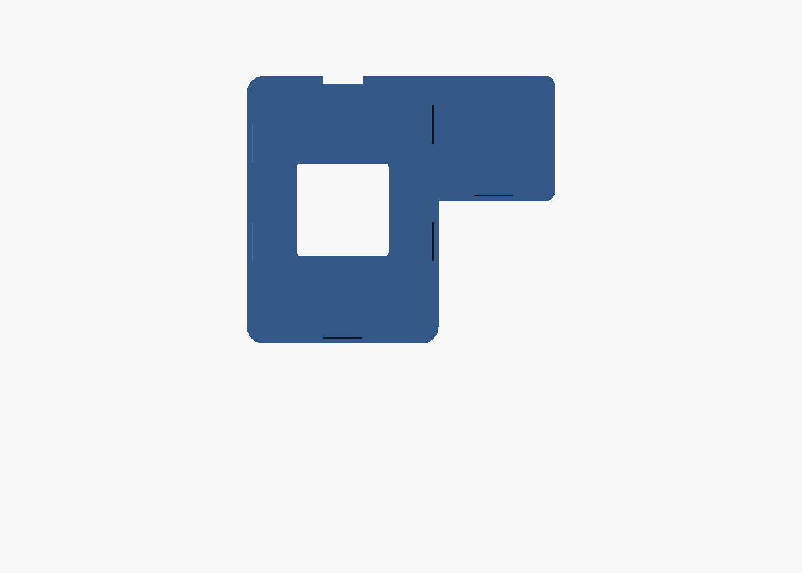
enclosure/fxp70_lid_print.png
