Matthew-Marsicano/BEACON_PhoneModule/enclosure/inlid_assembly.png

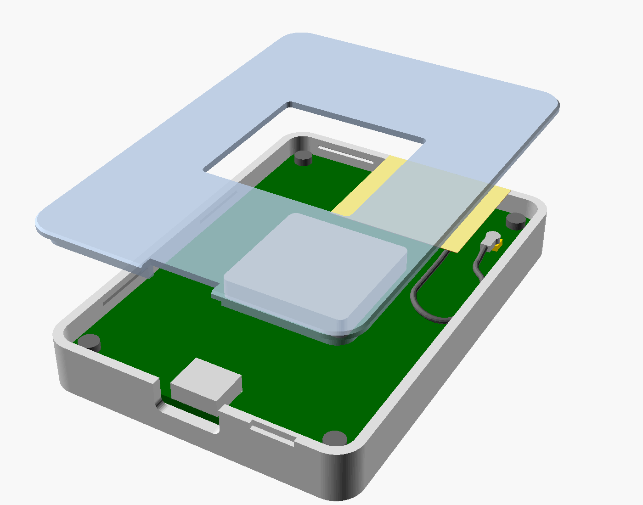
enclosure/inlid_assembly.png
