Matthew-Marsicano/BEACON_PhoneModule/enclosure/lowprofile_assembly.png

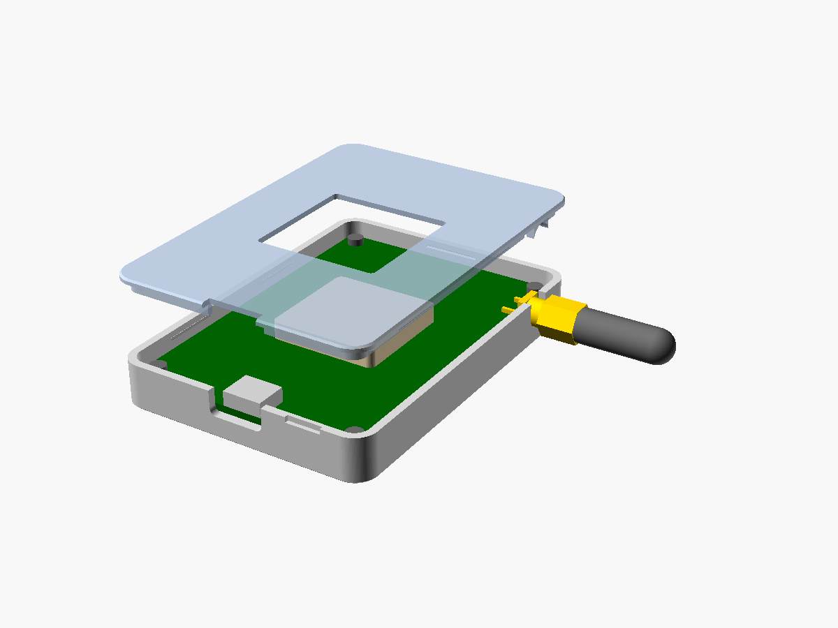
enclosure/lowprofile_assembly.png
