Matthew-Marsicano/BEACON_PhoneModule/enclosure/lowprofile_lid_print.png

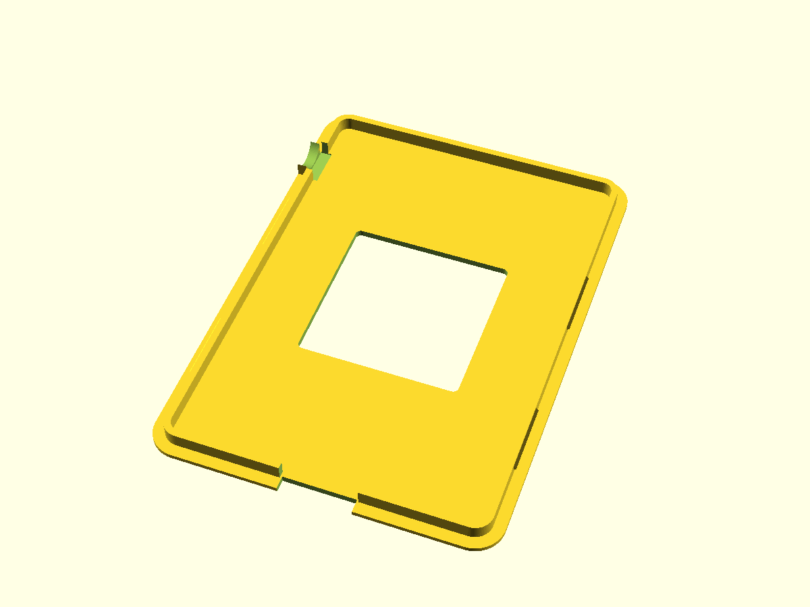
enclosure/lowprofile_lid_print.png
