Matthew-Marsicano/BEACON_PhoneModule/enclosure/rev_pcb_assembly.png

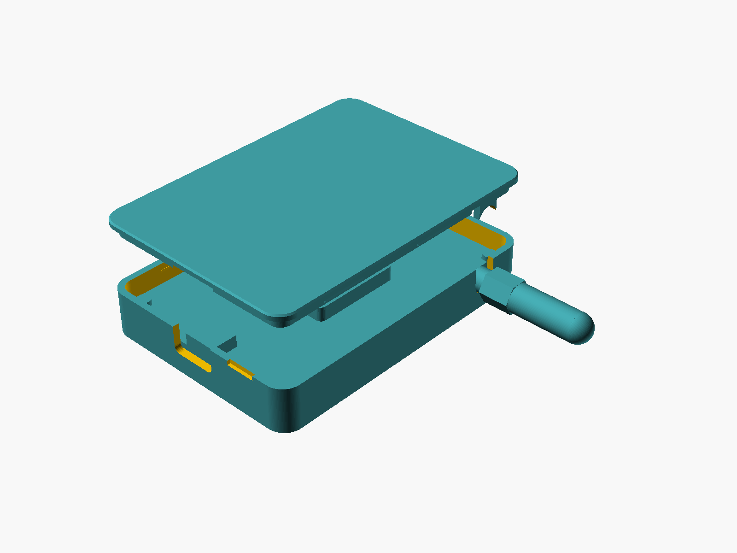
enclosure/rev_pcb_assembly.png
