Matthew-Marsicano/BEACON_PhoneModule/enclosure/round_assembly.png

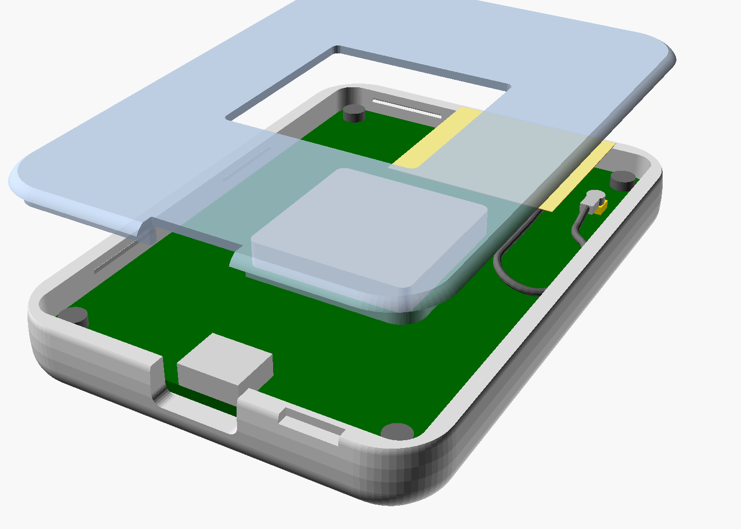
enclosure/round_assembly.png
