Matthew-Marsicano/BEACON_PhoneModule/fab/BEACON_PhoneModule_assembly_top.pdf

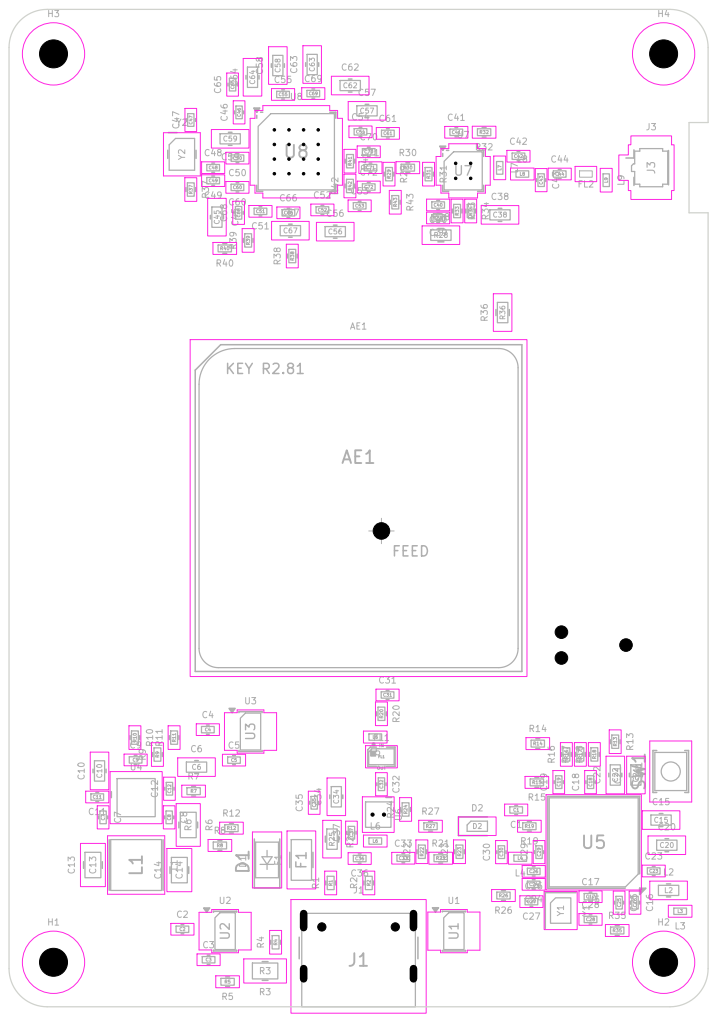
[picture p64: page 1]
