Matthew-Marsicano/BEACON_PhoneModule/BEACON_PhoneModule.kicad_pcb

## KiCad design BEACON_PhoneModule.kicad_pcb (2026-11-03)

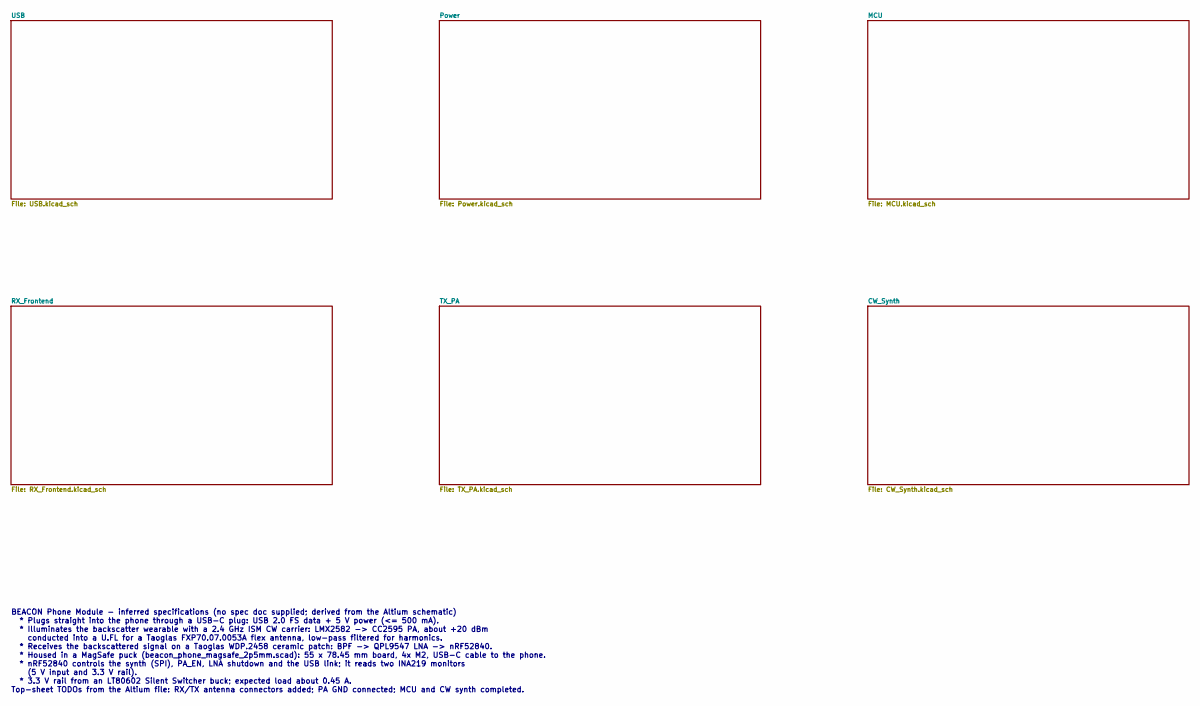
[picture p65: schematic BEACON_PhoneModule.kicad_sch, BEACON Phone Module]

Notes on the sheet:
BEACON Phone Module - inferred specifications (no spec doc supplied; derived from the Altium schematic) * Plugs straight into the phone through a USB-C plug: USB 2.0 FS data + 5 V power (<= 500 mA). * Illuminates the backscatter wearable with a 2.4 GHz ISM CW carrier: LMX2582 -> CC2595 PA, about +2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

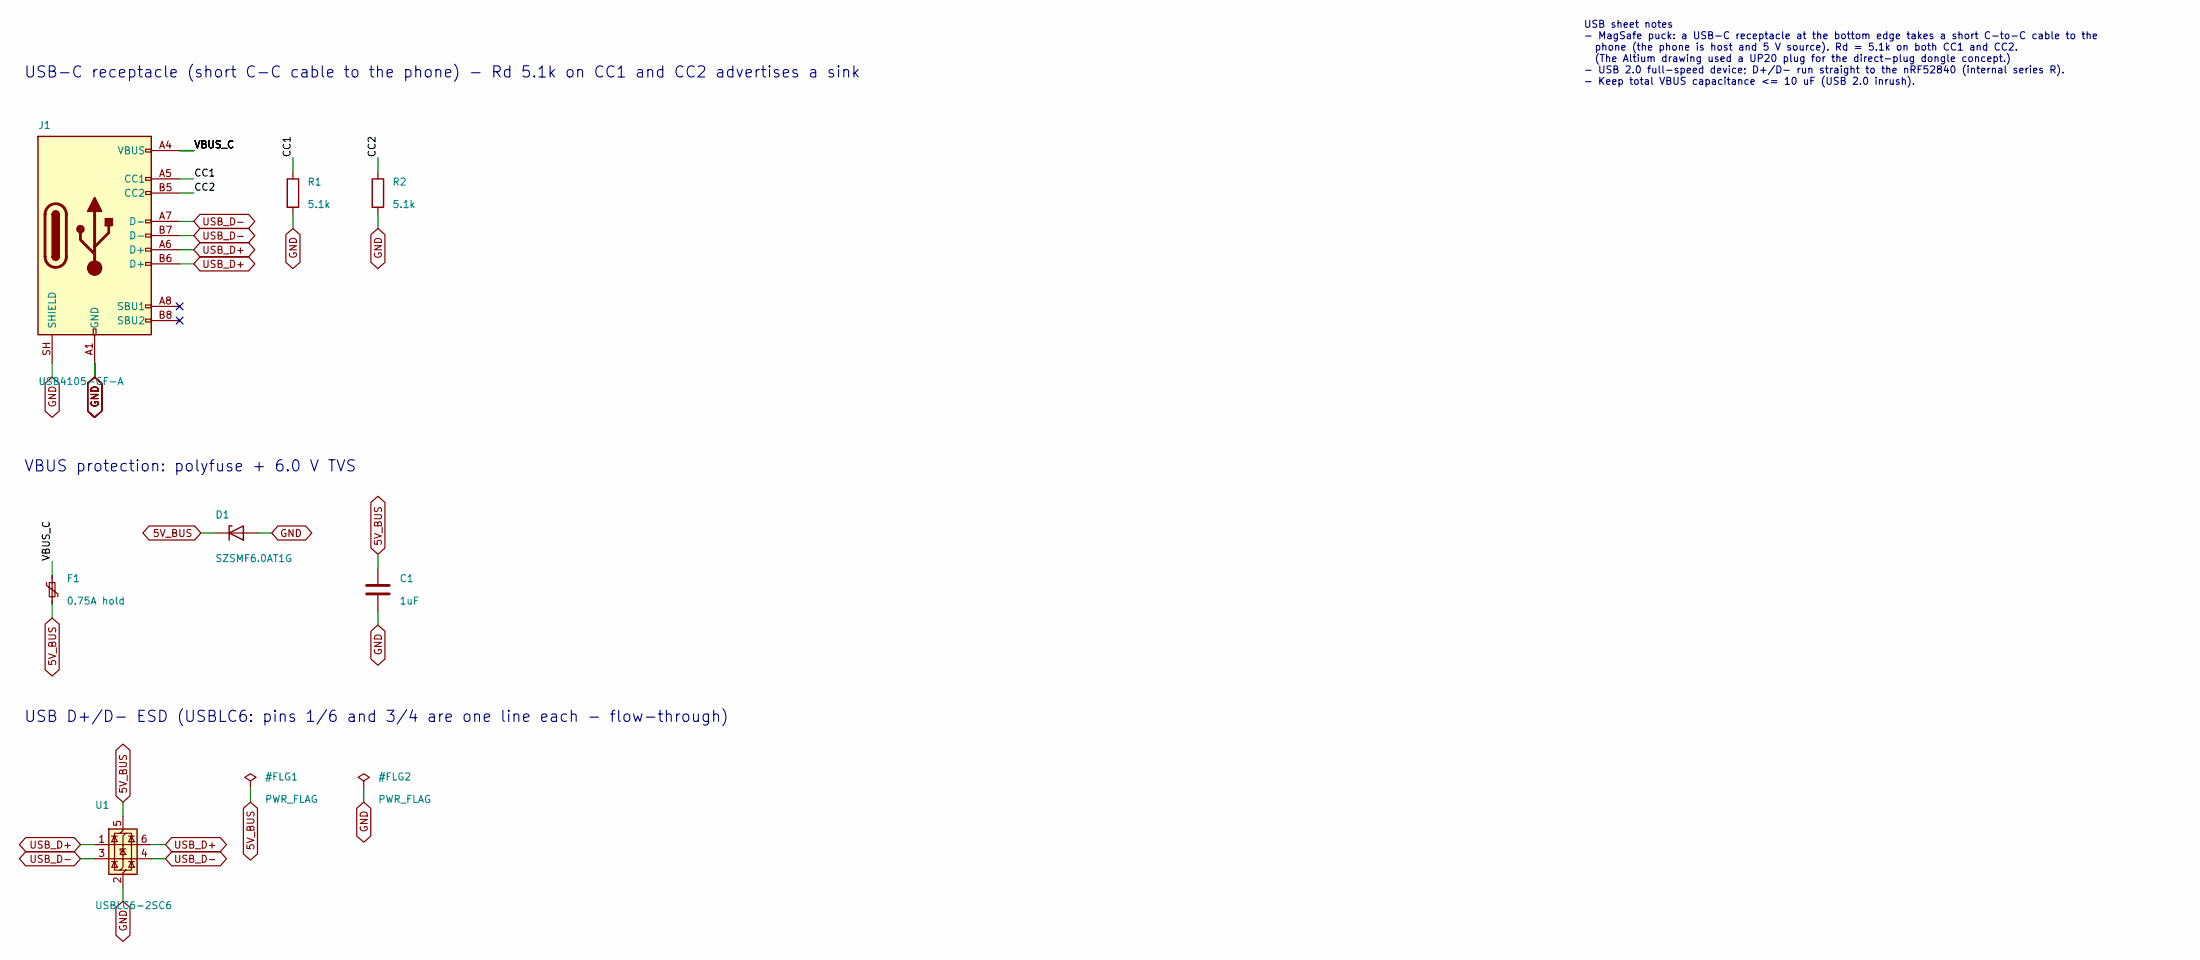
[picture p66: schematic USB.kicad_sch, USB-C receptacle, VBUS protection and ESD]

Parts:
C1: 1uF; C1_C_0402_1005Metric
D1: SZSMF6.0AT1G; D1_D_SOD-123F; MPN SZSMF6.0AT1G
F1: 0.75A hold; F1_Fuse_1206_3216Metric; MPN NANOSMDC075F-2
J1: USB4105-GF-A; J1_USB_C_Receptacle_GCT_USB4105-xx-A_16P_TopMnt_Horizontal; MPN USB4105-GF-A
R1: 5.1k; R1_R_0402_1005Metric
R2: 5.1k; R2_R_0402_1005Metric
U1: USBLC6-2SC6; U1_SOT-23-6; MPN USBLC6-2SC6

Connections:
5V_BUS: C1.1, D1.1 (K), F1.2, U1.5 (VBUS); also elsewhere on the board
/USB/CC1: J1.A5 (CC1), R1.1
/USB/CC2: J1.B5 (CC2), R2.1
/USB/VBUS_C: F1.1, J1.A4 (VBUS), J1.A9 (VBUS), J1.B4 (VBUS), J1.B9 (VBUS)
GND: C1.2, D1.2 (A), J1.A1 (GND), J1.A12 (GND), J1.B1 (GND), J1.B12 (GND), J1.SH (SHIELD), R1.2, R2.2, U1.2 (GND); also elsewhere on the board
USB_D+: J1.A6 (D+), J1.B6 (D+), U1.1 (I/O1), U1.6 (I/O1); also elsewhere on the board
USB_D-: J1.A7 (D-), J1.B7 (D-), U1.3 (I/O2), U1.4 (I/O2); also elsewhere on the board

Notes on the sheet:
USB-C receptacle (short C-C cable to the phone) - Rd 5.1k on CC1 and CC2 advertises a sink
VBUS protection: polyfuse + 6.0 V TVS
USB D+/D- ESD (USBLC6: pins 1/6 and 3/4 are one line each - flow-through)
USB sheet notes - MagSafe puck: a USB-C receptacle at the bottom edge takes a short C-to-C cable to the phone (the phone is host and 5 V source). Rd = 5.1k on both CC1 and CC2. (The Altium drawing used a UP20 plug for the direct-plug dongle concept.) - USB 2.0 full-speed device; D+/D- run straight 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

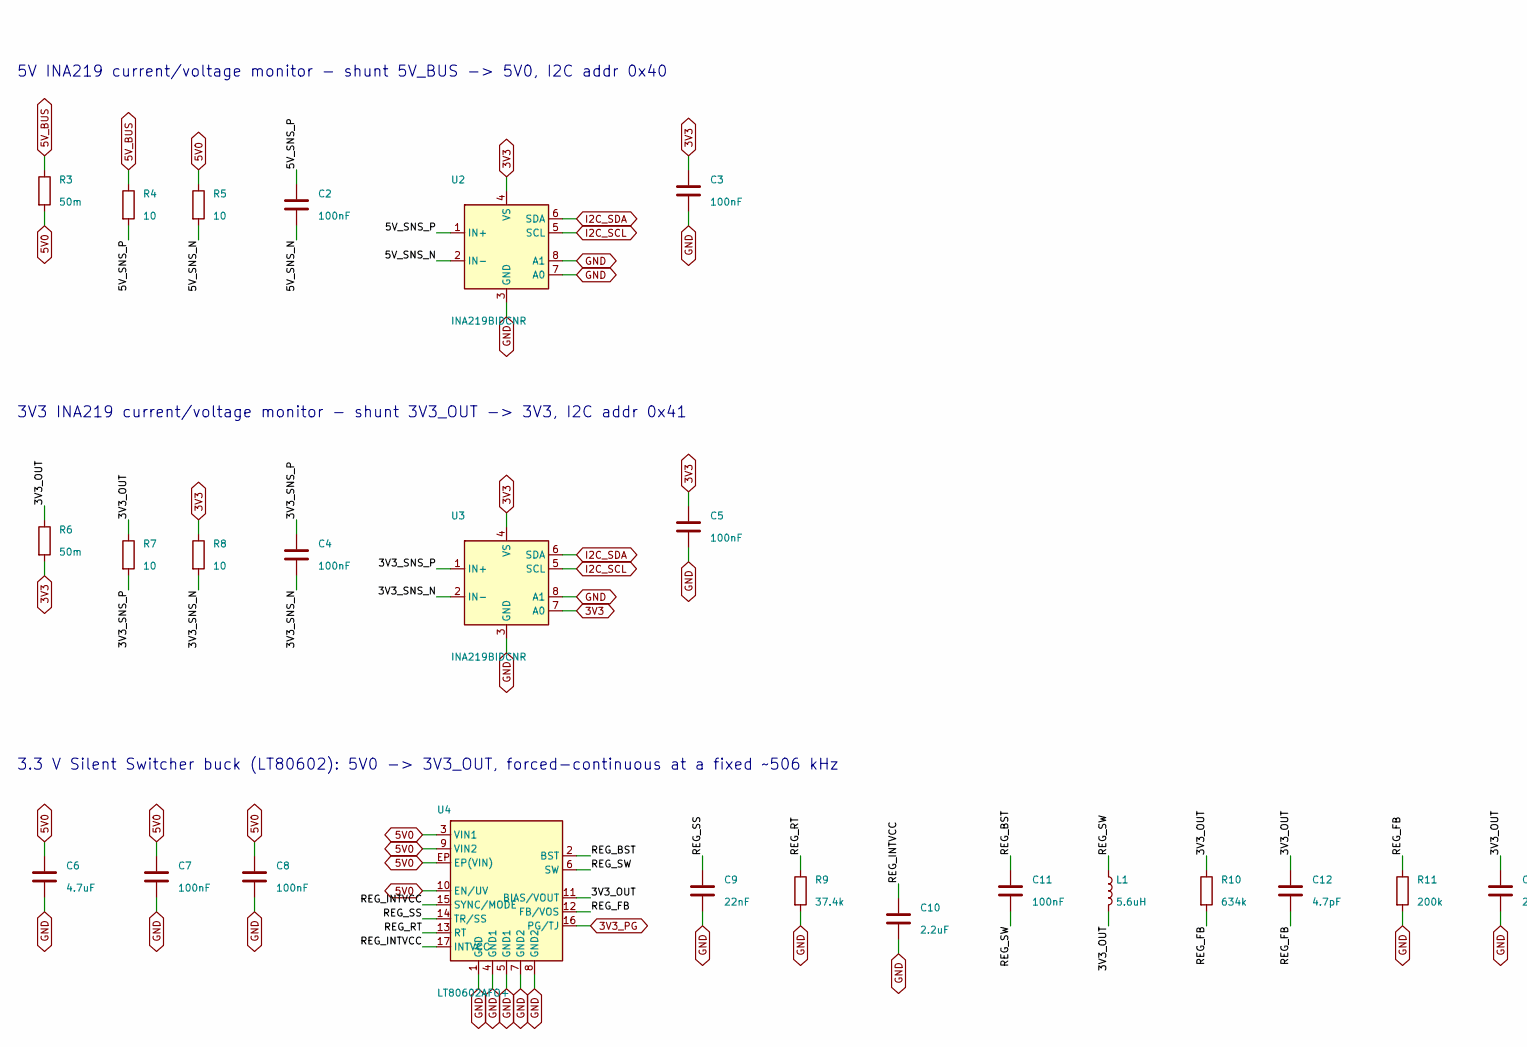
[picture p67: schematic Power.kicad_sch, Power: current monitors and 3.3 V buck, part in row 1, column 1]

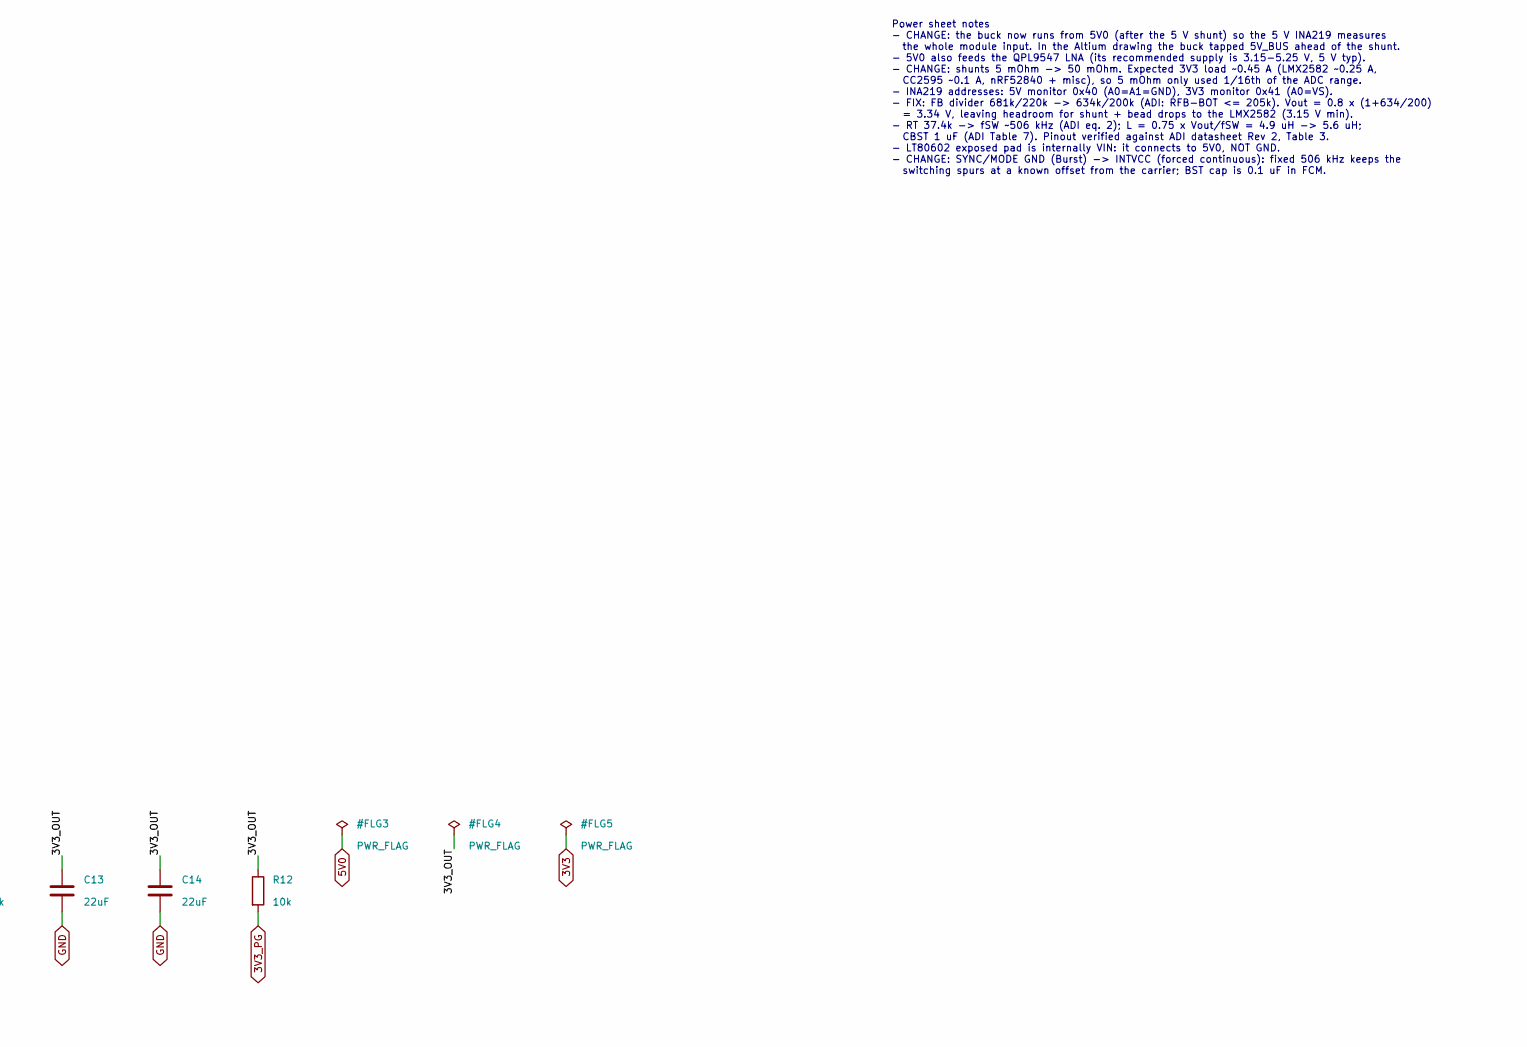
[picture p68: schematic Power.kicad_sch, Power: current monitors and 3.3 V buck, part in row 1, column 2]

Parts:
C2: 100nF; C2_C_0402_1005Metric
C3: 100nF; C3_C_0402_1005Metric
C4: 100nF; C4_C_0402_1005Metric
C5: 100nF; C5_C_0402_1005Metric
C6: 4.7uF; C6_C_0603_1608Metric
C7: 100nF; C7_C_0402_1005Metric
C8: 100nF; C8_C_0402_1005Metric
C9: 22nF; C9_C_0402_1005Metric
C10: 2.2uF; C10_C_0603_1608Metric
C11: 100nF; C11_C_0402_1005Metric
C12: 4.7pF; C12_C_0402_1005Metric
C13: 22uF; C13_C_0805_2012Metric
C14: 22uF; C14_C_0805_2012Metric
L1: 5.6uH; L1_L_Abracon_ASPI-4030S; MPN ASPI-4030S-5R6M-T; LCSC C5224561
R3: 50m; R3_R_0805_2012Metric; Tolerance 1%; MPN ERJ-6BWFR050V
R4: 10; R4_R_0402_1005Metric
R5: 10; R5_R_0402_1005Metric
R6: 50m; R6_R_0805_2012Metric; Tolerance 1%; MPN ERJ-6BWFR050V
R7: 10; R7_R_0402_1005Metric
R8: 10; R8_R_0402_1005Metric
R9: 37.4k; R9_R_0402_1005Metric
R10: 634k; R10_R_0402_1005Metric
R11: 200k; R11_R_0402_1005Metric
R12: 10k; R12_R_0402_1005Metric
U2: INA219BIDCNR; U2_SOT-23-8; MPN INA219BIDCNR
U3: INA219BIDCNR; U3_SOT-23-8; MPN INA219BIDCNR
U4: LT80602AFO+; U4_ADI_FC2QFN-17-1EP_3x3mm_LT80602; MPN LT80602AFO+; LCSC C54448890

Connections:
3V3: C3.1, C5.1, R6.2, R8.1, U2.4 (VS), U3.4 (VS), U3.7 (A0); also elsewhere on the board
3V3_PG: R12.2, U4.16 (PG/TJ); also elsewhere on the board
5V0: C6.1, C7.1, C8.1, R3.2, R5.1, U4.3 (VIN1), U4.9 (VIN2), U4.10 (EN/UV), U4.EP (EP(VIN)); also elsewhere on the board
5V_BUS: R3.1, R4.1; also elsewhere on the board
/Power/3V3_OUT: C12.1, C13.1, C14.1, L1.2, R6.1, R7.1, R10.1, R12.1, U4.11 (BIAS/VOUT)
/Power/3V3_SNS_N: C4.2, R8.2, U3.2 (IN-)
/Power/3V3_SNS_P: C4.1, R7.2, U3.1 (IN+)
/Power/5V_SNS_N: C2.2, R5.2, U2.2 (IN-)
/Power/5V_SNS_P: C2.1, R4.2, U2.1 (IN+)
/Power/REG_BST: C11.1, U4.2 (BST)
/Power/REG_FB: C12.2, R10.2, R11.1, U4.12 (FB/VOS)
/Power/REG_INTVCC: C10.1, U4.15 (SYNC/MODE), U4.17 (INTVCC)
/Power/REG_RT: R9.1, U4.13 (RT)
/Power/REG_SS: C9.1, U4.14 (TR/SS)
/Power/REG_SW: C11.2, L1.1, U4.6 (SW)
GND: C3.2, C5.2, C6.2, C7.2, C8.2, C9.2, C10.2, C13.2, C14.2, R9.2, R11.2, U2.3 (GND), U2.7 (A0), U2.8 (A1), U3.3 (GND), U3.8 (A1), U4.1 (GND), U4.4 (GND1), U4.5 (GND1), U4.7 (GND2), U4.8 (GND2); also elsewhere on the board
I2C_SCL: U2.5 (SCL), U3.5 (SCL); also elsewhere on the board
I2C_SDA: U2.6 (SDA), U3.6 (SDA); also elsewhere on the board

Notes on the sheet:
5V INA219 current/voltage monitor - shunt 5V_BUS -> 5V0, I2C addr 0x40
3V3 INA219 current/voltage monitor - shunt 3V3_OUT -> 3V3, I2C addr 0x41
3.3 V Silent Switcher buck (LT80602): 5V0 -> 3V3_OUT, forced-continuous at a fixed ~506 kHz
Power sheet notes - CHANGE: the buck now runs from 5V0 (after the 5 V shunt) so the 5 V INA219 measures the whole module input. In the Altium drawing the buck tapped 5V_BUS ahead of the shunt. - 5V0 also feeds the QPL9547 LNA (its recommended supply is 3.15-5.25 V, 5 V typ). - CHANGE: shunts 5 mOhm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

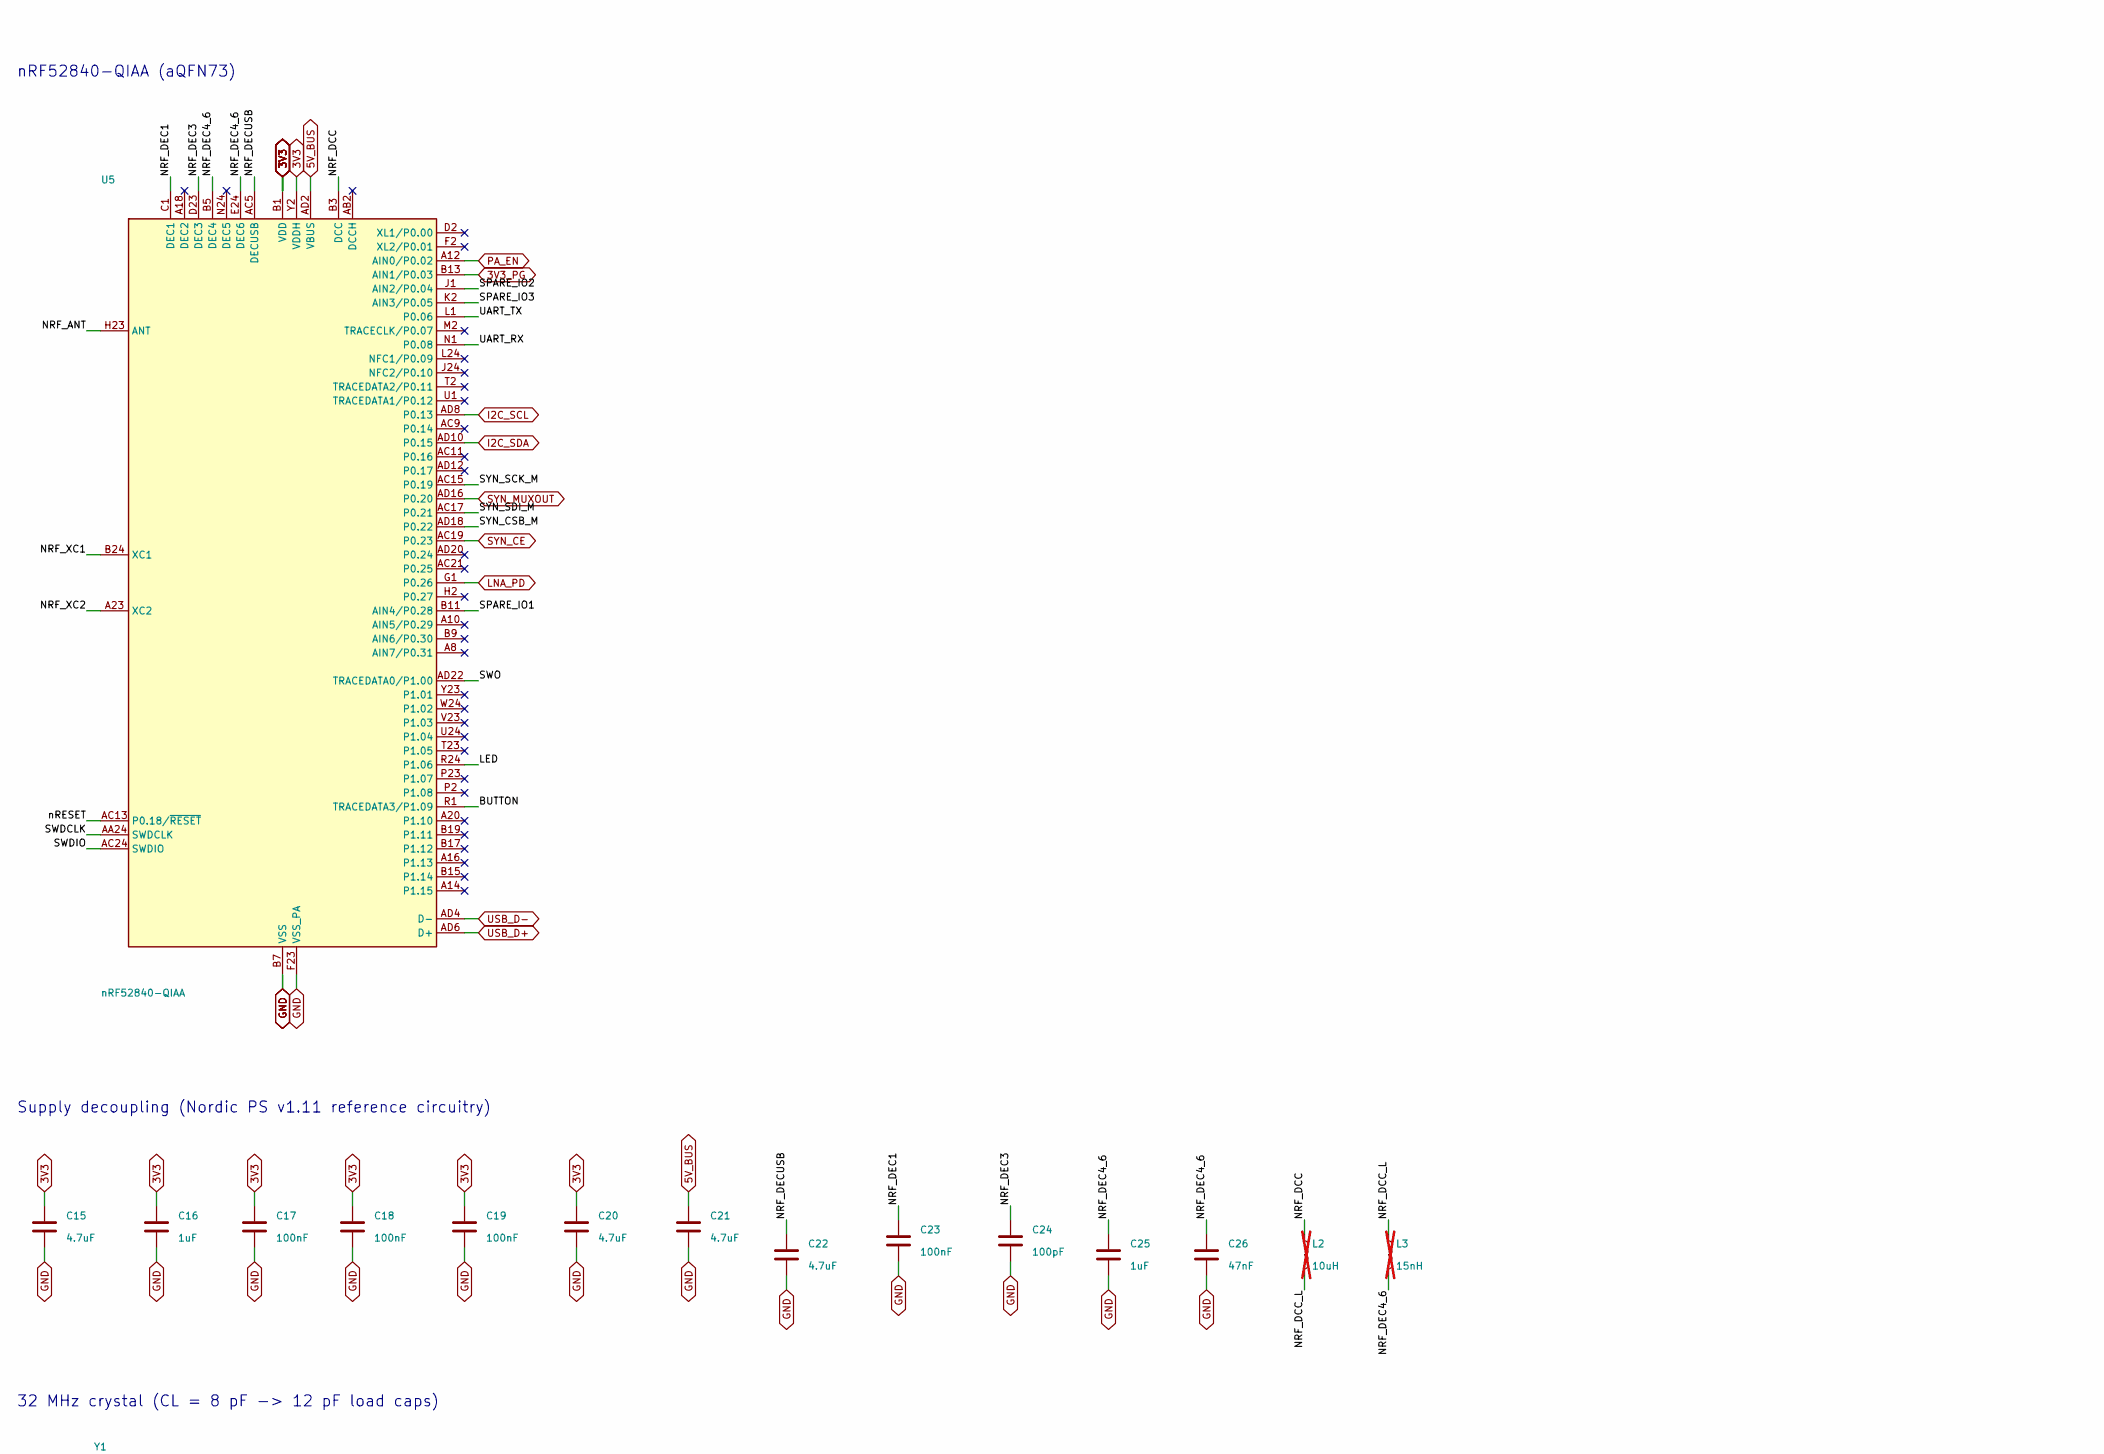
[picture p69: schematic MCU.kicad_sch, nRF52840 MCU / BLE receiver, debug, UI, part in row 1, column 1]

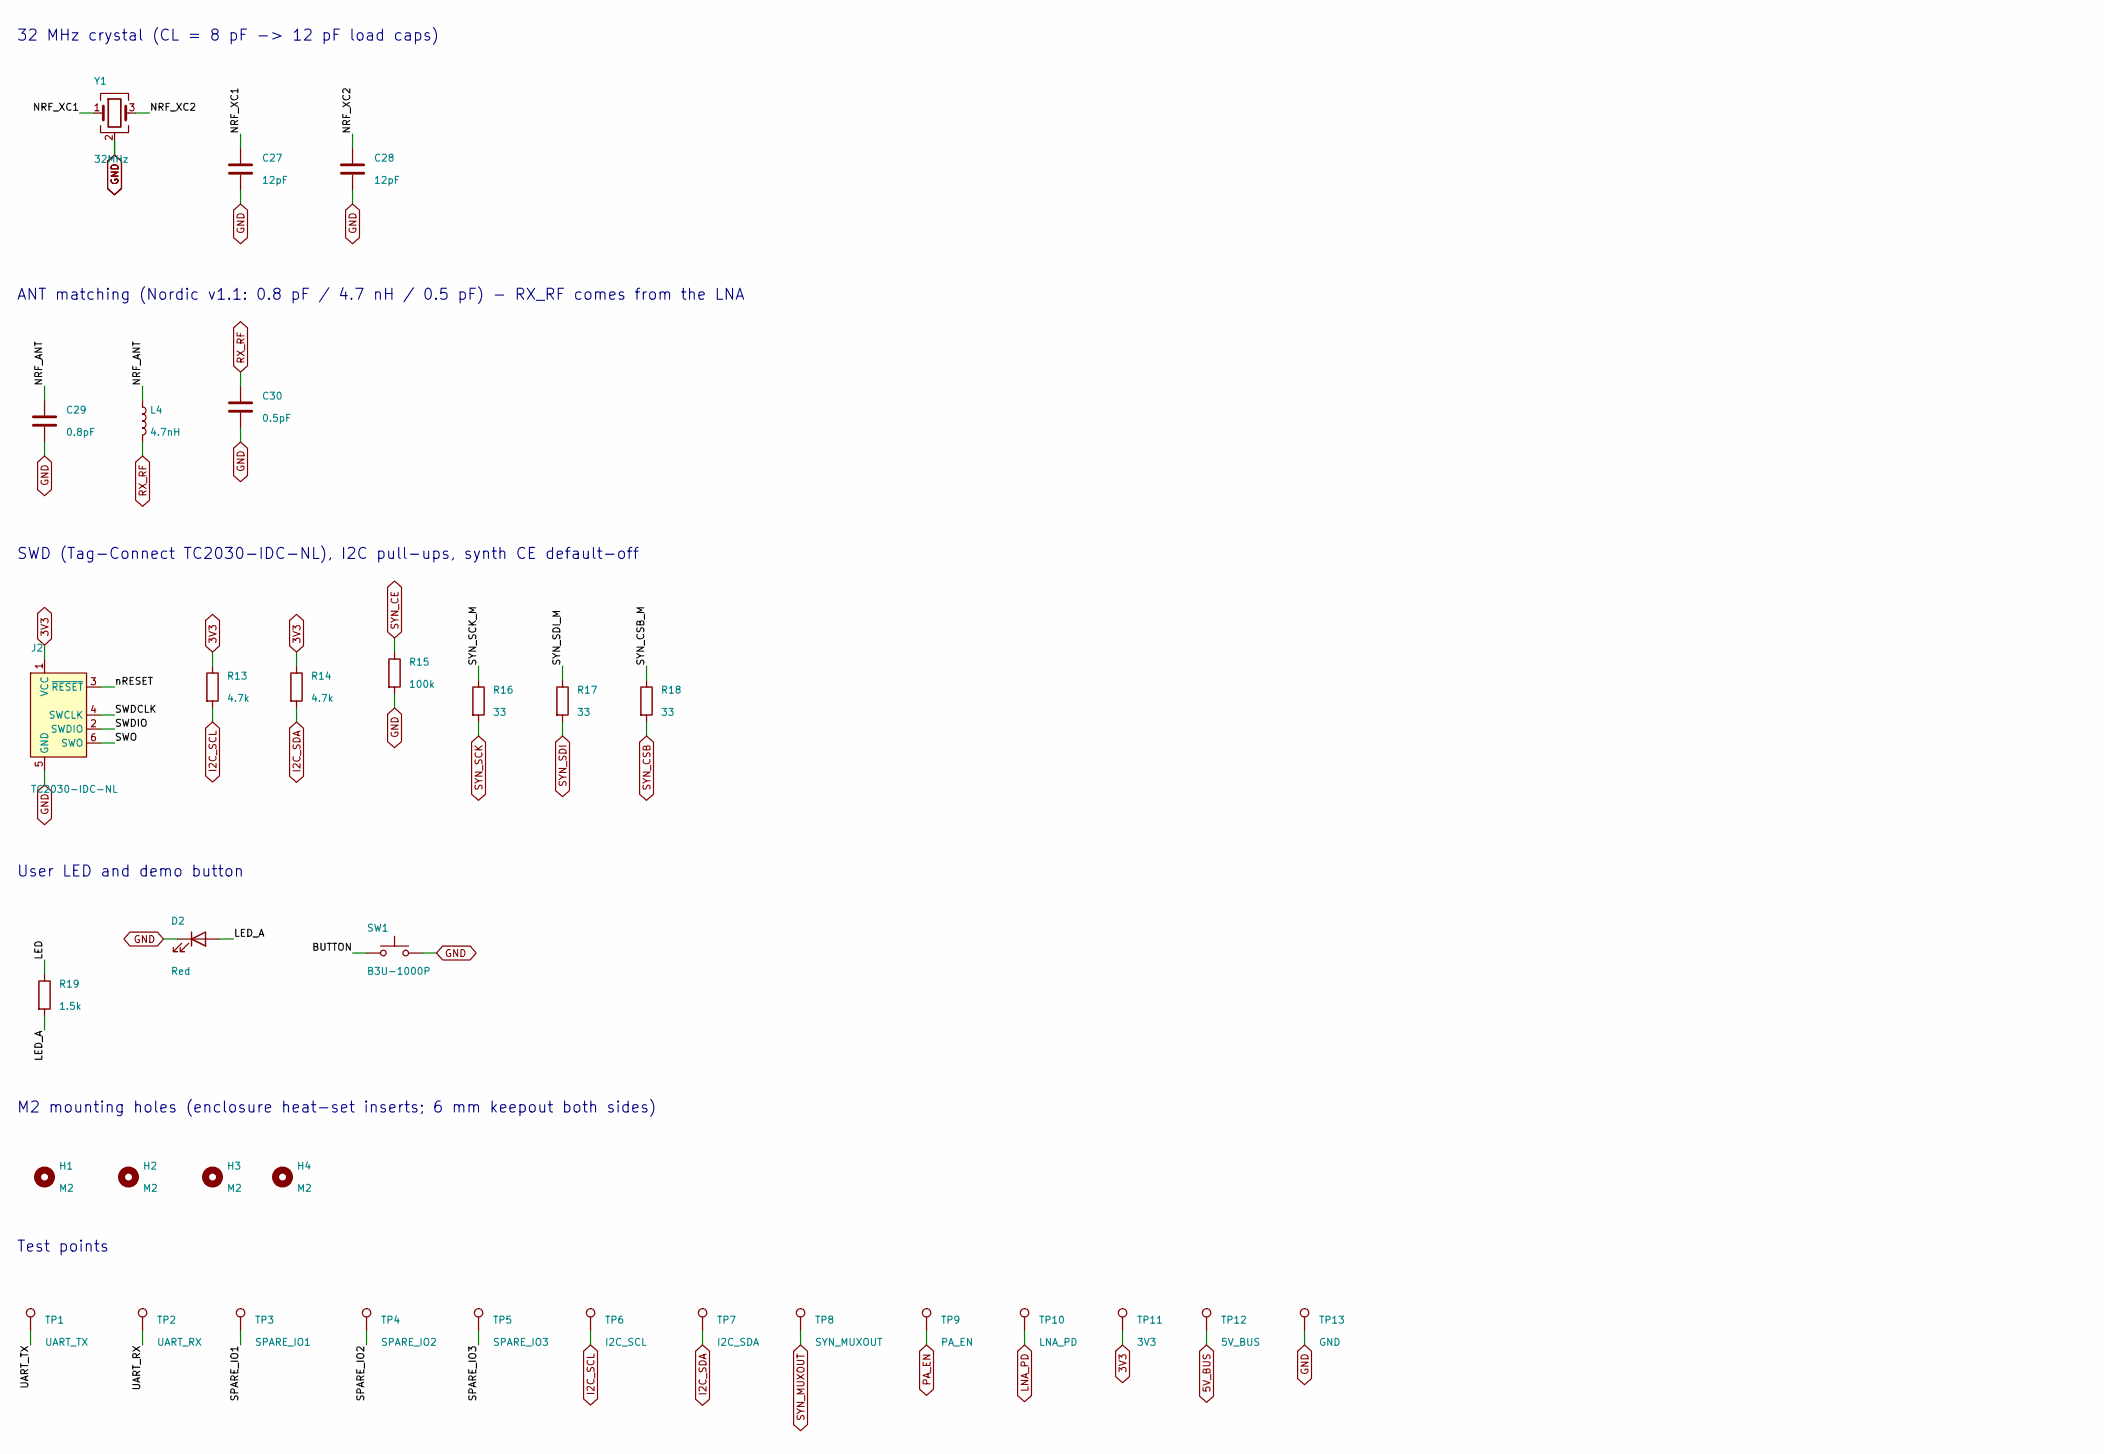
[picture p70: schematic MCU.kicad_sch, nRF52840 MCU / BLE receiver, debug, UI, part in row 2, column 1]

Parts:
C15: 4.7uF; C15_C_0603_1608Metric
C16: 1uF; C16_C_0402_1005Metric
C17: 100nF; C17_C_0402_1005Metric
C18: 100nF; C18_C_0402_1005Metric
C19: 100nF; C19_C_0402_1005Metric
C20: 4.7uF; C20_C_0603_1608Metric
C21: 4.7uF; C21_C_0603_1608Metric
C22: 4.7uF; C22_C_0603_1608Metric
C23: 100nF; C23_C_0402_1005Metric
C24: 100pF; C24_C_0402_1005Metric
C25: 1uF; C25_C_0402_1005Metric
C26: 47nF; C26_C_0402_1005Metric
C27: 12pF; C27_C_0402_1005Metric
C28: 12pF; C28_C_0402_1005Metric
C29: 0.8pF; C29_C_0402_1005Metric; MPN GJM1555C1HR80BB01D
C30: 0.5pF; C30_C_0402_1005Metric; MPN GJM1555C1HR50BB01D
D2: Red; D2_LED_0603_1608Metric; MPN KT-0603R
H1: M2; H1_MountingHole_2.2mm_M2
H2: M2; H2_MountingHole_2.2mm_M2
H3: M2; H3_MountingHole_2.2mm_M2
H4: M2; H4_MountingHole_2.2mm_M2
J2: TC2030-IDC-NL; J2_Tag-Connect_TC2030-IDC-NL_2x03_P1.27mm_Vertical
L2: 10uH; L2_L_0603_1608Metric; MPN LQM18PN100MFRL; not fitted
L3: 15nH; L3_L_0402_1005Metric; MPN LQG15HS15NJ02D; not fitted
L4: 4.7nH; L4_L_0402_1005Metric; MPN LQG15HS4N7B02D; LCSC C162543
R13: 4.7k; R13_R_0402_1005Metric
R14: 4.7k; R14_R_0402_1005Metric
R15: 100k; R15_R_0402_1005Metric
R16: 33; R16_R_0402_1005Metric
R17: 33; R17_R_0402_1005Metric
R18: 33; R18_R_0402_1005Metric
R19: 1.5k; R19_R_0402_1005Metric
SW1: B3U-1000P; SW1_SW_SPST_B3U-1000P; MPN B3U-1000P
TP1: UART_TX; TP1_TestPoint_Pad_D1.0mm
TP2: UART_RX; TP2_TestPoint_Pad_D1.0mm
TP3: SPARE_IO1; TP3_TestPoint_Pad_D1.0mm
TP4: SPARE_IO2; TP4_TestPoint_Pad_D1.0mm
TP5: SPARE_IO3; TP5_TestPoint_Pad_D1.0mm
TP6: I2C_SCL; TP6_TestPoint_Pad_D1.0mm
TP7: I2C_SDA; TP7_TestPoint_Pad_D1.0mm
TP8: SYN_MUXOUT; TP8_TestPoint_Pad_D1.0mm
TP9: PA_EN; TP9_TestPoint_Pad_D1.0mm
TP10: LNA_PD; TP10_TestPoint_Pad_D1.0mm
TP11: 3V3; TP11_TestPoint_Pad_D1.0mm
TP12: 5V_BUS; TP12_TestPoint_Pad_D1.0mm
TP13: GND; TP13_TestPoint_Pad_D1.0mm
U5: nRF52840-QIAA; U5_Nordic_AQFN-73-1EP_7x7mm_P0.5mm; MPN NRF52840-QIAA-R
Y1: 32MHz; Y1_Crystal_SMD_2016-4Pin_2.0x1.6mm; MPN ABM11W-32.0000MHZ-8-B1U-T3

Connections:
3V3: C15.1, C16.1, C17.1, C18.1, C19.1, C20.1, J2.1 (VCC), R13.1, R14.1, TP11.1, U5.A22 (VDD), U5.AD14 (VDD), U5.AD23 (VDD), U5.B1 (VDD), U5.W1 (VDD), U5.Y2 (VDDH); also elsewhere on the board
3V3_PG: U5.B13 (AIN1/P0.03); also elsewhere on the board
5V_BUS: C21.1, TP12.1, U5.AD2 (VBUS); also elsewhere on the board
/MCU/BUTTON: SW1.1, U5.R1 (TRACEDATA3/P1.09)
/MCU/LED: R19.1, U5.R24 (P1.06)
/MCU/LED_A: D2.2 (A), R19.2
/MCU/NRF_ANT: C29.1, L4.1, U5.H23 (ANT)
/MCU/NRF_DCC: L2.1, U5.B3 (DCC)
/MCU/NRF_DCC_L: L2.2, L3.1
/MCU/NRF_DEC1: C23.1, U5.C1 (DEC1)
/MCU/NRF_DEC3: C24.1, U5.D23 (DEC3)
/MCU/NRF_DEC4_6: C25.1, C26.1, L3.2, U5.B5 (DEC4), U5.E24 (DEC6)
/MCU/NRF_DECUSB: C22.1, U5.AC5 (DECUSB)
/MCU/NRF_XC1: C27.1, U5.B24 (XC1), Y1.1
/MCU/NRF_XC2: C28.1, U5.A23 (XC2), Y1.3
/MCU/SPARE_IO1: TP3.1, U5.B11 (AIN4/P0.28)
/MCU/SPARE_IO2: TP4.1, U5.J1 (AIN2/P0.04)
/MCU/SPARE_IO3: TP5.1, U5.K2 (AIN3/P0.05)
/MCU/SWDCLK: J2.4 (SWCLK), U5.AA24 (SWDCLK)
/MCU/SWDIO: J2.2 (SWDIO), U5.AC24 (SWDIO)
/MCU/SWO: J2.6 (SWO), U5.AD22 (TRACEDATA0/P1.00)
/MCU/SYN_CSB_M: R18.1, U5.AD18 (P0.22)
/MCU/SYN_SCK_M: R16.1, U5.AC15 (P0.19)
/MCU/SYN_SDI_M: R17.1, U5.AC17 (P0.21)
/MCU/UART_RX: TP2.1, U5.N1 (P0.08)
/MCU/UART_TX: TP1.1, U5.L1 (P0.06)
/MCU/nRESET: J2.3 (~RESET), U5.AC13 (P0.18/~RESET)
GND: C15.2, C16.2, C17.2, C18.2, C19.2, C20.2, C21.2, C22.2, C23.2, C24.2, C25.2, C26.2, C27.2, C28.2, C29.2, C30.2, D2.1 (K), J2.5 (GND), R15.2, SW1.2, TP13.1, U5.B7 (VSS), U5.EP (VSS), U5.F23 (VSS_PA), Y1.2 (G), Y1.4 (G); also elsewhere on the board
I2C_SCL: R13.2, TP6.1, U5.AD8 (P0.13); also elsewhere on the board
I2C_SDA: R14.2, TP7.1, U5.AD10 (P0.15); also elsewhere on the board
LNA_PD: TP10.1, U5.G1 (P0.26); also elsewhere on the board
PA_EN: TP9.1, U5.A12 (AIN0/P0.02); also elsewhere on the board
RX_RF: C30.1, L4.2; also elsewhere on the board
SYN_CE: R15.1, U5.AC19 (P0.23); also elsewhere on the board
SYN_CSB: R18.2; also elsewhere on the board
SYN_MUXOUT: TP8.1, U5.AD16 (P0.20); also elsewhere on the board
SYN_SCK: R16.2; also elsewhere on the board
SYN_SDI: R17.2; also elsewhere on the board
USB_D+: U5.AD6 (D+); also elsewhere on the board
USB_D-: U5.AD4 (D-); also elsewhere on the board

Notes on the sheet:
nRF52840-QIAA (aQFN73)
Supply decoupling (Nordic PS v1.11 reference circuitry)
32 MHz crystal (CL = 8 pF -> 12 pF load caps)
ANT matching (Nordic v1.1: 0.8 pF / 4.7 nH / 0.5 pF) - RX_RF comes from the LNA
SWD (Tag-Connect TC2030-IDC-NL), I2C pull-ups, synth CE default-off
User LED and demo button
M2 mounting holes (enclosure heat-set inserts; 6 mm keepout both sides)
Test points
MCU sheet notes - Supply: VDD and VDDH both on 3V3 (normal-voltage mode); DCCH unused. REG1 runs in LDO mode (firmware DCDCEN=0): the 10 uH ferrite would saturate in the MagSafe magnet field, so the DC/DC inductors are DNP footprints. VBUS from USB for the USBD peripheral. - Removed wearable-only n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

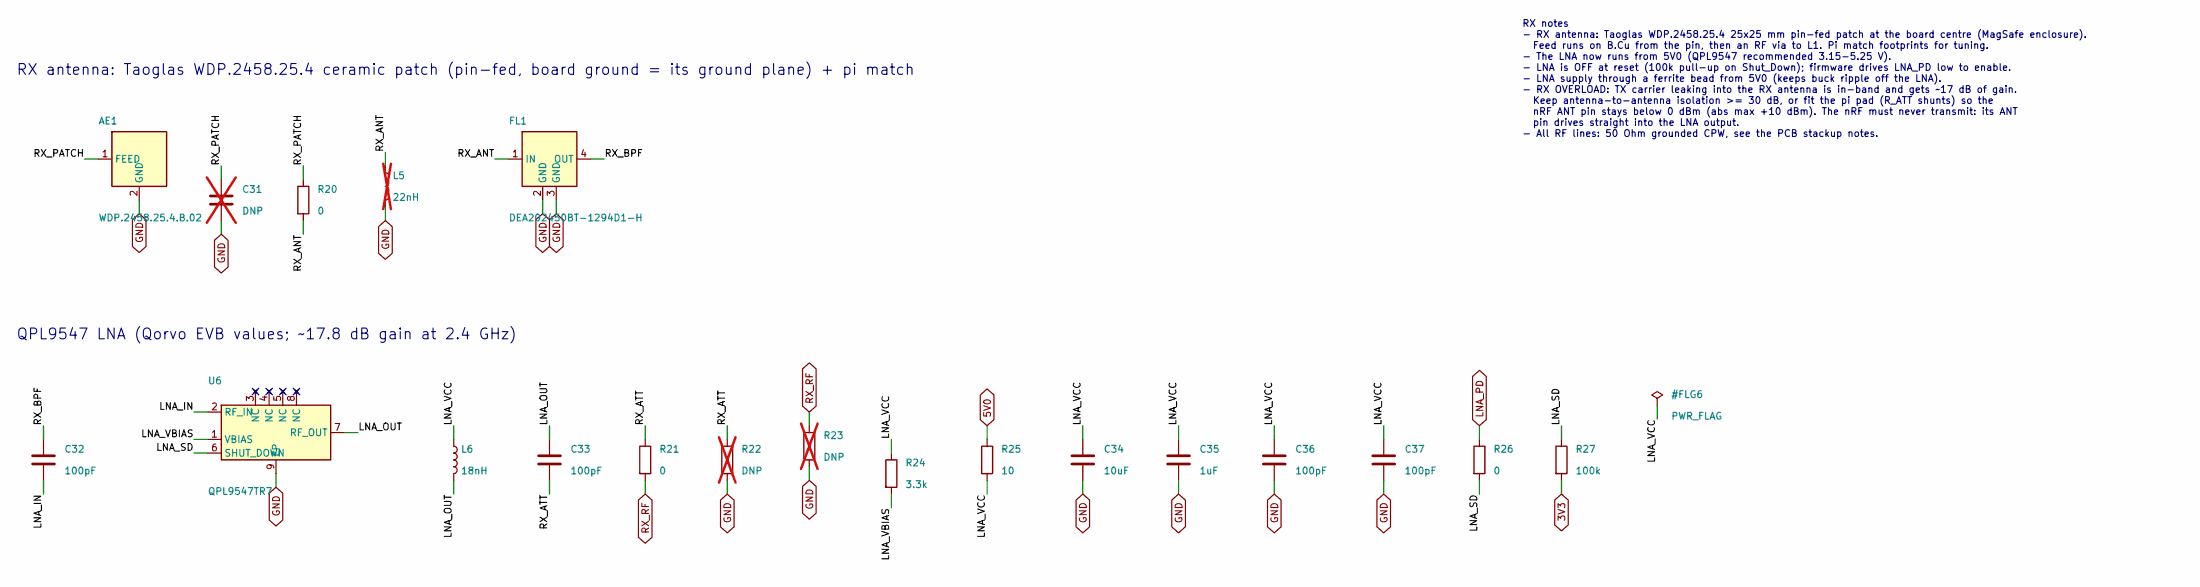
[picture p71: schematic RX_Frontend.kicad_sch, RX chain: antenna, BPF, QPL9547 LNA]

Parts:
AE1: WDP.2458.25.4.B.02; AE1_Taoglas_WDP.2458.25.4_Patch; MPN WDP.2458.25.4.B.02
C31: DNP; C31_C_0402_1005Metric; not fitted
C32: 100pF; C32_C_0402_1005Metric
C33: 100pF; C33_C_0402_1005Metric
C34: 10uF; C34_C_0603_1608Metric
C35: 1uF; C35_C_0402_1005Metric
C36: 100pF; C36_C_0402_1005Metric
C37: 100pF; C37_C_0402_1005Metric
FL1: DEA202450BT-1294D1-H; FL1_TDK_DEA202450BT-1294D1-H_2012; MPN DEA202450BT-1294D1-H; LCSC C1512913
L5: 22nH; L5_L_0402_1005Metric; MPN LQW15AN22NJ00D; not fitted
L6: 18nH; L6_L_0402_1005Metric; MPN 0402CS-18NXGRW
R20: 0; R20_R_0402_1005Metric
R21: 0; R21_R_0402_1005Metric
R22: DNP; R22_R_0402_1005Metric; not fitted
R23: DNP; R23_R_0402_1005Metric; not fitted
R24: 3.3k; R24_R_0402_1005Metric
R25: 10; R25_R_0603_1608Metric
R26: 0; R26_R_0402_1005Metric
R27: 100k; R27_R_0402_1005Metric
U6: QPL9547TR7; U6_Qorvo_QPL9547_DFN-8-1EP_2x2mm_P0.5mm; MPN QPL9547TR7

Connections:
3V3: R27.2; also elsewhere on the board
5V0: R25.1; also elsewhere on the board
/RX_Frontend/LNA_IN: C32.2, U6.2 (RF_IN)
/RX_Frontend/LNA_OUT: C33.1, L6.2, U6.7 (RF_OUT)
/RX_Frontend/LNA_SD: R26.2, R27.1, U6.6 (SHUT_DOWN)
/RX_Frontend/LNA_VBIAS: R24.2, U6.1 (VBIAS)
/RX_Frontend/LNA_VCC: C34.1, C35.1, C36.1, C37.1, L6.1, R24.1, R25.2
/RX_Frontend/RX_ANT: FL1.1 (IN), L5.1, R20.2
/RX_Frontend/RX_ATT: C33.2, R21.1, R22.1
/RX_Frontend/RX_BPF: C32.1, FL1.4 (OUT)
/RX_Frontend/RX_PATCH: AE1.1 (FEED), C31.1, R20.1
GND: AE1.2 (GND), C31.2, C34.2, C35.2, C36.2, C37.2, FL1.2 (GND), FL1.3 (GND), L5.2, R22.2, R23.2, U6.9 (EP); also elsewhere on the board
LNA_PD: R26.1; also elsewhere on the board
RX_RF: R21.2, R23.1; also elsewhere on the board

Notes on the sheet:
RX antenna: Taoglas WDP.2458.25.4 ceramic patch (pin-fed, board ground = its ground plane) + pi match
QPL9547 LNA (Qorvo EVB values; ~17.8 dB gain at 2.4 GHz)
RX notes - RX antenna: Taoglas WDP.2458.25.4 25x25 mm pin-fed patch at the board centre (MagSafe enclosure). Feed runs on B.Cu from the pin, then an RF via to L1. Pi match footprints for tuning. - The LNA now runs from 5V0 (QPL9547 recommended 3.15-5.25 V). - LNA is OFF at reset (100k pull-up on Sh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
