Matthew-Marsicano/BEACON_PhoneModule/BEACON_PhoneModule.kicad_pcb

## KiCad design BEACON_PhoneModule.kicad_pcb (continued)

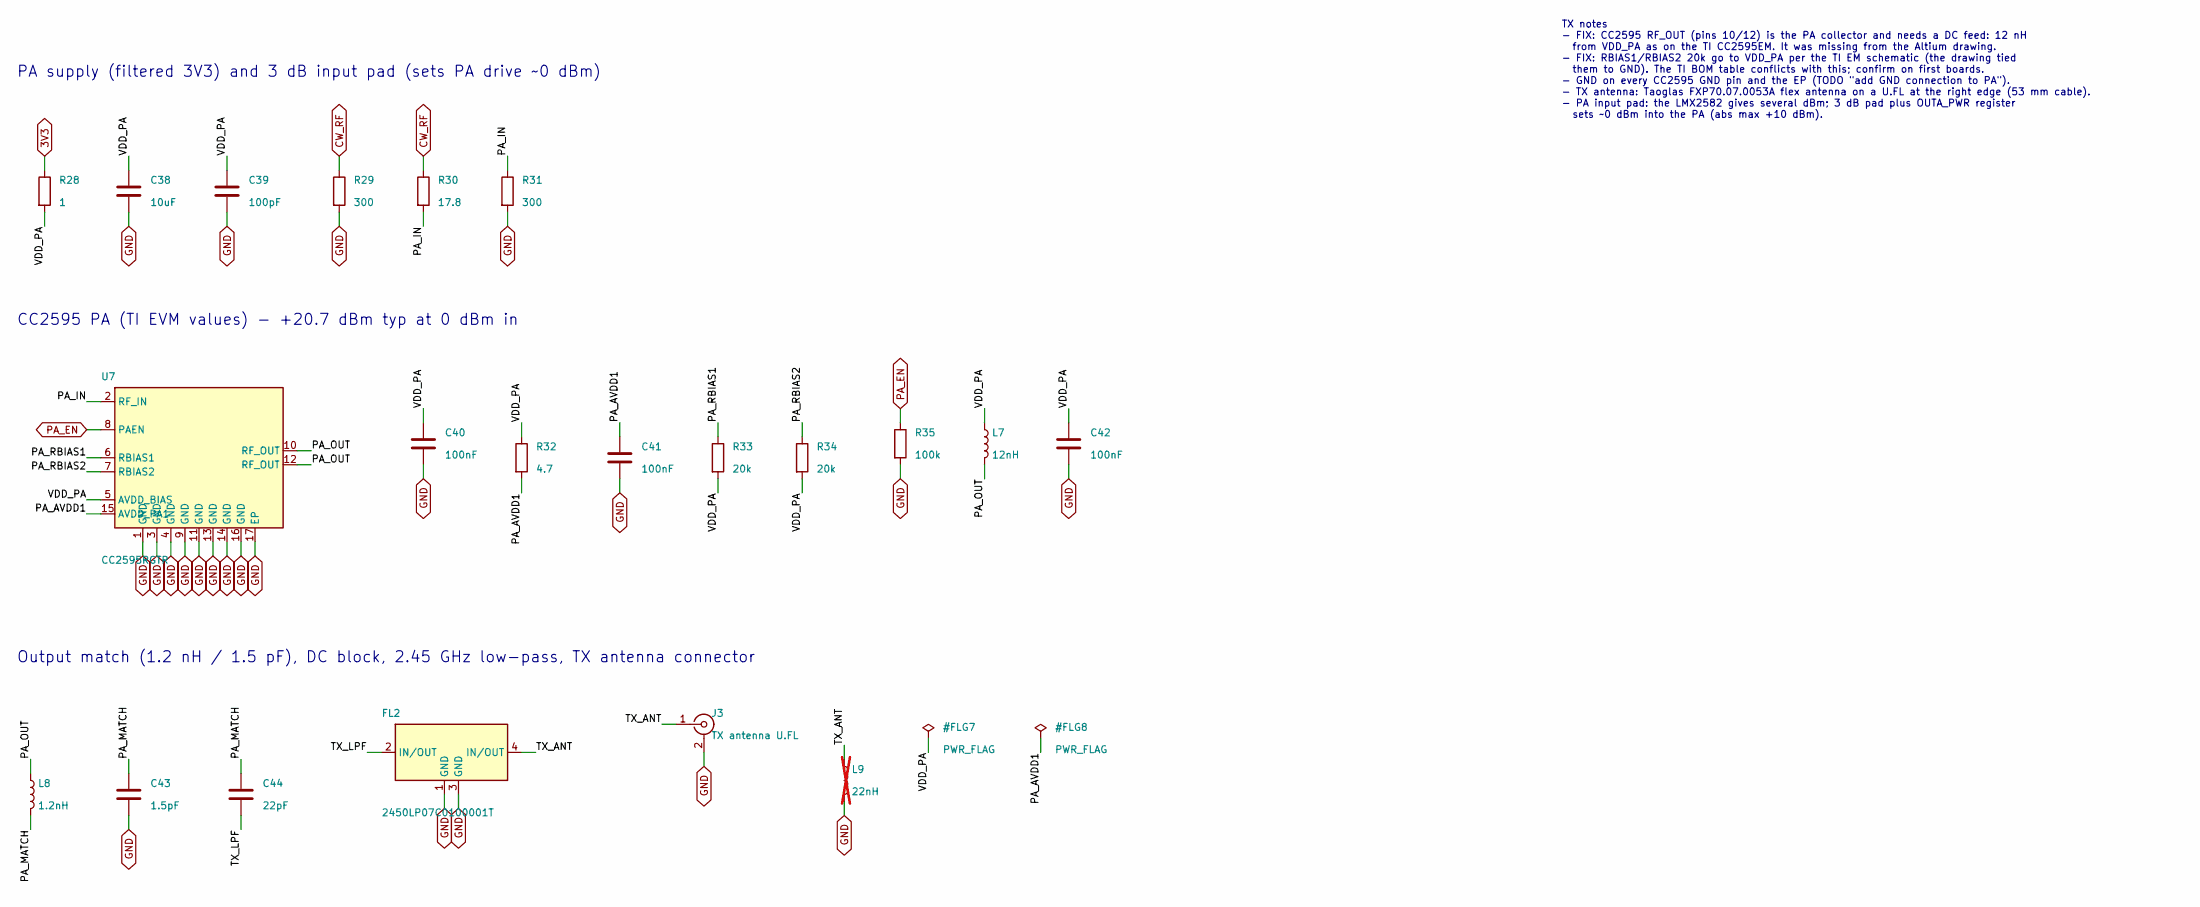
[picture p72: schematic TX_PA.kicad_sch, TX chain: pad, CC2595 PA, LPF, antenna]

Parts:
C38: 10uF; C38_C_0603_1608Metric
C39: 100pF; C39_C_0402_1005Metric
C40: 100nF; C40_C_0402_1005Metric
C41: 100nF; C41_C_0402_1005Metric
C42: 100nF; C42_C_0402_1005Metric
C43: 1.5pF; C43_C_0402_1005Metric; MPN 0402CG1R5C500NT
C44: 22pF; C44_C_0402_1005Metric
FL2: 2450LP07C0100001T; FL2_Johanson_2450LP07_0402_4T; MPN 2450LP07C0100001T
J3: TX antenna U.FL; J3_U.FL_Hirose_U.FL-R-SMT-1_Vertical; MPN U.FL-R-SMT-1(10)
L7: 12nH; L7_L_0402_1005Metric; MPN LQW15AN12NG00D; LCSC C86128
L8: 1.2nH; L8_L_0402_1005Metric; MPN LQG15HS1N2B02D; LCSC C488336
L9: 22nH; L9_L_0402_1005Metric; MPN LQW15AN22NJ00D; not fitted
R28: 1; R28_R_0603_1608Metric
R29: 300; R29_R_0402_1005Metric
R30: 17.8; R30_R_0402_1005Metric
R31: 300; R31_R_0402_1005Metric
R32: 4.7; R32_R_0402_1005Metric
R33: 20k; R33_R_0402_1005Metric
R34: 20k; R34_R_0402_1005Metric
R35: 100k; R35_R_0402_1005Metric
U7: CC2595RGTR; U7_VQFN-16-1EP_3x3mm_P0.5mm_EP1.68x1.68mm_ThermalVias; MPN CC2595RGTR

Connections:
3V3: R28.1; also elsewhere on the board
/TX_PA/PA_AVDD1: C41.1, R32.2, U7.15 (AVDD_PA1)
/TX_PA/PA_IN: R30.2, R31.1, U7.2 (RF_IN)
/TX_PA/PA_MATCH: C43.1, C44.1, L8.2
/TX_PA/PA_OUT: L7.2, L8.1, U7.10 (RF_OUT), U7.12 (RF_OUT)
/TX_PA/PA_RBIAS1: R33.1, U7.6 (RBIAS1)
/TX_PA/PA_RBIAS2: R34.1, U7.7 (RBIAS2)
/TX_PA/TX_ANT: FL2.4 (IN/OUT), J3.1 (In), L9.1
/TX_PA/TX_LPF: C44.2, FL2.2 (IN/OUT)
/TX_PA/VDD_PA: C38.1, C39.1, C40.1, C42.1, L7.1, R28.2, R32.1, R33.2, R34.2, U7.5 (AVDD_BIAS)
CW_RF: R29.1, R30.1; also elsewhere on the board
GND: C38.2, C39.2, C40.2, C41.2, C42.2, C43.2, FL2.1 (GND), FL2.3 (GND), J3.2 (Ext), L9.2, R29.2, R31.2, R35.2, U7.1 (GND), U7.3 (GND), U7.4 (GND), U7.9 (GND), U7.11 (GND), U7.13 (GND), U7.14 (GND), U7.16 (GND), U7.17 (EP); also elsewhere on the board
PA_EN: R35.1, U7.8 (PAEN); also elsewhere on the board

Notes on the sheet:
PA supply (filtered 3V3) and 3 dB input pad (sets PA drive ~0 dBm)
CC2595 PA (TI EVM values) - +20.7 dBm typ at 0 dBm in
Output match (1.2 nH / 1.5 pF), DC block, 2.45 GHz low-pass, TX antenna connector
TX notes - FIX: CC2595 RF_OUT (pins 10/12) is the PA collector and needs a DC feed: 12 nH from VDD_PA as on the TI CC2595EM. It was missing from the Altium drawing. - FIX: RBIAS1/RBIAS2 20k go to VDD_PA per the TI EM schematic (the drawing tied them to GND). The TI BOM table conflicts with this; co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

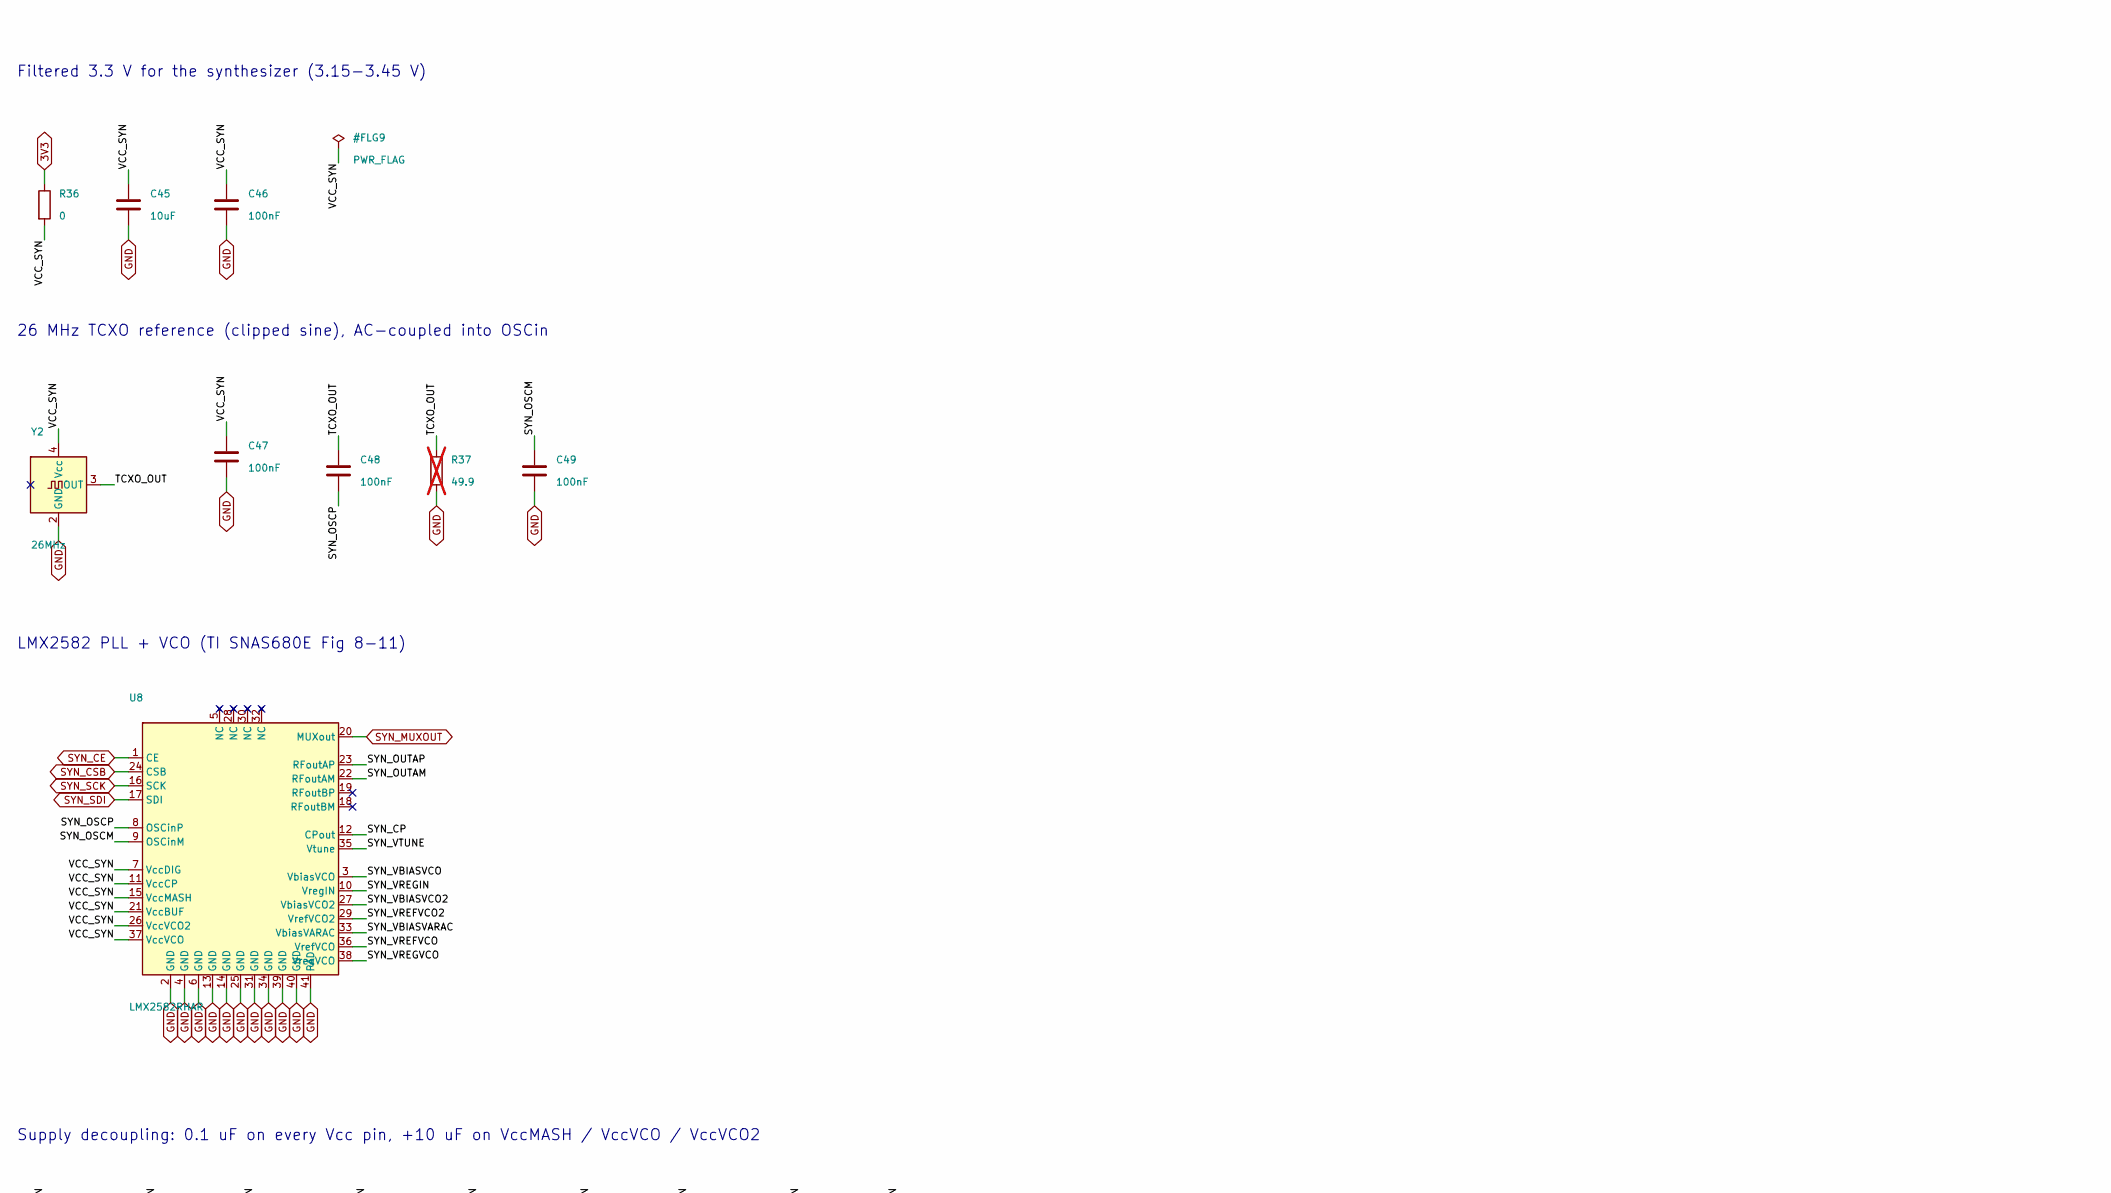
[picture p73: schematic CW_Synth.kicad_sch, CW synthesizer: LMX2582 + TCXO, part in row 1, column 1]

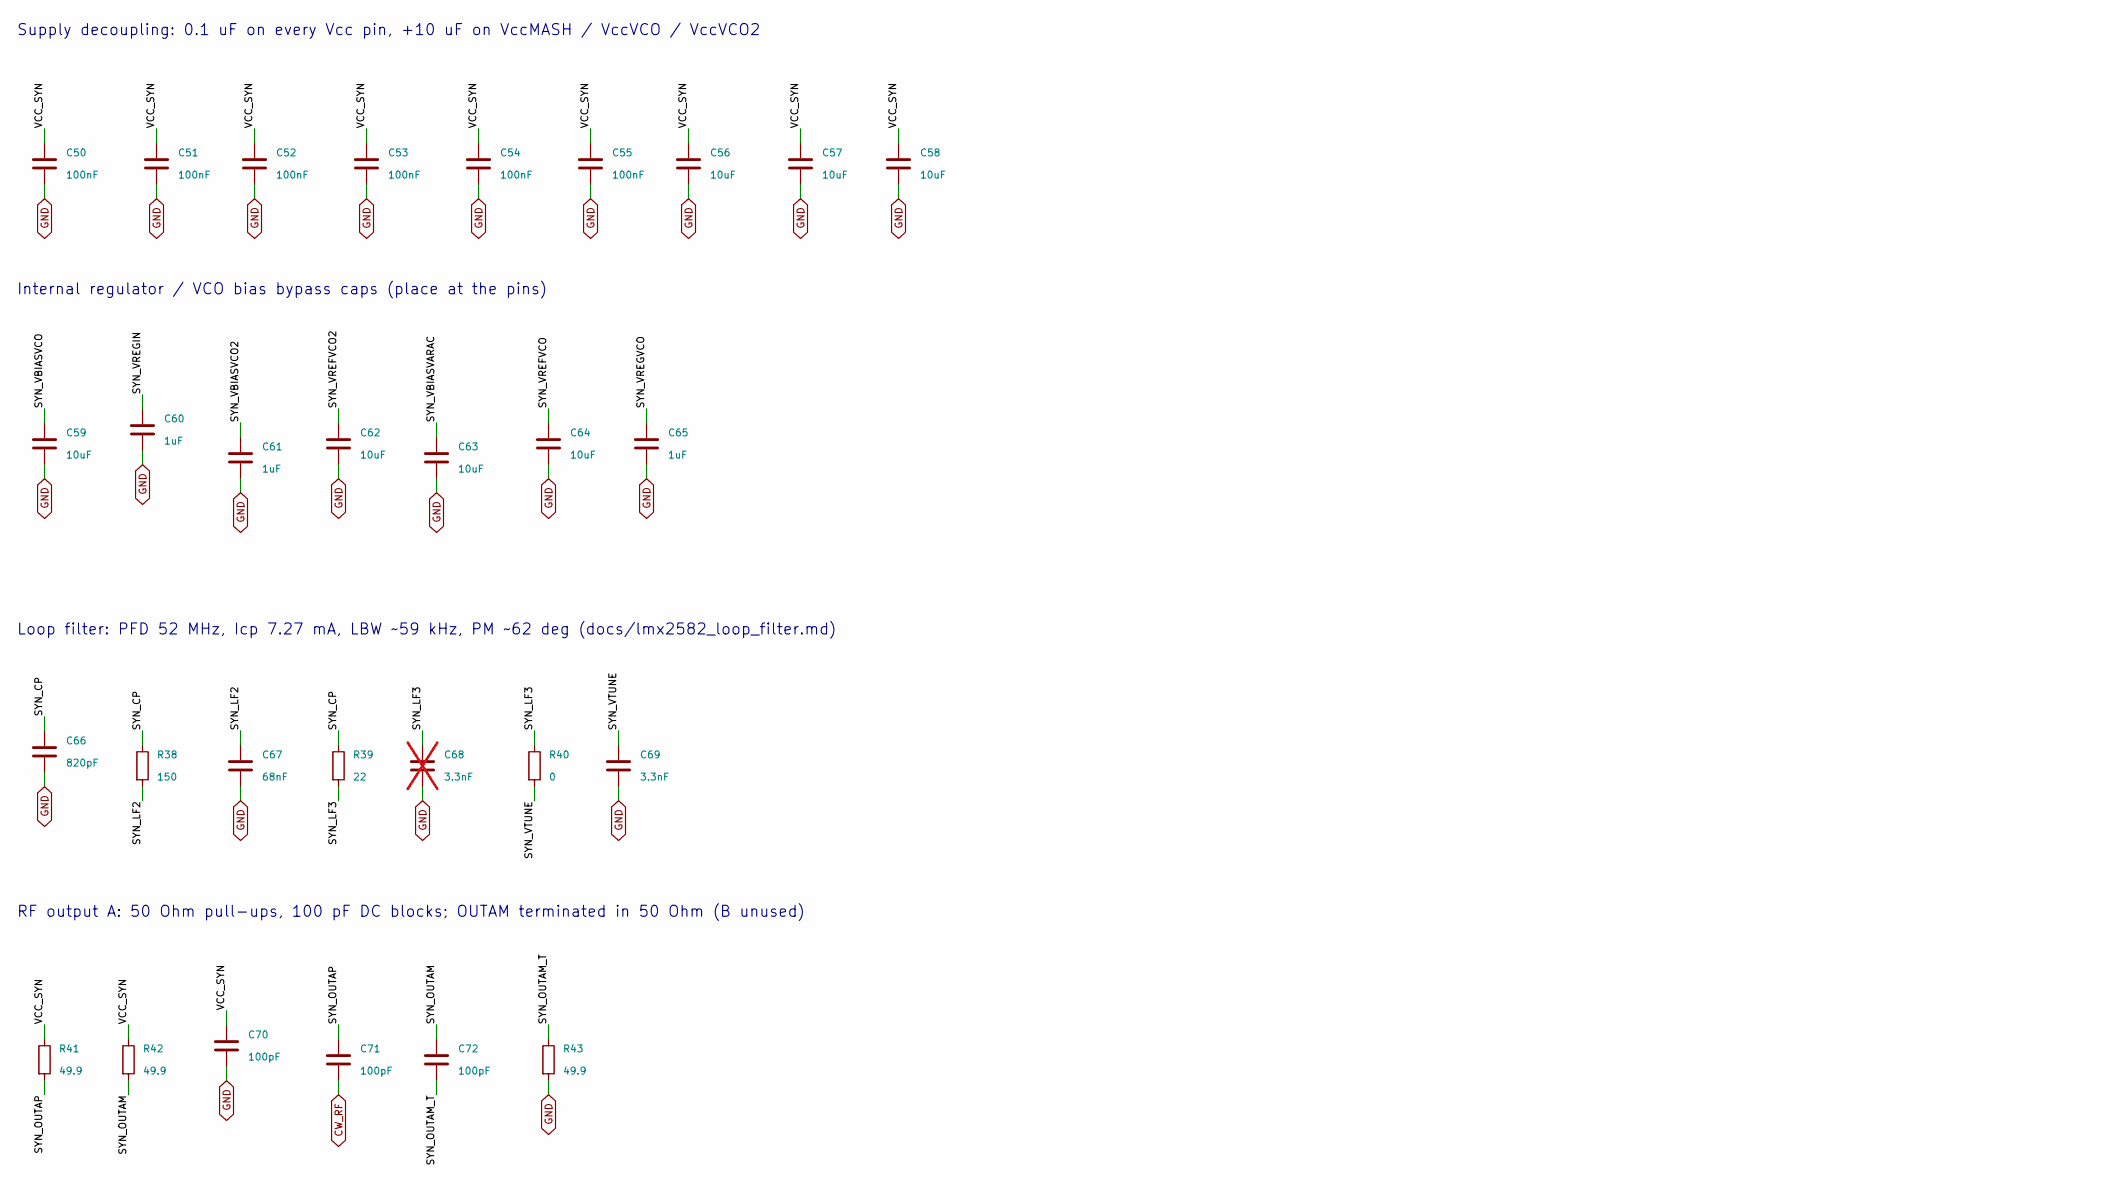
[picture p74: schematic CW_Synth.kicad_sch, CW synthesizer: LMX2582 + TCXO, part in row 2, column 1]

Parts:
C45: 10uF; C45_C_0603_1608Metric
C46: 100nF; C46_C_0402_1005Metric
C47: 100nF; C47_C_0402_1005Metric
C48: 100nF; C48_C_0402_1005Metric
C49: 100nF; C49_C_0402_1005Metric
C50: 100nF; C50_C_0402_1005Metric
C51: 100nF; C51_C_0402_1005Metric
C52: 100nF; C52_C_0402_1005Metric
C53: 100nF; C53_C_0402_1005Metric
C54: 100nF; C54_C_0402_1005Metric
C55: 100nF; C55_C_0402_1005Metric
C56: 10uF; C56_C_0603_1608Metric
C57: 10uF; C57_C_0603_1608Metric
C58: 10uF; C58_C_0603_1608Metric
C59: 10uF; C59_C_0603_1608Metric
C60: 1uF; C60_C_0402_1005Metric
C61: 1uF; C61_C_0402_1005Metric
C62: 10uF; C62_C_0603_1608Metric
C63: 10uF; C63_C_0603_1608Metric
C64: 10uF; C64_C_0603_1608Metric
C65: 1uF; C65_C_0402_1005Metric
C66: 820pF; C66_C_0402_1005Metric
C67: 68nF; C67_C_0603_1608Metric; MPN CL10B683KB8NNNC; LCSC C31658
C68: 3.3nF; C68_C_0402_1005Metric; not fitted
C69: 3.3nF; C69_C_0402_1005Metric
C70: 100pF; C70_C_0402_1005Metric
C71: 100pF; C71_C_0402_1005Metric
C72: 100pF; C72_C_0402_1005Metric
R36: 0; R36_R_0603_1608Metric
R37: 49.9; R37_R_0402_1005Metric; not fitted
R38: 150; R38_R_0402_1005Metric
R39: 22; R39_R_0402_1005Metric
R40: 0; R40_R_0402_1005Metric
R41: 49.9; R41_R_0402_1005Metric
R42: 49.9; R42_R_0402_1005Metric
R43: 49.9; R43_R_0402_1005Metric
U8: LMX2582RHAR; U8_Texas_RHA_VQFN-40-1EP_6x6mm_P0.5mm_EP4.6x4.6mm_ThermalVi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; MPN LMX2582RHAR
Y2: 26MHz; Y2_Oscillator_SMD_SeikoEpson_TG2520SMN-xxx-xxxxxx-4Pin_2.5x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; MPN X1G0054210204; LCSC C7527389

Connections:
3V3: R36.1; also elsewhere on the board
/CW_Synth/SYN_CP: C66.1, R38.1, R39.1, U8.12 (CPout)
/CW_Synth/SYN_LF2: C67.1, R38.2
/CW_Synth/SYN_LF3: C68.1, R39.2, R40.1
/CW_Synth/SYN_OSCM: C49.1, U8.9 (OSCinM)
/CW_Synth/SYN_OSCP: C48.2, U8.8 (OSCinP)
/CW_Synth/SYN_OUTAM: C72.1, R42.2, U8.22 (RFoutAM)
/CW_Synth/SYN_OUTAM_T: C72.2, R43.1
/CW_Synth/SYN_OUTAP: C71.1, R41.2, U8.23 (RFoutAP)
/CW_Synth/SYN_VBIASVARAC: C63.1, U8.33 (VbiasVARAC)
/CW_Synth/SYN_VBIASVCO: C59.1, U8.3 (VbiasVCO)
/CW_Synth/SYN_VBIASVCO2: C61.1, U8.27 (VbiasVCO2)
/CW_Synth/SYN_VREFVCO: C64.1, U8.36 (VrefVCO)
/CW_Synth/SYN_VREFVCO2: C62.1, U8.29 (VrefVCO2)
/CW_Synth/SYN_VREGIN: C60.1, U8.10 (VregIN)
/CW_Synth/SYN_VREGVCO: C65.1, U8.38 (VregVCO)
/CW_Synth/SYN_VTUNE: C69.1, R40.2, U8.35 (Vtune)
/CW_Synth/TCXO_OUT: C48.1, R37.1, Y2.3 (OUT)
/CW_Synth/VCC_SYN: C45.1, C46.1, C47.1, C50.1, C51.1, C52.1, C53.1, C54.1, C55.1, C56.1, C57.1, C58.1, C70.1, R36.2, R41.1, R42.1, U8.7 (VccDIG), U8.11 (VccCP), U8.15 (VccMASH), U8.21 (VccBUF), U8.26 (VccVCO2), U8.37 (VccVCO), Y2.4 (Vcc)
CW_RF: C71.2; also elsewhere on the board
GND: C45.2, C46.2, C47.2, C49.2, C50.2, C51.2, C52.2, C53.2, C54.2, C55.2, C56.2, C57.2, C58.2, C59.2, C60.2, C61.2, C62.2, C63.2, C64.2, C65.2, C66.2, C67.2, C68.2, C69.2, C70.2, R37.2, R43.2, U8.2 (GND), U8.4 (GND), U8.6 (GND), U8.13 (GND), U8.14 (GND), U8.25 (GND), U8.31 (GND), U8.34 (GND), U8.39 (GND), U8.40 (GND), U8.41 (PAD), Y2.2 (GND); also elsewhere on the board
SYN_CE: U8.1 (CE); also elsewhere on the board
SYN_CSB: U8.24 (CSB); also elsewhere on the board
SYN_MUXOUT: U8.20 (MUXout); also elsewhere on the board
SYN_SCK: U8.16 (SCK); also elsewhere on the board
SYN_SDI: U8.17 (SDI); also elsewhere on the board

Notes on the sheet:
Filtered 3.3 V for the synthesizer (3.15-3.45 V)
26 MHz TCXO reference (clipped sine), AC-coupled into OSCin
LMX2582 PLL + VCO (TI SNAS680E Fig 8-11)
Supply decoupling: 0.1 uF on every Vcc pin, +10 uF on VccMASH / VccVCO / VccVCO2
Internal regulator / VCO bias bypass caps (place at the pins)
Loop filter: PFD 52 MHz, Icp 7.27 mA, LBW ~59 kHz, PM ~62 deg (docs/lmx2582_loop_filter.md)
RF output A: 50 Ohm pull-ups, 100 pF DC blocks; OUTAM terminated in 50 Ohm (B unused)
CW synthesizer notes (completed from the TI typical application) - Carrier: 2400-2483.5 MHz ISM. VCO 3.55-7.1 GHz, CHDIV=2 -> 2.4 GHz on OUTA. - Reference: 26 MHz TCXO. The PFD can use the OSCin doubler (52 MHz) in fractional mode. - SPI: SCK/SDI/CSB from the nRF52840; MUXout = lock detect or SPI r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

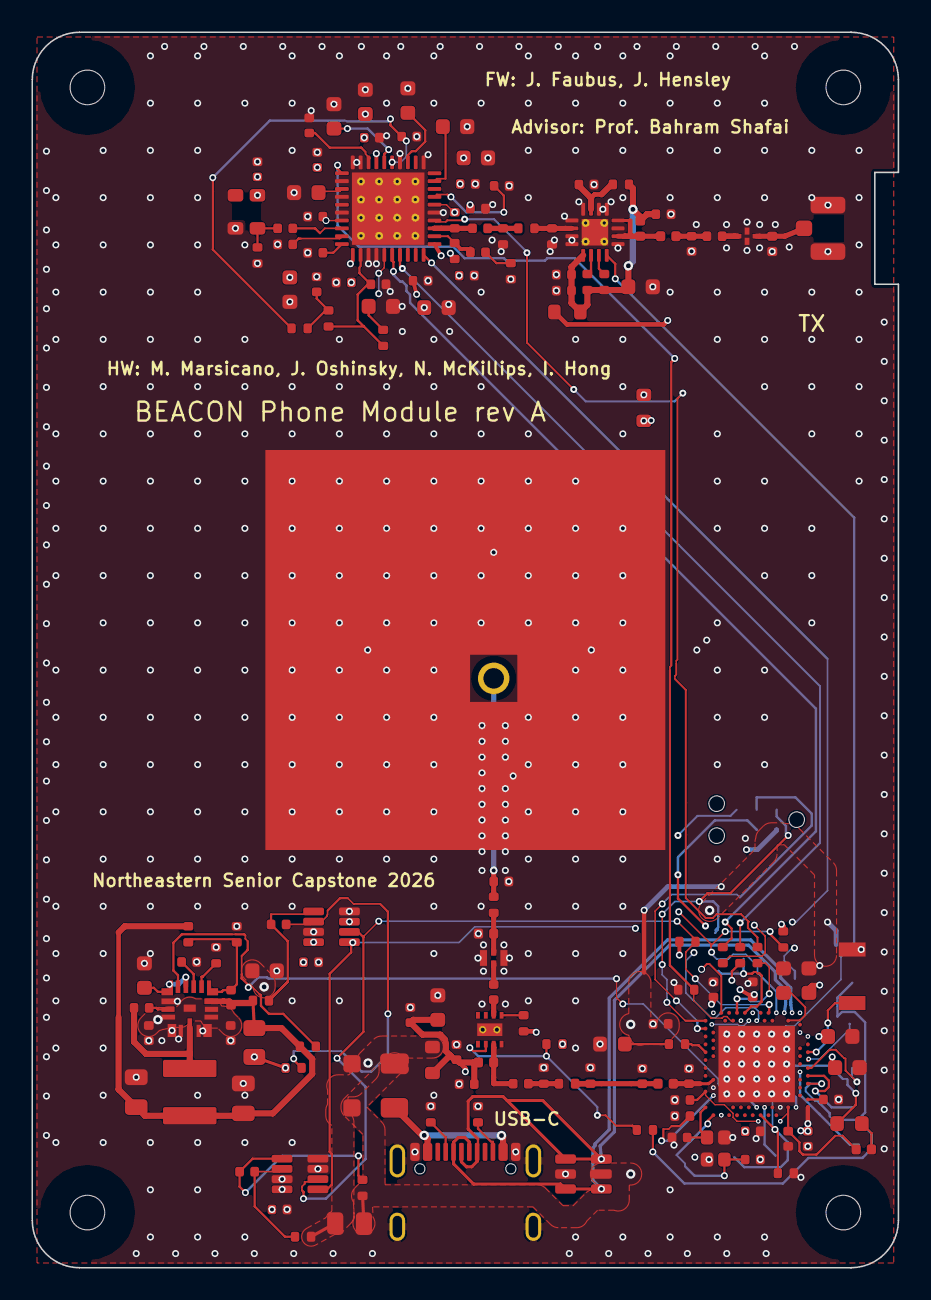
[picture p75: board BEACON_PhoneModule.kicad_pcb from above]

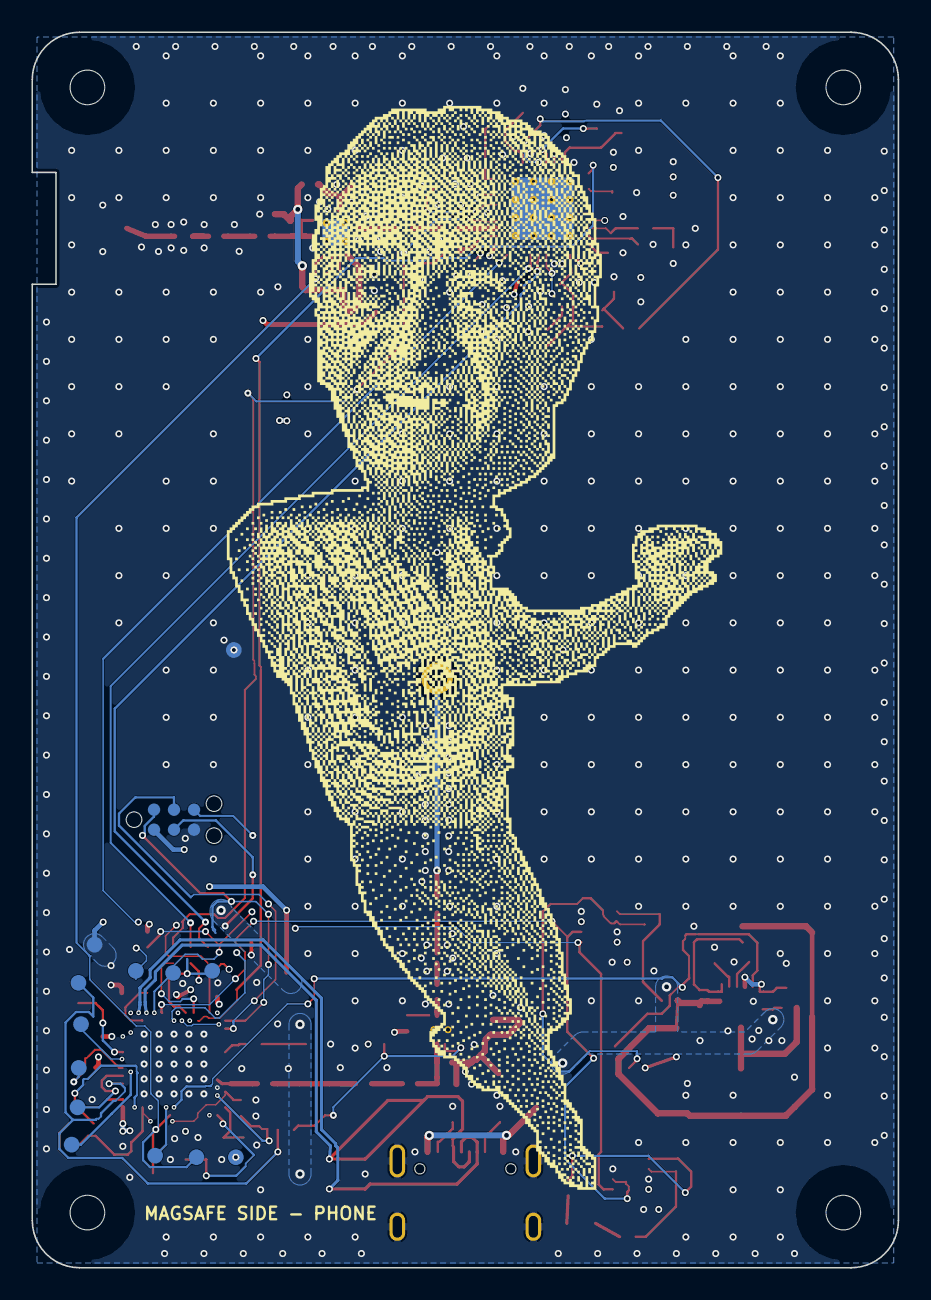
[picture p76: board BEACON_PhoneModule.kicad_pcb from below]

Board: 4 copper layers, 55.0 x 78.4 mm, 161 parts (14 on the bottom side), 92 nets.
