Matthew-Marsicano/BEACON_PhoneModule/(commit log)

2026-11-03 BEACON phone module: schematics, 4-layer layout, rules, docs and enclosure
    KiCad 10 project. GND, 3V3, VCC_SYN and 5V on fills/planes with pad vias,
    USB D+/D- and RF chains routed and locked. 8 signal connections still to
    route by hand (see README and issues).
    [BEACON_PhoneModule.kicad_pcb, BEACON_PhoneModule.kicad_sch, BEACON_PhoneModule_JLCPCB_BOM.csv, CW_Synth.kicad_sch, MCU.kicad_sch, Power.kicad_sch, RX_Frontend.kicad_sch, TX_PA.kicad_sch]
2026-11-03 Finish routing, add GND via stitching, connect C18 GND
    Remaining signal connections routed. GND stitching added: RF via fences,
    board-perimeter and 3 mm grid (693 vias total). C18 pad 2 GND island now
    has its own via; redundant 3V3 segments on L3 removed (plane connects them).
    DRC: 0 errors, 0 warnings, 0 unconnected.
    stitch.py keeps stitching vias off the 5V power fills; bridge_fills.py checks
    clearance on every layer a new via passes through.
    [BEACON_PhoneModule.kicad_pcb]
2026-11-03 JLCPCB fab package, silkscreen clean-up, drill/place origin
    fab/: Gerbers + Excellon drill (zipped), JLC BOM and CPL, schematic and
    assembly PDFs, STEP. Drill/place origin set to the board's bottom-left
    corner; Gerbers, drill files and CPL all use it. Reference designators
    moved to the Fab layers, board labels on silkscreen. Logo footprint added
    to the BEACON library.
    DRC: 0 errors, 0 unconnected. Still to do before ordering: LCSC number for
    J3 (Hirose U.FL-R-SMT-1(10)), check part rotations in the JLC viewer.
    [BEACON_PhoneModule-B_Cu.gbl, BEACON_PhoneModule-B_Mask.gbs, BEACON_PhoneModule-B_Paste.gbp, BEACON_PhoneModule-B_Silkscreen.gbo, BEACON_PhoneModule-Edge_Cuts.gm1, BEACON_PhoneModule-F_Cu.gtl, BEACON_PhoneModule-F_Mask.gts, BEACON_PhoneModule-F_Paste.gtp]
2026-11-03 Add one-zip JLCPCB bundle with order sheet
    fab/BEACON_PhoneModule_JLCPCB.zip holds the Gerber/drill zip, JLC BOM and
    CPL, and JLCPCB_ORDER.txt with the board options (impedance stackup,
    POFV via-in-pad, ENIG) and the parts that need attention (J3, AE1).
    Gerber zip no longer includes the drill-map drawings. export_fab.py now
    builds the bundle (scripts/jlc_bundle.py).
    [export_fab.py, jlc_bundle.py]
2026-11-03 JLCPCB bundle: number files in upload order, unzip-first note
    JLC reports 0 layers when the package zip itself is uploaded as the
    Gerber file, because the Gerbers are in a zip inside it. Files inside the
    package are now numbered by upload step and the order sheet starts with
    an unzip-first note.
2026-11-03 Move board title and team names to the front silkscreen
    Title, HW/FW team, advisor and capstone line now sit in free bands on the
    front (between the stitching-via rows), clear of pads and parts. MAGSAFE
    SIDE label moved off the back logo; USB-C label moved off R25/L6/C36.
    Fab package and JLCPCB bundle re-exported.
    [BEACON_PhoneModule-B_Cu.gbl, BEACON_PhoneModule-B_Mask.gbs, BEACON_PhoneModule-B_Paste.gbp, BEACON_PhoneModule-B_Silkscreen.gbo, BEACON_PhoneModule-Edge_Cuts.gm1, BEACON_PhoneModule-F_Cu.gtl, BEACON_PhoneModule-F_Mask.gts, BEACON_PhoneModule-F_Paste.gtp]
2026-11-03 Add JLCPCB ordering instructions as fab/JLCPCB_ORDER.md
    The order sheet (files to upload, board options, assembly checks) is now a
    Markdown file next to the fab outputs, linked from the README. The same
    text goes into the JLCPCB package zip; both come from scripts/jlc_bundle.py.
2026-11-04 Add wearable JLCPCB package under fab/wearable
    Gerber/drill zip, JLC BOM and CPL exported from the wearable's Altium
    project (commit 66d48ca, "Added silkscreen") with the included OutJob:
    4 layers, 30 x 30 mm R3, metric 4:4, origin at the bottom-left corner.
    The outline comes from the board shape (the Mech 1 outline in the PcbDoc
    is missing its top edge). CPL uses pad centroids, J3 from Altium's
    pick-and-place; 82 parts, 32 top / 50 bottom.
    fab/wearable/JLCPCB_ORDER.md lists upload steps, board options (0.8 mm,
    JLC04081H-7628, ENIG), parts to pre-order or consign, and the open DFM
    item: copper pours reach the board edge on all four layers.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
    [BEACON_Wearable_BOM_JLC.csv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]
2026-11-04 Add combined phone module + wearable JLC panel; wearable needs POFV
    fab/panel/: 100 x 92.45 mm, 4-layer panel with one phone module and one
    wearable, merged at the Gerber level from each board's released fab files
    (no design changes). 5 mm rails, 2 mm milled slots, 11 mouse-bite tabs
    placed at least 3 mm from any part, 3 fiducials per side. Merged BOM/CPL
    use _P/_W designator suffixes and share 16 LCSC parts (90 unique instead
    of 106). Wearable B1 and L3 swapped to in-stock JLC parts (C2865392,
    C370621). PANEL_ORDER.md has the order settings; scripts/ rebuilds the
    panel, BOM/CPL and preview renders.
    fab/wearable/JLCPCB_ORDER.md: via covering must be epoxy filled & capped.
    55 vias sit inside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
    [BEACON_Panel_BOM_JLC.csv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]
2026-11-04 Add wearable-only assembly files for the panel
    Fabricate the whole panel but have JLC assemble only the wearable (both
    sides); the phone module stays bare for hand assembly.
    - BEACON_Panel_BOM_JLC_wearable_only.csv / _CPL_: the 82 `_W` parts
    (32 top, 50 bottom, 44 LCSC lines) in panel coordinates.
    - BEACON_Panel_gerbers_wearable_assembly.zip (+ gerbers_wearable_assembly/):
    same as the panel Gerbers except the paste layers hold only the
    wearable's pads, so the stencil prints no solder on the phone module.
    - scripts/wearable_only.py and wearable_only_paste.py regenerate them;
    PANEL_ORDER.md describes the option.
    [BEACON_Panel_BOM_JLC_wearable_only.csv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]
2026-11-05 Wearable: conformal Top Solder openings on the RF switch outputs
    Re-export the wearable JLC Gerbers after the Top Solder fix on the four
    HMC190B switch-to-series-cap doglegs (NetC11_1, NetC13_1, NetC16_1,
    NetC17_1). The stair-stepped, off-centre rectangle openings are replaced
    by one region per bend that follows the trace at +/-0.625 mm with round
    joins, keeps a 0.105 mm mask web to other-net pads/vias/traces and the
    0.2 mm web across the 0402 caps.
    Only PCB1.GTS changes geometrically (XOR 3.35 mm2, x 18.8-22.3,
    y 1.0-15.0 mm); all other layers and both drill files are geometrically
    identical to the previous export. The combined panel and its
    wearable-only assembly variant are rebuilt with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
    [PCB1.GBL, PCB1.GBO, PCB1.GBP, PCB1.GBS, PCB1.GTL, PCB1.GTO, PCB1.GTP, PCB1.GTS]
2026-11-05 Wearable: DRC cleanup, BEACON silkscreen, bottom art removed
    Re-export the wearable JLC Gerbers from PCB1.PcbDoc saved 2026-11-04 23:36
    (0 DRC violations, 37 waived).
    - Remove two GND vias inside the M2.5 mounting-hole pad (short to the
    netless pad) and four staggered vias in the J3 U.FL fence that broke
    the 0.254 mm hole-to-hole and 0.1 mm mask sliver rules; nudge one more.
    296 -> 290 drill holes, J3 ground pads keep 18 vias.
    - Add "BEACON / Backscatter-Enabled Ambient / Cardiac Observation Node"
    on the top silkscreen along the top edge.
    - Bottom silkscreen artwork removed; GBO has designators/outlines only.
    BOM, CPL and OutJob unchanged. fab/panel is not rebuilt.
    [PCB1.GBL, PCB1.GBO, PCB1.GBP, PCB1.GBS, PCB1.GTL, PCB1.GTO, PCB1.GTP, PCB1.GTS]
